foukouda/OPEN_PHASE/Schematic/OPEN_PHASE-schematic-10.pdf

1 | 2 | 3 | 4 | 5 | 6 | 7 | 8
1 | 2 | 3 | 4 | 5 | 6 | 7 | 8

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
F 10

Sheet: of 10
Size: A3
Revision: + (Unreleased) Date: Project Name: 2026-10-05 Reviewer: Designer: Revision History.kicad_sch | SIEBERT DIMITRY
Board Name: Company: | Variant: OPEN THRUST LAB PHASETRACKER | OPEN_PHASE
Sheet Title: | File Name:
/Revision History/ Sheet Path: Revision History Comments: | Git Hash: 04dd92c

___________________________________ Added

- 4x PBV 1 mOhm shunt + INA241A2 (20 V/V)
- 4x voltage divider 40.2k / 10k
- AD7606C-18 ADC, 8 inputs used
- +3.3V -> LT8362 6 V -> LT3045-1 +5VA / +2.5VA
- Self-contained libs and 3D models (lib/)
- LTspice simulations (Simulation/LTspice)
- Predicted measurement quality (sim 07, 08)
- openEMS shunt inductance model (Simulation/openEMS)
- Thermal / current density model (Simulation/Thermal)
- 3D animation (Images/OPEN_PHASE.mp4)
- J4 host header 2x8: AD7606C serial, software mode
- Test points TP1-TP16
- 4x rail indicator LED (D1, D3-D5), about 1 mA each
- Silkscreen: rail names at the LEDs, test point tags, OSHW logo
- 100 Ohm in series on the 11 J4 lines: RN1, RN2 (4x0603 array, as OPEN_WEIGHT), R39-R41, bottom side
- 100k pull-up on CS (R42), pull-downs on CONVST (R43) and RESET (R44) ___________________________________ Changed
- Renamed to OPEN_PHASE, KiCad 10
- Sheets named after their function
- IC3: LTC6655LN-2.5 -> LTC6655-2.5 (pin 6 = VOUT_S)
- R12: 49.9k -> 24.9k (+2.5VA = 2.500 V)
- L1: 744373965022 -> WE-MAPI 4030 74438357022 (4.1 x 4.1 mm)
- Solder mask white, silkscreen black
- Nets renamed SHUNT_*, INA_*, ADC_*
- IC1 AGND pin 26, REFGND pin 46 to GND
- IC8, IC9: thermal vias on exposed pad 13
- Licence: MIT -> CERN-OHL-P v2
- README / HTML logo: INGENIERIE FRANCE badge
- TP15 / TP16 on the AD7606C side of the series resistors ___________________________________ Fixed
- +5VA via of R36 sat on the ADC_CS track (short): bus rerouted around it

# [10] Revision History

Version Unreleased
