foukouda/OPEN_PHASE/Schematic/OPEN_PHASE-schematic-5.pdf

1 | 2 | 3 | 4 | 5 | 6 | 7 | 8

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
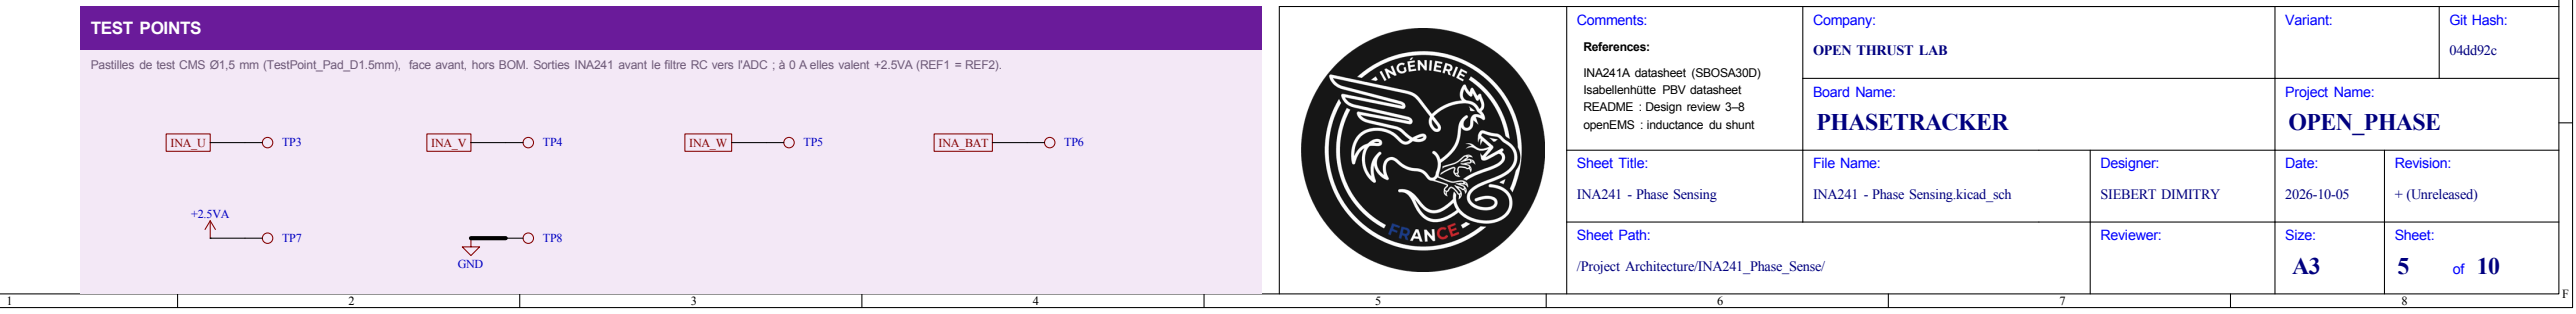
[picture p13: figure]
Sheet: of 10; Size: A3; Sheet Title:; File Name:; GND; INA_W; INA_BAT; INA_U; INA_V; TEST POINTS; openEMS : inductance du shunt; README : Design review 3–8; Isabellenhütte PBV datasheet

Revision: + (Unreleased) Date: Project Name: 2026-10-05 Reviewer: Designer: INA241 - Phase Sensing.kicad_sch | SIEBERT DIMITRY
Board Name: Company: | Variant: OPEN THRUST LAB PHASETRACKER | OPEN_PHASE
/Project Architecture/INA241_Phase_Sense/ Sheet Path: INA241 - Phase Sensing Comments: | Git Hash: 04dd92c

R19
9.1kΩ

R27
40.2kΩ

R32

# 40.2kΩ Re3 1kΩ

+2.5VA

C18 1µF C31

180 pF C0G/NP0, 50 V, 0603

# C17 0.1µF C2 0.1µF R28 10kΩ C40

180 pF C0G/NP0, 50 V, 0603 C34

180 pF C0G/NP0, 50 V, 0603 C10 1µF +2.5VA

R29

# 9.1kΩ R22

40.2kΩ

IN- 1 | GND 2 | REF2 3 | NC 4 | OUT | 5 VS | 6 REF1 | 7
| | | | IN+ | | | 8

IC2
INA241A2IDGKR

1

1

2

2

3

3

4

4 R1 PBV-R001-F1-1.0 +2.5VA

+2.5VA | +5VA
C33 | 1nF C0G

R21
9.1kΩ Re2
1kΩ | C42 | 1nF C0G

+2.5VA

IN- 1 | GND 2 | REF2 3 | NC 4 | OUT | 5 VS | 6 REF1 | 7
| | | | IN+ | | | 8

IC4
INA241A2IDGKR
C16 | 1µFC3 0.1µF
IN- 1 | GND 2 | REF2 3 | NC 4 | OUT | 5 VS | 6 REF1 | 7
| | | | IN+ | | | 8

IC10
INA241A2IDGKR

+2.5VA

+2.5VA

IN- 1 | GND 2 | REF2 3 | NC 4 | OUT | 5 VS | 6 REF1 | 7
| | | | IN+ | | | 8

IC6
INA241A2IDGKR

R18 10kΩ

+5VA

R15
33Ω

+5VA

R16

# 9.1kΩ R20

33Ω C29 | 1nF C0G
C25 | 1nF C0G
C1 0.1µF | R26

# 9.1kΩ R30

33Ω R25
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
4 R7 PBV-R001-F1-1.0 R31

9.1kΩ

1

1

2

2

3

3

4

4 R4 PBV-R001-F1-1.0

1

1

2

2

3

3

4

# 4 R9 PBV-R001-F1-1.0 TP3

C5 | 1µF R23 10kΩ | C32

180 pF C0G/NP0, 50 V, 0603

R17
40.2kΩ

R24
9.1kΩ

+2.5VA

Re4

# 1kΩ R34

9.1kΩ R33 10kΩ

+5VA

Re1
1kΩ

INA_V

SHUNT_U+

# SHUNT_V+ OUT-B

SHUNT_BAT- OUT-W
OUT-W

SHUNT_W-

SHUNT_W+

ADC_U_V+
ADC_U_V-

SHUNT_BAT-

IN-B

IN-W

# SHUNT_W- OUT-B

SHUNT_BAT+

SHUNT_U-

ADC_V_V-

ADC_V_V+

INA_BAT

IN-V

SHUNT_BAT+

ADC_W_V+

SHUNT_V- OUT-U
SHUNT_U+

ADC_W_V-

INA_BAT

OUT-U

ADC_BAT_V+
ADC_BAT_V-

INA_W

SHUNT_W+

OUT-V

ADC_BAT_I+

ADC_W_I+

SHUNT_V-

ADC_W_I-

ADC_V_I-

INA_W

OUT-V
SHUNT_V+
INA_V | ADC_V_I+

ADC_U_I+

ADC_BAT_I-

INA_U

IN-U

INA_U

SHUNT_U-ADC_U_I-

## FILTRES · VOIES COURANT

## DESIGN NOTE · GAIN ET SHUNT

Voie courant (×4) V = 2.5 V − G × Rs × I = 2.5 V − 20 V/V × 1 mΩ × I = 2.5 V − 20 mV/A × I 35 A → ±0.7 V ; saturation vers ±115 A

fc = 1 / (2π × R16 × C25) = 1 / (2π × 9.1 kΩ × 1 nF) = 17.5 kHz Offset : I(V−) = (0 − 2 V) / 1.2 MΩ = −1.7 µA → V− = 1.7 µA × 9.1 kΩ = 15 mV ≈ 0.75 A

Shunt : P = I² × Rs = 35² × 1 mΩ = 1.23 W → +18 K (Rth < 15 K/W)
Inductance : R = 2π f L → f = 1 mΩ / (2π × 2.4 nH) ≈ 66 kHz Voie tension (×4) k = R18 / (R17 + R18) = 10 / 50.2 = 0.1992 → 25 V = 4.98 V

Source : R17 // R18 + Re1 = 8.01 kΩ + 1 kΩ = 9.01 kΩ ≈ R19 = 9.1 kΩ fc = 1 / (2π × (9.01 + 9.1) kΩ × 180 pF) ≈ 48.8 kHz (sim 05 : 48.5 kHz) Gain réel : 0.1992 × 1.2 MΩ / (1.2 MΩ + 9.01 kΩ) = 0.1977 (−0.75 %)

Budget 4 × INA241A2 × 2.5 mA = 10 mA sur +5VA

Pertes : 1.23 W par shunt à 35 A

## DESCRIPTION

## CALCULS & BUDGET

- IN+ / IN− pris sur les broches de mesure 2 et 3 du shunt (Kelvin), pas sur le cuivre de puissance ; paire serrée jusqu'à l'INA241. • Boucle de mesure la plus petite possible : 1 nH vaut R = 1 mΩ à 160 kHz. • C17/C18 au plus près de VS / GND. Filtres près des entrées de l'AD7606C. • Shunt : 1.2 W à 35 A, refroidi par le cuivre des phases. • Exemple TI ci-contre (INA240-Q1, même brochage) : ici REF1/REF2 vont au +2.5VA, pas à la masse.

Mesure du courant des trois phases (U, V, W) et de la batterie (B), et de la tension des mêmes lignes. Le courant traverse un shunt 4 fils de 1 mΩ (R1 / R4 / R7 / R9, Isabellenhütte PBV). L'INA241A2 lit la tension entre les deux broches de mesure du shunt (Kelvin) et l'amplifie 20 fois autour du +2.5VA : V = 2.5 V − 20 mV/A × I(J1→J2), J3→J5 pour la

batterie. Pourquoi l'INA241 : la tension de mode commun d'une phase saute de 0 à VBAT à chaque front du PWM de l'ESC. L'INA241

accepte −5 V à 110 V de mode commun, a un rejet PWM renforcé (CMRR 166 dB DC, 104 dB à 100 kHz), ±10 µV d'offset et ±0.01 % d'erreur de gain (version A). Un pont 40.2 kΩ / 10 kΩ par ligne ramène la tension (côté J2 / J5) dans la plage de l'AD7606C. Noms des signaux, x = U, V, W ou BAT : SHUNT_x± prises Kelvin du shunt vers IN± de l'INA241 → INA_x sortie de l'INA241

(TP3 à TP6) → filtre RC → ADC_x_I± (courant). Pont → ADC_x_V± (tension). Vers l'AD7606C page 4.

INA241A1 : 10 V/V
INA241A2 : 20 V/V (monté)
INA241A3 : 50 V/V
INA241A4 : 100 V/V
INA241A5 : 200 V/V
- Avec 1 mΩ et 20 V/V : 20 mV/A, saturation vers ±115 A. 35 A n'utilise que ±0.7 V des ±2.5 V : un A3 (50 V/V, ±46 A) donnerait 2.5 × plus de résolution (Design review 4). • REF1 = REF2 = +2.5VA : zéro au milieu, mesure dans les deux sens (freinage, récupération). • Shunt PBV-R001 : 1 mΩ 4 fils, < 75 ppm/K, Rth < 15 K/W, inductance < 10 nH (openEMS : 2.3 à 2.7 nH sur ce routage). • NC (broche 4) laissée ouverte : la datasheet demande GND (Design review 3).

## LAYOUT NOTE

## DESIGN NOTE · VOIES VERS L'AD7606C

- Courant : R15 33 Ω isole la sortie de l'INA241 de la capacité. Filtre différentiel : C25 1 nF C0G entre V+ et V−, V− à la masse par R16 9.1 kΩ → 17.5 kHz. • R16 et le courant d'entrée de l'ADC donnent 15 mV d'offset (≈ 0.75 A) : calibration du zéro ; ne pas réduire R16 sans

recalculer le filtre (Design review 5). • Tension : R17 40.2 kΩ / R18 10 kΩ → 0.1992 (25 V → 4.98 V). Re1 1 kΩ + R19 9.1 kΩ + C31 180 pF C0G : 48.5 kHz. V+ et V− voient ~9 kΩ : les courants d'entrée de l'ADC s'annulent. • Gain réel 0.1977 (−0.75 %, entrée 1.2 MΩ de l'ADC) : à calibrer (Design review 6). • C0G : capacité stable en tension et en température, le filtre ne bouge pas. • Courant à 17.5 kHz, tension à 48.5 kHz : retard entre les deux voies à mesurer sur la 1re carte (Design review 8). • VS : C17 0.1 µF + C18 1 µF par INA241. Pastilles de test CMS Ø1,5 mm (TestPoint_Pad_D1.5mm), face avant, hors BOM. Sorties INA241 avant le filtre RC vers l'ADC ; à 0 A elles valent +2.5VA (REF1 = REF2).

# [5] INA241 - Phase Sensing

## INA241A2 + SHUNT 1 mΩ · 4 VOIES : U, V, W, BATTERIE

References: ADC V4 courant · V3 tension PHASE

W

# Voie 3 · shunt R7 · IC6 ADC V2 courant · V1 tension

INA241A datasheet (SBOSA30D) (https://www.ti.com/product/INA241A) Voie 4 · shunt R9 · IC10 BATTERIE

ADC V8 courant · V7 tension PHASE

V

# Voie 2 · shunt R4 · IC4 ADC V6 courant · V5 tension PHASE

U

Voie 1 · shunt R1 · IC2

R33 10kΩ R34

# 9.1kΩ Re4

1kΩ C40

180 pF C0G/NP0, 50 V, 0603 R32
40.2kΩ

IC2
INA241A2IDGKR
IN- 1 | GND 2 | REF2 3 | NC 4 | OUT | 5 VS | 6 REF1 | 7
IN+ | 8 +2.5VA
+2.5VA | +5VA

Re2
1kΩ R22
40.2kΩ

+2.5VA

IC4
INA241A2IDGKR
IN- 1 | GND 2 | REF2 3 | NC 4 | OUT | 5 VS | 6 REF1 | 7
IN+ | 8 | C16 | 1µFC3 0.1µF

IC10
INA241A2IDGKR
IN- 1 | GND 2 | REF2 3 | NC 4 | OUT | 5 VS | 6 REF1 | 7
IN+ | 8 +2.5VA

+2.5VA

IC6
INA241A2IDGKR
IN- 1 | GND 2 | REF2 3 | NC 4 | OUT | 5 VS | 6 REF1 | 7
IN+ | 8 R27
40.2kΩ | Re3
| 1kΩ

+2.5VA

C18 1µF C31

180 pF C0G/NP0, 50 V, 0603 R19
9.1kΩ | C2 0.1µF R28 10kΩ | C34
180 pF C0G/NP0, 50 V, 0603 C10 | 1µF +2.5VA

R29

# 9.1kΩ C32

180 pF C0G/NP0, 50 V, 0603 C1 0.1µF R23 10kΩ | C5 | 1µF R24

9.1kΩ

+2.5VA | +5VA

Re1
1kΩ R17
40.2kΩ R18 10kΩ

+5VA

+5VA

R30

33Ω R25

# 33Ω C42 1nF C0G

R31

# 9.1kΩ R26

9.1kΩ

C25 | 1nF C0G
C29 | 1nF C0G

R20

33ΩR16

# 9.1kΩ R15

33ΩR21

# 9.1kΩC33 1nF C0G
