foukouda/OPEN_PHASE/Schematic/OPEN_PHASE-schematic-8.pdf

1 | 2 | 3 | 4 | 5 | 6 | 7 | 8

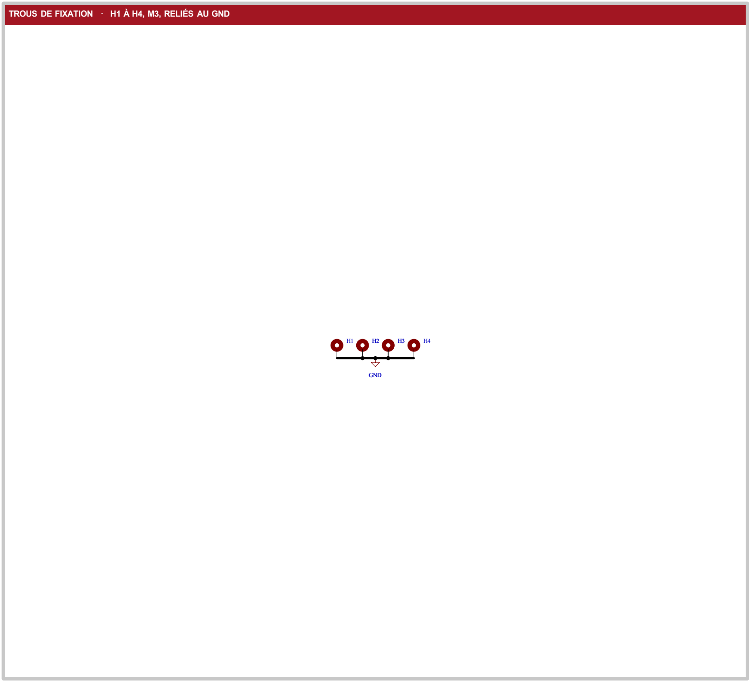
[picture p15: figure]
GND; H3 GND

1 | 2 | 3 | 4 | 5 | 6 | 7 | 8

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
### Sheet: of 10 Size: A3

Revision: + (Unreleased) Date: Project Name: 2026-10-05 Reviewer: Designer: Holes - Fiducials.kicad_sch | SIEBERT DIMITRY
Board Name: Company: | Variant: OPEN THRUST LAB PHASETRACKER | OPEN_PHASE
Sheet Title: | File Name:
/Project Architecture/Holes, Fiducials/ Sheet Path: Holes - Fiducials Comments: | Git Hash: 04dd92c
H1 | H2 | H3 | H4 TROUS DE FIXATION · H1 À H4, M3, RELIÉS AU GND
- Empreinte MountingHole_3.2mm_M3_Pad_Via : perçage 3.2 mm, pastille Ø6.4 mm, 8 vias Ø0.5 mm autour pour relier toutes les couches. • Reliés au GND : la vis met la masse de la carte au potentiel du support. Pour garder une masse flottante, utiliser des entretoises isolantes. • Fiducials : aucun pour l'instant ; à ajouter (3 en coin, 1 mm de cuivre, 2 mm d'ouverture de vernis) si l'assembleur les demande. CALCULS & BUDGET

Quatre trous de fixation M3 (H1 à H4), métallisés et reliés au GND. Ils tiennent la carte et peuvent ramener sa masse au support quand celui-ci est conducteur. Pas de fiducial sur cette révision. DESCRIPTION

## LAYOUT NOTE

## DESIGN NOTE · FIXATION

Vis M3 Tête bombée ISO 7380 : Ø5.7 mm ; tête cylindrique ISO 4762 : Ø5.5 mm

Rondelle M3 (ISO 7089) : Ø7 mm → anneau libre de Ø7 mm autour de chaque trou Pastille Ø6.4 mm : la rondelle appuie sur le cuivre GND

- Garder libre l'appui de la tête de vis et de la rondelle autour de chaque trou. • Pas de composant sensible aux contraintes mécaniques près des trous (LTC6655, page 6).

# [8] Holes - Fiducials

## TEST POINTS

Zone réservée aux test points. Les pastilles GND des trous peuvent servir de point de masse pour la sonde. | README : Physical specifications (https://github.com/foukouda/OPEN_PHASE#physical-specifications) References:
