foukouda/OPEN_PHASE/Schematic/OPEN_PHASE-schematic-9.pdf

1 | 2 | 3 | 4 | 5 | 6 | 7 | 8

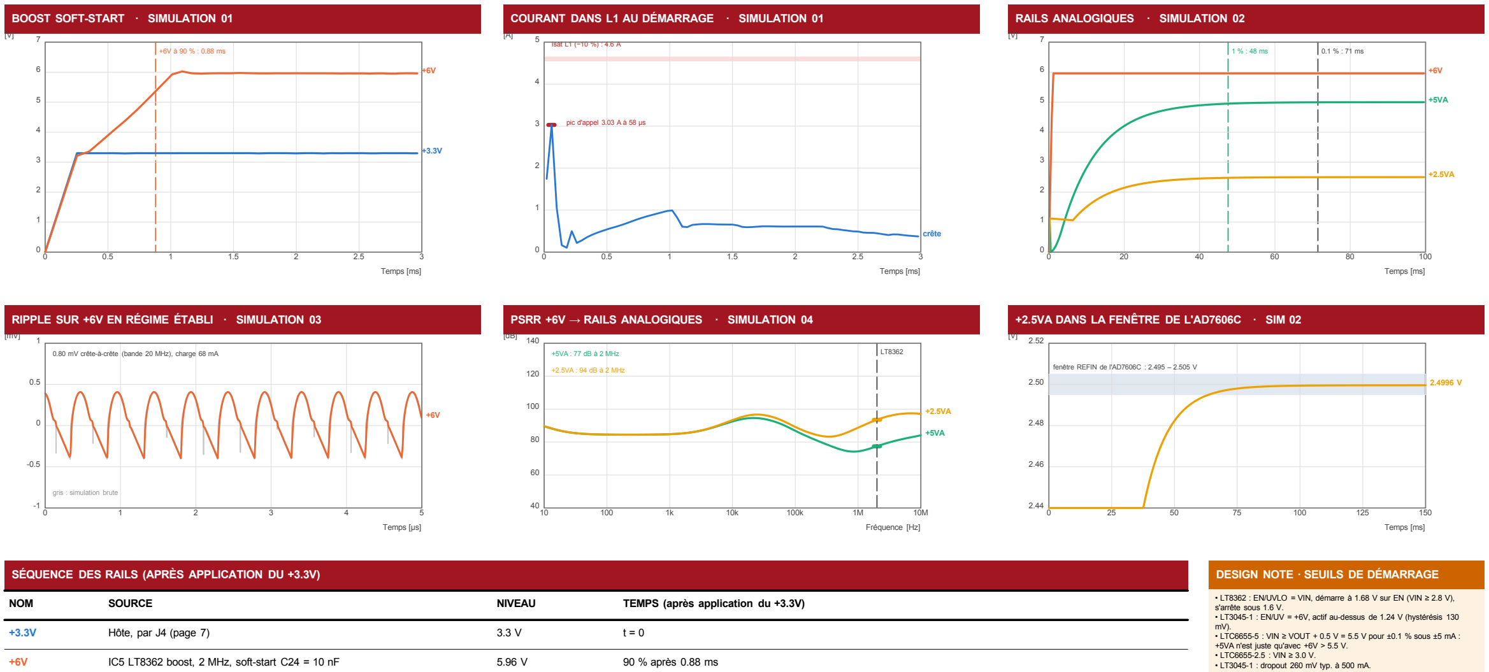
[picture p16: figure]
RAILS ANALOGIQUES · SIMULATION 02; BOOST SOFT-START · SIMULATION 01; NIVEAU; Hôte, par J4 (page 7); 100+2.5VA NOM; SOURCE; Temps [µs] 0; Temps [ms] gris : simulation brute; 0.80 mV crête-à-crête; (bande 20 MHz), charge; Temps [ms] 10; Fréquence [Hz]; +5VA : 77 dB à 2 MHz 80; Isat L1 (−10 %) : 4.6 A; pic d'appel 3.03 A à 58 µs 4; Temps [ms] 1.5; crête; Temps [ms] 2.5; +2.5VA : 94 dB à 2 MHz
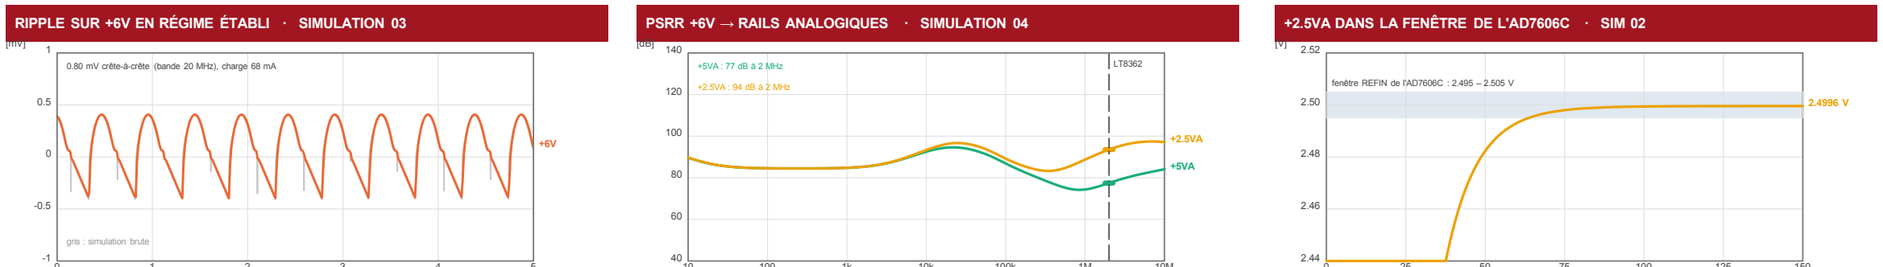
[picture p17: figure]

1 | 2 | 3 | 4 | 5 | 6 | 7 | 8

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
### Sheet: of 10 Size: A3

Revision: + (Unreleased) Date: Project Name: 2026-10-06 Reviewer: Designer: Power - Sequencing.kicad_sch | SIEBERT DIMITRY
Board Name: Company: | Variant: OPEN THRUST LAB PHASETRACKER | OPEN_PHASE
Sheet Title: | File Name:
/Power - Sequencing/ Sheet Path: Power - Sequencing Comments: | Git Hash: 04dd92c DESIGN NOTE · +2.5VA ET R12

## +2.5VA DANS LA FENÊTRE DE L'AD7606C · SIM 02

Ordre et temps d'établissement des rails après l'arrivée du +3.3V (simulations LTspice 01 à 04). Le boost monte en premier : +6V à 90 % en 0.88 ms. Les références et les LDO suivent avec la

constante de temps du filtre SET (9.8 ms) : +5VA et +2.5VA arrivent ensemble, à 0.1 % après 71 ms. Aucun signal Power-Good : c'est l'hôte qui doit attendre. | [9] Power - Sequencing

## COURANT DANS L1 AU DÉMARRAGE · SIMULATION 01

## SÉQUENCE DES RAILS (APRÈS APPLICATION DU +3.3V)

## PSRR +6V → RAILS ANALOGIQUES · SIMULATION 04

1. Appliquer le +3.3V : le boost démarre seul (EN/UVLO = VIN). 2. Attendre ≥ 100 ms : rails à 0.1 %, pas de Power-Good. 3. Reset complet de l'AD7606C : RESET haut ≥ 3.2 µs. Première

conversion 2 s au plus tôt après la mise sous tension (datasheet, Table 3). 4. Mode logiciel (câblé) : CONFIG 0x02 = 0x10 (4 lignes DOUT), plages ±5 V différentielles (0x03–0x06 = 0x88), suréchantillonnage. 5. Mesurer le zéro des 4 courants à courant nul (offset 15 mV, Design

review 5), puis lancer CONVST. CHRONOLOGIE DU DÉMARRAGE (ÉCHELLE LOG) | SÉQUENCE CÔTÉ HÔTE (RECOMMANDÉE)

## DESCRIPTION

R12 = 24.9 kΩ : 100 µA × 24.9 kΩ = 2.49 V, +2.5VA = 2.4996 V, dans la fenêtre 2.495–2.505 V de l'AD7606C. L'ancienne valeur 49.9 kΩ donnait 2.549 V (corrigé, README Design review).

## DESIGN NOTE · DÉMARRAGE

Pas de signal Power-Good (PGFB relié à IN) : attendre au moins 100 ms après la mise sous

tension avant le reset de l'AD7606C, puis jusqu'à 2 s pour la première conversion (datasheet, Table 3). Le fast start-up des LT3045-1 est désactivé par le même branchement. | DESIGN NOTE · SEUILS DE DÉMARRAGE

Boost : soft-start C24 = 10 nF chargé à 2 µA, +6V à 90 % en 0.88 ms Rails : τ = (R8 // R14) × C13 = 980 Ω × 10 µF = 9.8 ms 1 % : ln(100) × τ = 45 ms (sim : 48 ms) ; 0.1 % : ln(1000) × τ = 68 ms (sim : 71 ms)

Appel : 3.03 A crête dans L1 / D2 (front du +3.3V en 100 µs) < Isat 4.6 A

- LT8362 : EN/UVLO = VIN, démarre à 1.68 V sur EN (VIN ≥ 2.8 V), s'arrête sous 1.6 V. • LT3045-1 : EN/UV = +6V, actif au-dessus de 1.24 V (hystérésis 130 mV). • LTC6655-5 : VIN ≥ VOUT + 0.5 V = 5.5 V pour ±0.1 % sous ±5 mA : +5VA n'est juste qu'avec +6V > 5.5 V. • LTC6655-2.5 : VIN ≥ 3.0 V. • LT3045-1 : dropout 260 mV typ. à 500 mA. CALCULS & BUDGET

## RIPPLE SUR +6V EN RÉGIME ÉTABLI · SIMULATION 03

## IC5 LT8362 boost, 2 MHz, soft-start C24 = 10 nF

## IC7 LTC6655-5 -> R8 -> SET of IC8 LT3045-1

5.000 V

10 µs | 0.1 msmême constante de temps 1 % : 48 ms, 0.1 % : 71 ms +2.5VA

# +6V Hôte +5VA

90 % à 0.88 ms

RESET (1re conversion à 2 s) +5VA

+2.5VA | IC3 LTC6655-2.5 -> R11 -> SET of IC9 LT3045-1 | 2.500 V

1 ms

10 ms | 100 ms

1 s

attente ≥ 100 ms

fenêtre REFIN de l'AD7606C : 2.495 – 2.505 V

## 1k 1 % après 48 ms, 0.1 % après 71 ms (τ = 9.8 ms)

90 % après 0.88 ms TEMPS (après application du +3.3V) ¹⁰k même constante de temps que +5VA
