foukouda/OPEN_PHASE/HTML/images/cat_pdf_drill_map_OPEN_PHASE-NPTH_drill_map.png

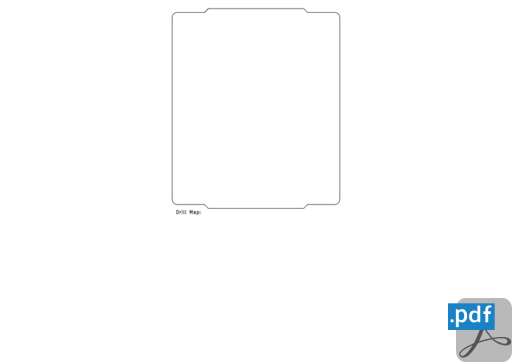
HTML/images/cat_pdf_drill_map_OPEN_PHASE-NPTH_drill_map.png
