foukouda/OPEN_PHASE/HTML/images/cat_pdf_drill_map_OPEN_PHASE-PTH_drill_map.png

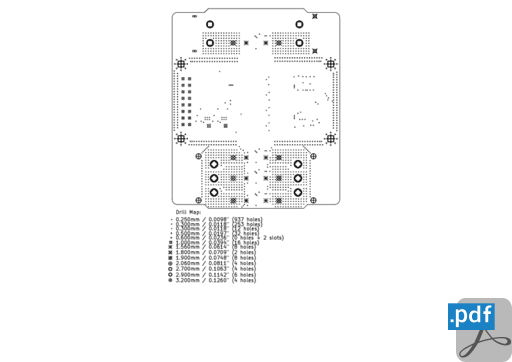
HTML/images/cat_pdf_drill_map_OPEN_PHASE-PTH_drill_map.png
