foukouda/OPEN_PHASE/HTML/images/cat_pdf_schematic_OPEN_PHASE-schematic.png

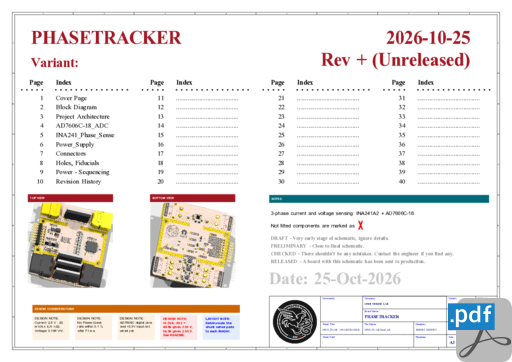
HTML/images/cat_pdf_schematic_OPEN_PHASE-schematic.png
