foukouda/OPEN_PHASE/HTML/images/cat_png_3d_viewer_bottom_OPEN_PHASE-bottom.png

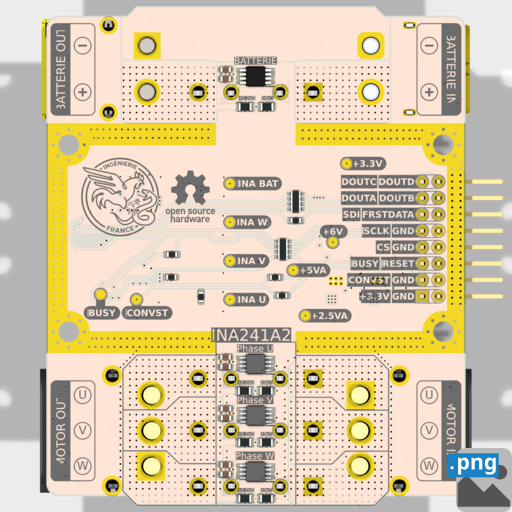
HTML/images/cat_png_3d_viewer_bottom_OPEN_PHASE-bottom.png
