foukouda/OPEN_PHASE/HTML/images/cat_png_3d_viewer_top_OPEN_PHASE-top.png

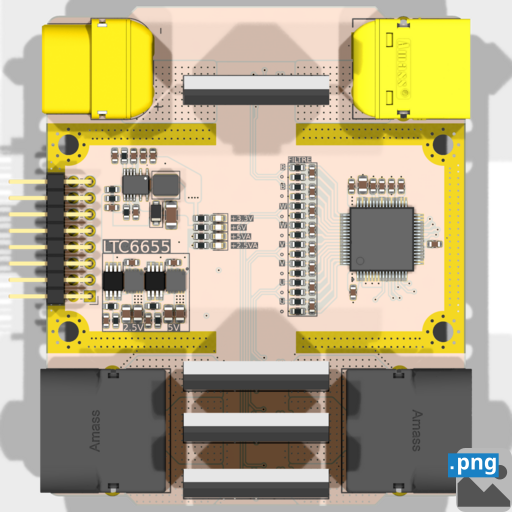
HTML/images/cat_png_3d_viewer_top_OPEN_PHASE-top.png
