foukouda/OPEN_PHASE/Images/Simulation/openems_shunt_field.png

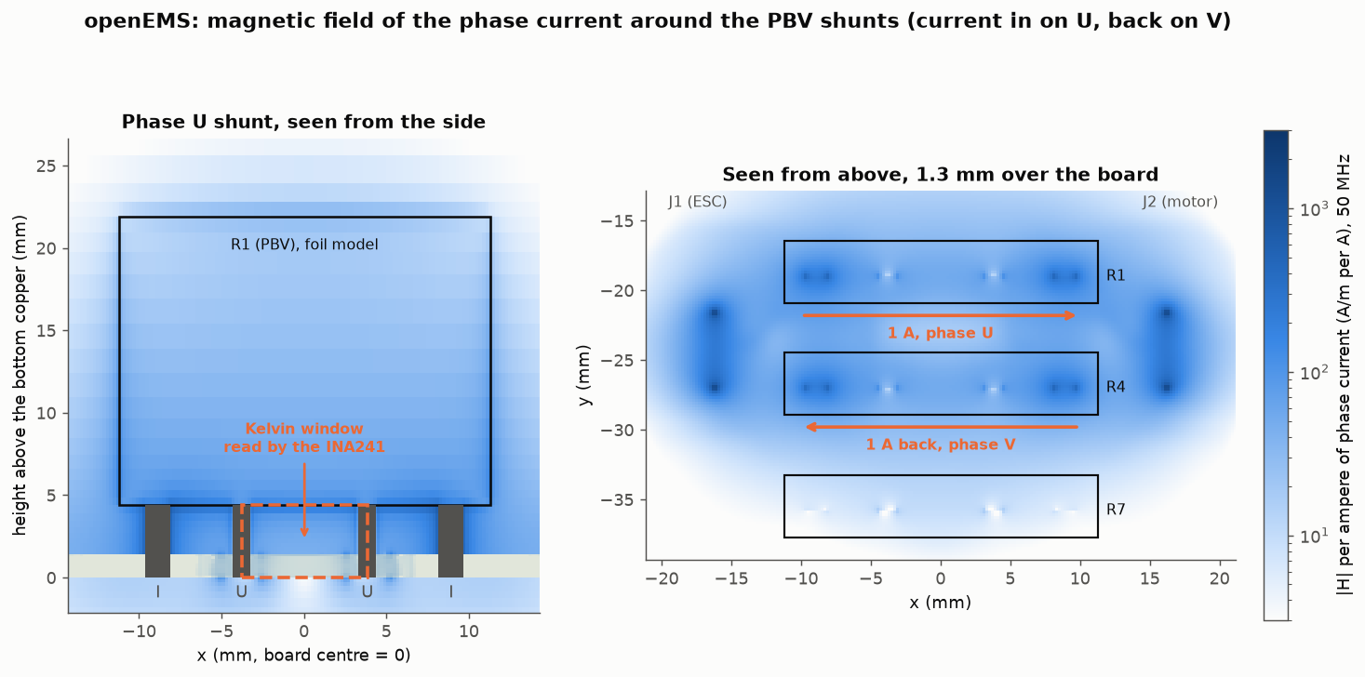
Images/Simulation/openems_shunt_field.png
