foukouda/OPEN_PHASE/Images/Simulation/openems_shunt_inductance.png

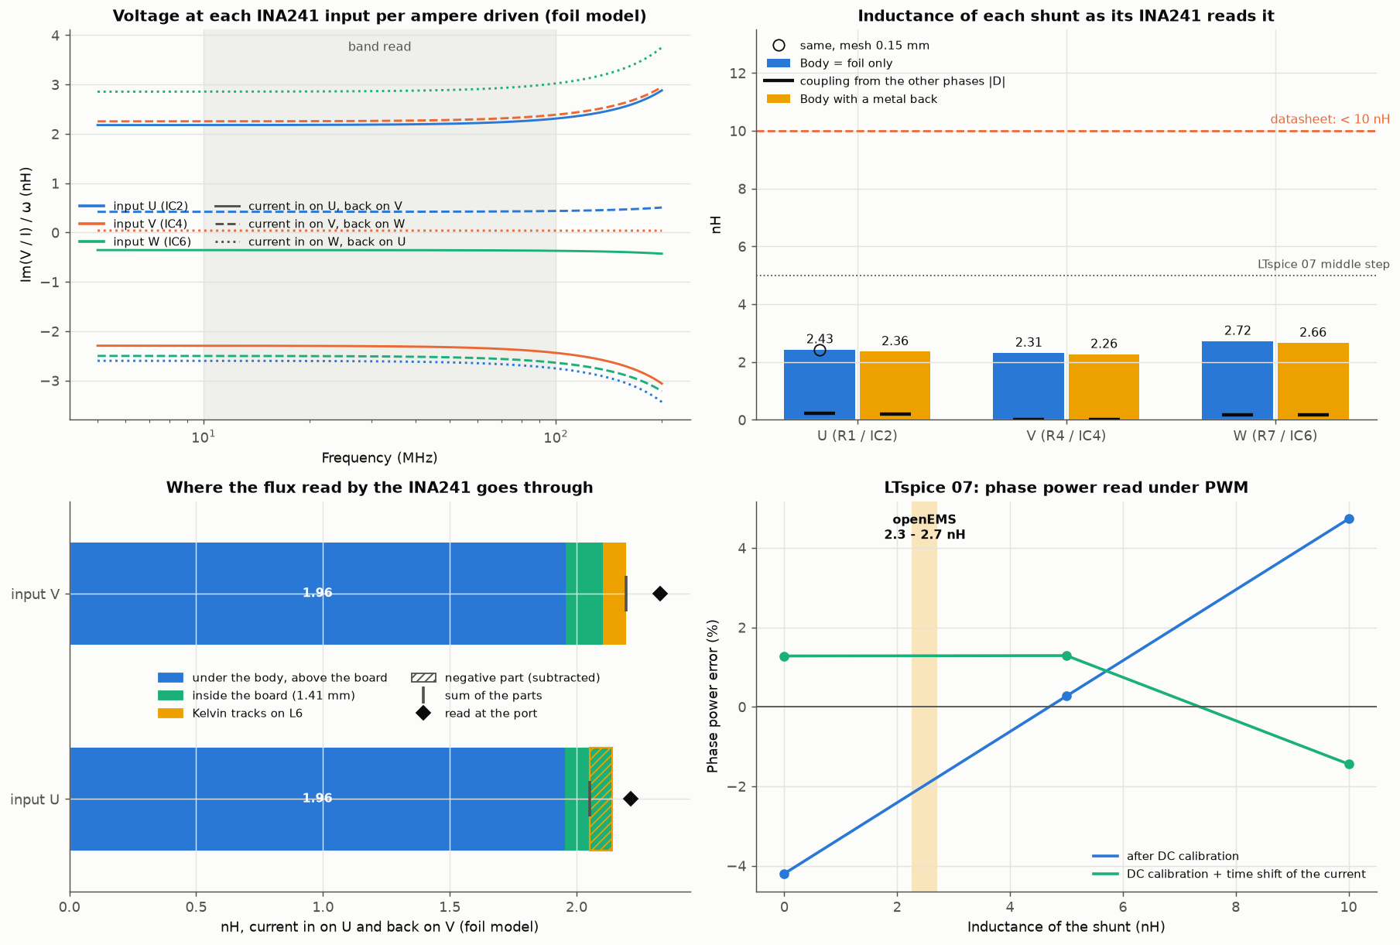
Images/Simulation/openems_shunt_inductance.png
