foukouda/OPEN_PHASE/Images/Simulation/sim07_dc_bus.png

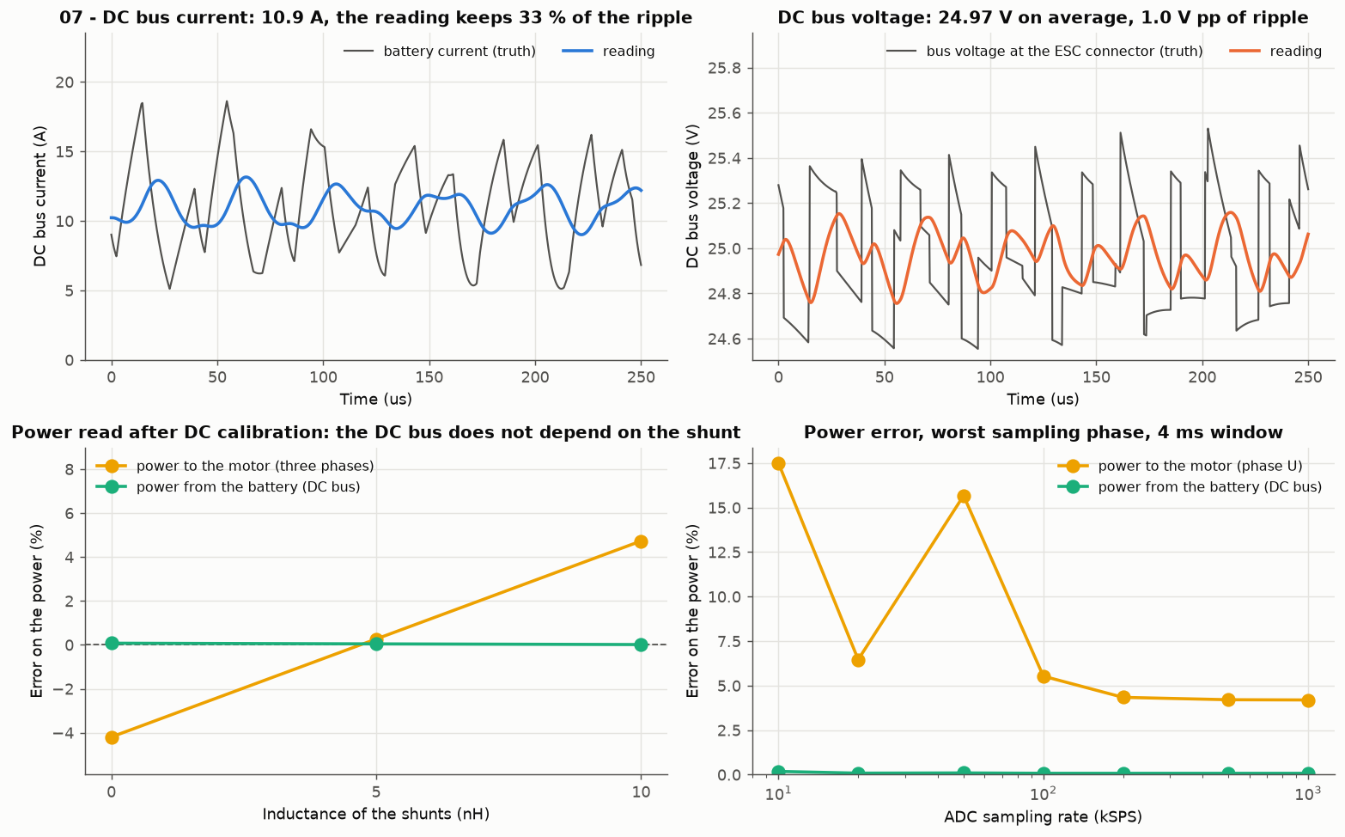
Images/Simulation/sim07_dc_bus.png
