foukouda/OPEN_PHASE/Images/Simulation/thermal_current_density.png

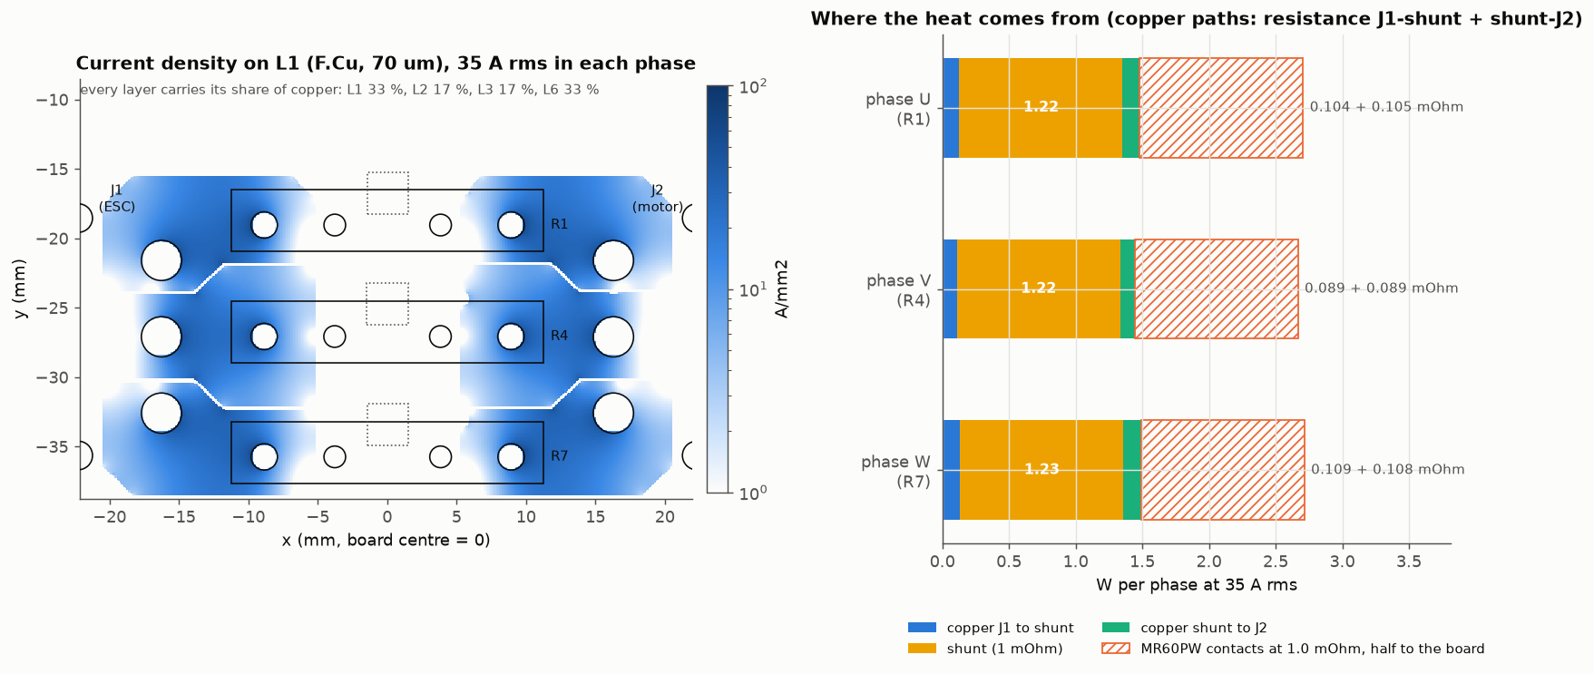
Images/Simulation/thermal_current_density.png
