foukouda/OPEN_PHASE/Images/Simulation/thermal_temperature.png

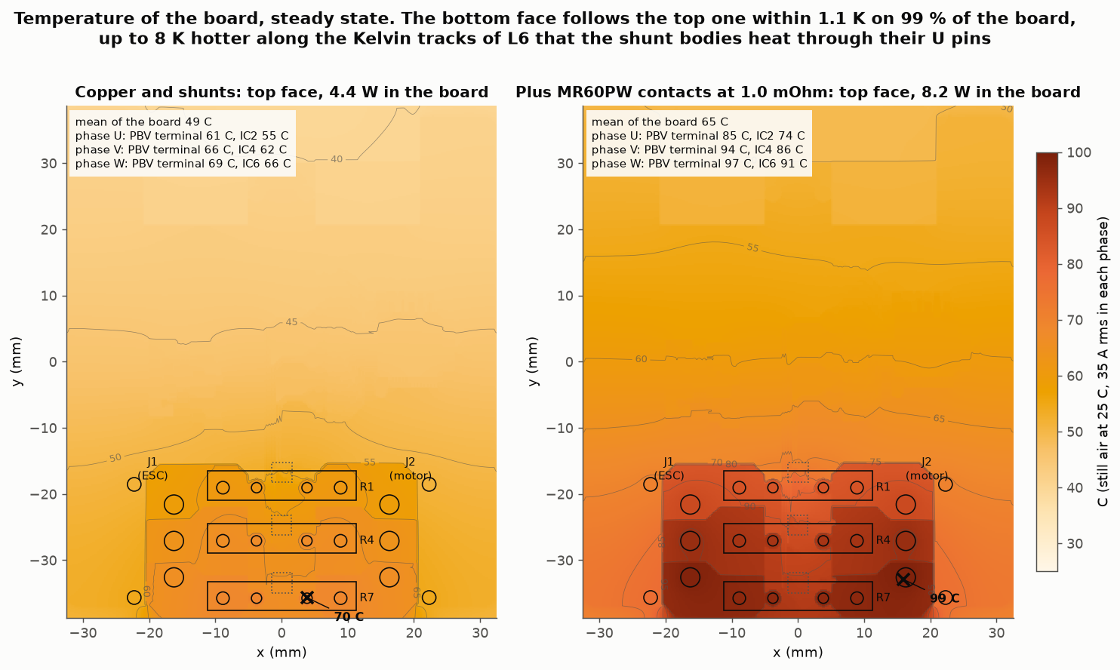
Images/Simulation/thermal_temperature.png
