foukouda/OPEN_PHASE/Images/Simulation/thermal_vs_current.png

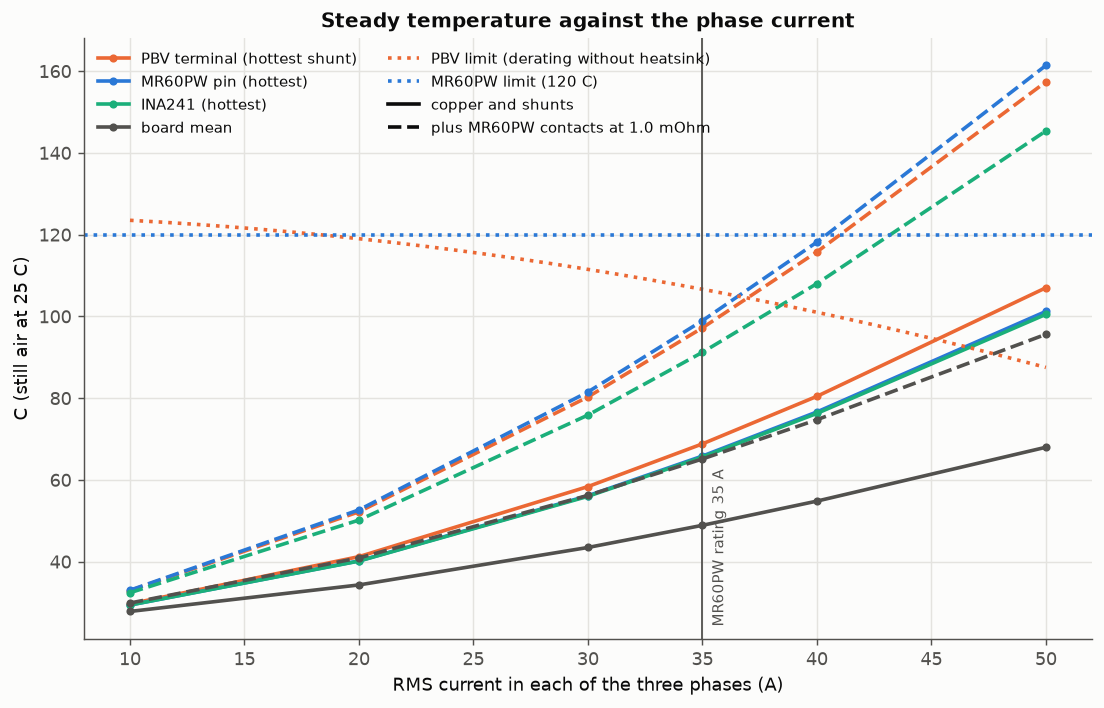
Images/Simulation/thermal_vs_current.png
