foukouda/OPEN_PHASE/Manufacturing/Assembly/OPEN_PHASE-bom.html

 | Bill of Materials
 | Schematic: OPEN_PHASE Variant: PRELIMINARY Revision: + (Unreleased) Date: 2026-10-06 KiCad Version: 10.0.5-unknown-202607221313~667fa36054~ubuntu25.10.1 | Component Groups: 40 Component Count: 108 (per PCB) Fitted Components: 108 (per PCB) Number of PCBs: 1 Total Components: 108 (for 1 PCBs)
Row | Quantity Per PCB | References | Value | Datasheet | Footprint | Description | Manufacturer | Manufacturer Part Number | Supplier Part Number
1 | 1 | C28 | 4,7 pF C0G 0603 |  | C_0603_1608Metric | Unpolarized capacitor
2 | 4 | C31 C32 C34 C40 | 180 pF C0G/NP0, 50 V, 0603 |  | C_0603_1608Metric | Unpolarized capacitor
3 | 5 | C25 C26 C29 C33 C42 | 1nF C0G |  | C_0603_1608Metric | Unpolarized capacitor
4 | 1 | C24 | 10 nF X7R 0603 |  | C_0603_1608Metric | Unpolarized capacitor
5 | 10 | C1 C2 C3 C17 C20 C21 C23 C35 C38 C41 | 0.1µF |  | C_0603_1608Metric | Unpolarized capacitor
6 | 7 | C5 C10 C16 C18 C27 C36 C37 | 1µF |  | C_0603_1608Metric | Unpolarized capacitor
7 | 3 | C9 C11 C22 | 4.7µF |  | C_0603_1608Metric | Unpolarized capacitor
8 | 7 | C8 C12 C13 C14 C15 C19 C39 | 10µF |  | C_0603_1608Metric | Unpolarized capacitor
9 | 1 | C30 | 22 µF X7R 1206 |  | C_1206_3216Metric_Pad1.33x1.80mm_HandSolder | Unpolarized capacitor
10 | 4 | D1 D3 D4 D5 | LED |  | LED_0603_1608Metric | Light emitting diode
11 | 1 | D2 | PMEG2020EH | https://assets.nexperia.com/documents/data-sheet/PMEG2020EH_EJ.pdf | D_SOD-123F | 20V, 2A very low Vf MEGA Schottky barrier rectifier, SOD-123F
12 | 1 | IC1 | AD7606C-18BSTZ | https://www.analog.com/media/en/technical-documentation/data-sheets/ad7606c-18.pdf | QFP50P1200X1200X160-64N | Analog to Digital Converters - ADC 8-ch DAS w/18-bit, bipola
13 | 4 | IC2 IC4 IC6 IC10 | INA241A2IDGKR | https://www.ti.com/lit/ds/symlink/ina241a.pdf?ts=1698648582718 | SOP65P490X110-8N | Current Sense Amplifier 1 Circuit Single-Ended 8-VSSOP
14 | 2 | IC8 IC9 | LT3045EDD-1#TRPBF | http://www.linear.com/docs/57863 | SON45P300X300X80-13N-D | LDO Voltage Regulators 20V, 500mA, Ultralow N, Ultrahigh PSRR L
15 | 1 | IC5 | LT8362EMSE#PBF | https://www.analog.com/media/en/technical-documentation/data-sheets/lt8362.pdf | LT8362EMSEPBF | Switching Voltage Regulators L IQ Boost/SEPIC/Inv Conv w/ 2A, 60V Swi
16 | 1 | IC3 | LTC6655BHMS8-2.5#PBF | https://www.analog.com/media/en/technical-documentation/data-sheets/LTC6655-6655LN.pdf | SOP65P490X110-8N | 0.25PPM N, L DRIFT PREC REFS
17 | 1 | IC7 | LTC6655BHMS8-5#PBF | http://www.analog.com/media/en/technical-documentation/data-sheets/6655ff.pdf | SOP65P490X110-8N | Voltage References Ultra Low Noise, 5V Precision Voltage Reference
18 | 2 | J1 J2 | MR60PW | https://www.tme.eu/Document/fd4b3517709a946d7b01cf4810656931/MR60PW-M.pdf | MR60PW | Connector: DC supply; socket; MR60; male; PIN: 3; on PCBs; THT; black
19 | 1 | J4 | PinHeader_2x08 | ~ | PinHeader_2x08_P2.54mm_Horizontal | Pin header, 2x08, 2.54 mm, horizontal (right angle), for Dupont jumper wires (odd pins row 1, even pins row 2). Host interface of the AD7606C-18 and +3.3V input
20 | 1 | J3 | XT60PW-F | https://www.tme.eu/Document/1191bc2fa3aee3c446e5a895fd8f7983/XT60PW-F.pdf | AMASS_XT60PW-F_1x02_P7.20mm_Horizontal | Connector: DC supply; socket; XT60; female; PIN: 2; on PCBs; THT; 30A
21 | 1 | J5 | XT60PW-M | https://www.tme.eu/Document/b13629717d44ae038681dba08d18c0b6/XT60PW-M.pdf | XT60PWM | Connector: DC supply; socket; XT60; male; PIN: 2; on PCBs; THT; 30A
22 | 1 | L1 | 74438357022 | https://www.we-online.com/components/products/datasheet/74438357022.pdf | L_Wuerth_MAPI-4030 | WE-MAPI SMT Power Inductor Size 4030; L = 2,2 µH; IRP,40K = 7,1 A; Isat,10% = 4,6 A; Isat,30% = 9,2 A; RDC = 22 mΩ typ / 26 mΩ max
23 | 4 | R15 R20 R25 R30 | 33Ω |  | R_0603_1608Metric | Resistor
24 | 3 | R39 R40 R41 | 100Ω |  | R_0603_1608Metric | Resistor
25 | 1 | R35 | 750Ω |  | R_0603_1608Metric | Resistor
26 | 6 | R8 R11 Re1 Re2 Re3 Re4 | 1kΩ |  | R_0603_1608Metric | Resistor
27 | 1 | R37 | 1.5kΩ |  | R_0603_1608Metric | Resistor
28 | 1 | R36 | 3.3kΩ |  | R_0603_1608Metric | Resistor
29 | 1 | R38 | 4.3kΩ |  | R_0603_1608Metric | Resistor
30 | 8 | R16 R19 R21 R24 R26 R29 R31 R34 | 9.1kΩ |  | R_0603_1608Metric | Resistor
31 | 4 | R18 R23 R28 R33 | 10kΩ |  | R_0805_2012Metric | Resistor
32 | 1 | R2 | 20kΩ |  | R_0603_1608Metric | Resistor
33 | 1 | R12 | 24.9kΩ |  | R_0603_1608Metric | Resistor
34 | 4 | R17 R22 R27 R32 | 40.2kΩ |  | R_0805_2012Metric | Resistor
35 | 1 | R14 | 49.9kΩ |  | R_0603_1608Metric | Resistor
36 | 3 | R42 R43 R44 | 100kΩ |  | R_0603_1608Metric | Resistor
37 | 2 | R3 R6 | 36,5kΩ |  | R_0603_1608Metric | Resistor
38 | 1 | R5 | 1MΩ |  | R_0603_1608Metric | Resistor
39 | 4 | R1 R4 R7 R9 | PBV-R001-F1-1.0 | https://cms.nacsemi.com/content/AuthDatasheets/Isabellehuette/PBV.pdf | PBVR001F110 | ISA-PLAN // Precision resistors Metal Film Resistor, 1 m, 3 W, +/-1 %
40 | 2 | RN1 RN2 | RP_100Ω |  | R_Array_Concave_4x0603 | 4 resistor network, parallel topology
Color reference for columns:
KiCad Fields (default)
Generated Fields
User Fields
Empty Fields
