foukouda/OPEN_PHASE/Testing/Testpoints/OPEN_PHASE-testpoints-bottom.csv

Ref. | Net | X [mm] | Y [mm]
TP1 | +2.5VA | 20.80 | 39.07
TP2 | GND | 20.80 | 35.52
TP3 | INA_U | 20.80 | 48.17
TP4 | INA_V | 20.80 | 44.62
TP5 | INA_W | 17.25 | 48.17
TP6 | INA_BAT | 17.25 | 44.62
TP7 | +2.5VA | 13.70 | 48.17
TP8 | GND | 13.70 | 44.62
TP9 | +3.3V | 26.35 | 48.17
TP10 | +6V | 26.35 | 44.62
TP11 | +5VA | 26.35 | 41.07
TP12 | +2.5VA | 26.35 | 37.52
TP13 | GND | 26.35 | 33.98
TP14 | GND | 15.25 | 39.07
TP15 | ADC_CONVST | 7.55 | 45.77
TP16 | ADC_BUSY | 7.55 | 42.23
