foukouda/OPEN_PHASE/3D/OPEN_PHASE.step

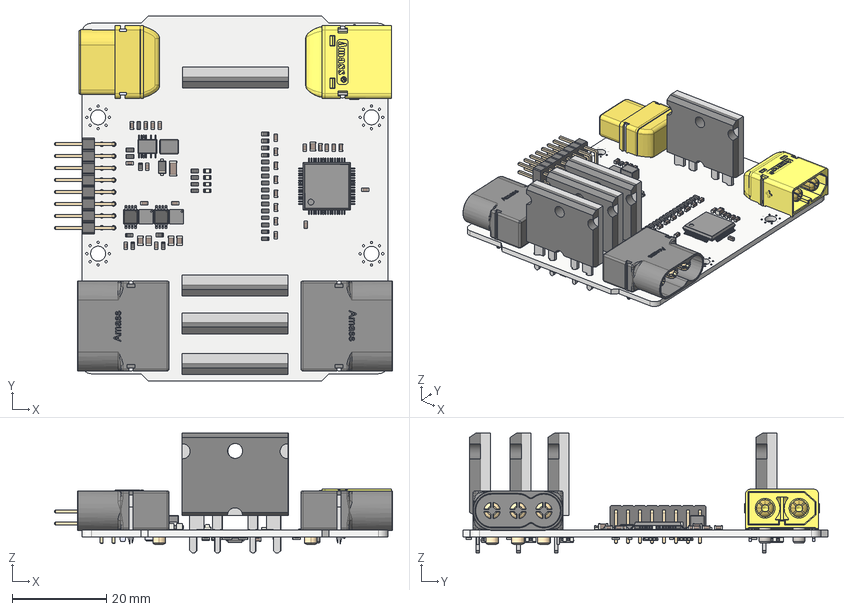
[picture p29: CAD file, 2026-10-25]
3D/OPEN_PHASE.step
71.8 x 77.5 x 25.5 mm
PBV-R100-F1-1.0 x 4
R_0603_1608Metric x 34
C_0603_1608Metric x 33
ThermalPin x 2
PinsArrayLR x 6
AD8421ARMZ x 3
PinsArrayTB
C_0805_2012Metric x 5
MR60PW-M x 2
PinHeader_2x08_P254mm_Horizontal
LED_0603_1608Metric x 4
XT60PW-M
XT60PW-F_XT60PW-F
D_SOD_123F
LT8362EMSE#PBF
C_1206_3216Metric
L_Wuerth_MAPI_4030
R_0805_2012Metric x 8
R_Array_Concave_4x0603 x 2
kibot_f_drkunk_PCB
