foukouda/OPEN_PHASE/Manufacturing/Fabrication/OPEN_PHASE-fabrication.pdf

# Top Fabrication (Scale 1:1)

# PHASETRACKER Fabrication Document

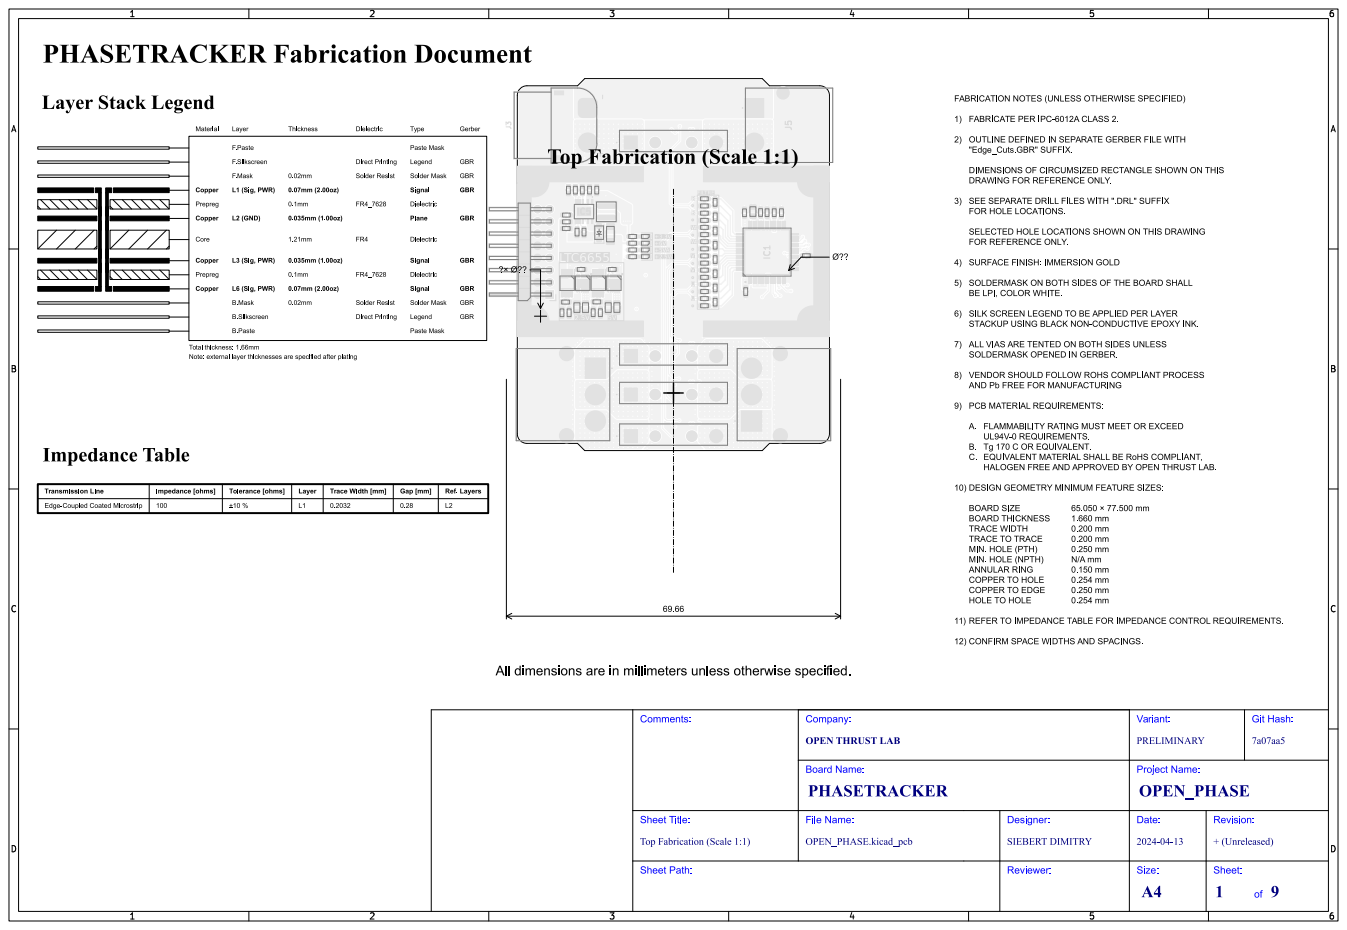
[picture p30: page 1]
Git Hash:; Comments:; Sheet Path:; Sheet Title:; File Name:; PHASETRACKER; OPEN_PHASE; Company:; PRELIMINARY; Variant:; Board Name:; OPEN_PHASE.kicad_pcb; SIEBERT DIMITRY; Designer:; Reviewer:; Project Name:; Date:; + (Unreleased); Revision:; Size:; Sheet:

OPEN THRUST LAB

Top Fabrication (Scale 1:1)

# Bottom Fabrication (Scale 1:1)

# PHASETRACKER Fabrication Document

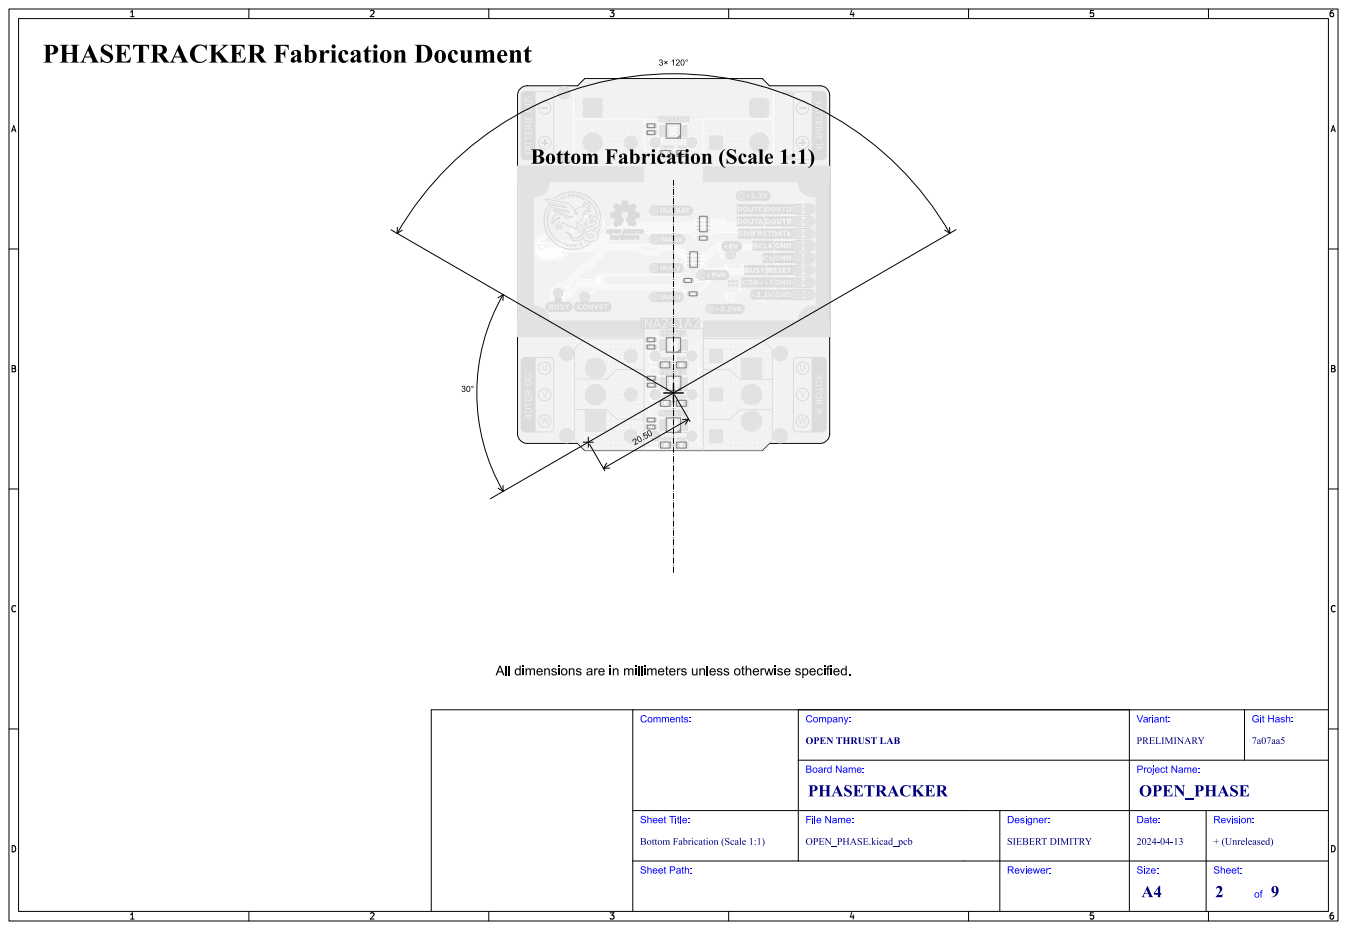
[picture p31: page 2]
Git; Hash:; Comments:; Sheet Path:; Sheet Title:; File Name:; PHASETRACKER; OPEN_PHASE; Company:; PRELIMINARY; Variant:; Board Name:; OPEN_PHASE.kicad_pcb; SIEBERT DIMITRY; Designer:; Reviewer:; Project Name:; Date:; + (Unreleased); Revision:; Size:; Sheet:

OPEN THRUST LAB

Bottom Fabrication (Scale 1:1)

# Drill Drawing L1 - L4 (Scale 1:1)

# PHASETRACKER Fabrication Document

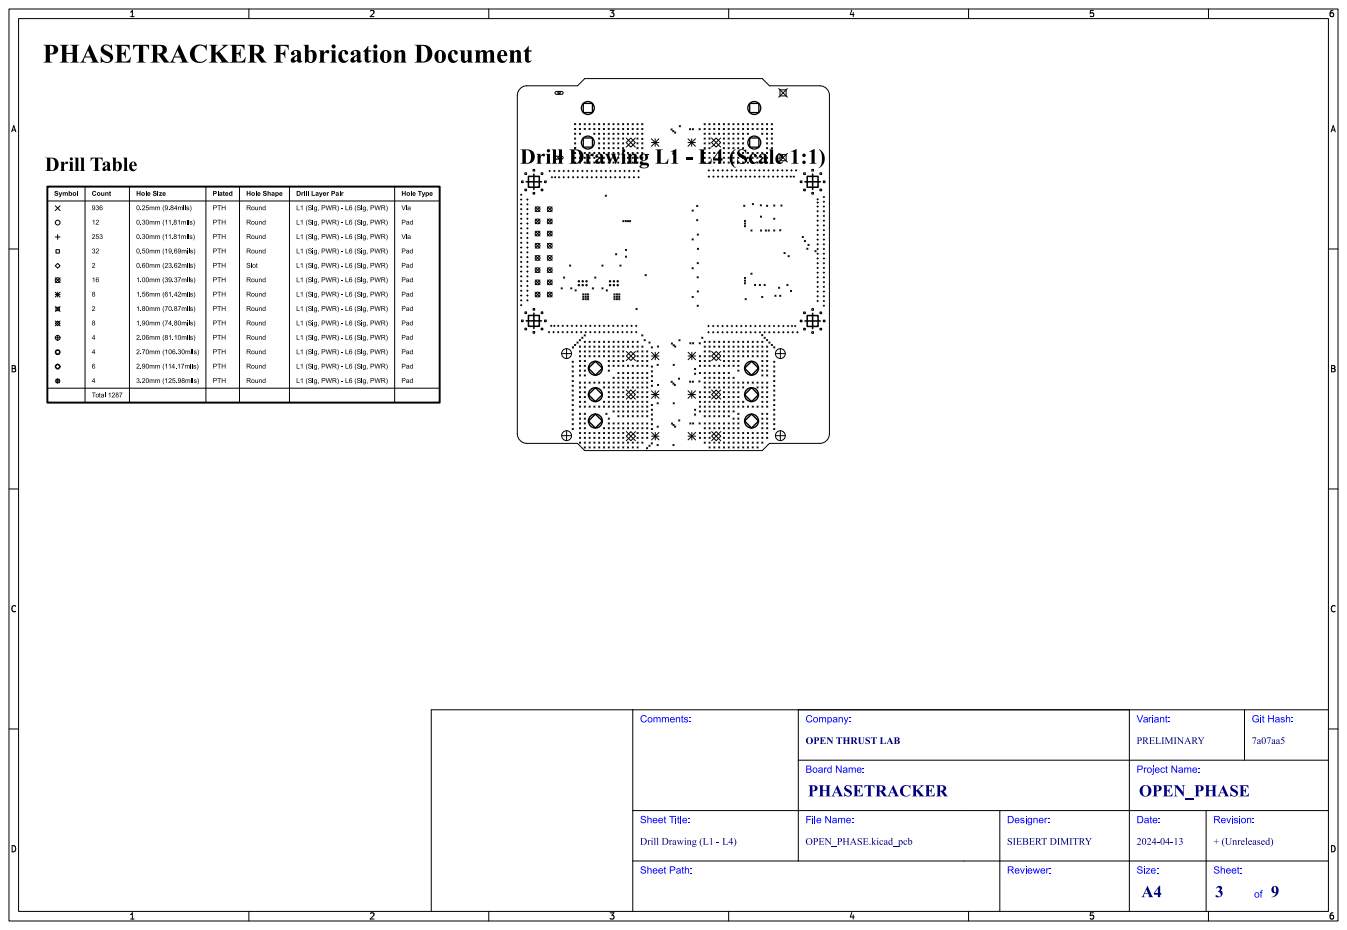
[picture p32: page 3]
Git; Hash:; Comments:; Drill Drawing (L1 - L4); Sheet Path:; Sheet Title:; File Name:; PHASETRACKER; OPEN_PHASE; Company:; PRELIMINARY; Variant:; Board Name:; OPEN_PHASE.kicad_pcb; SIEBERT DIMITRY; Designer:; Reviewer:; Project Name:; Date:; + (Unreleased); Revision:; Size:; Sheet:

OPEN THRUST LAB

# Top Test Points (Scale 1:1)

# PHASETRACKER Fabrication Document

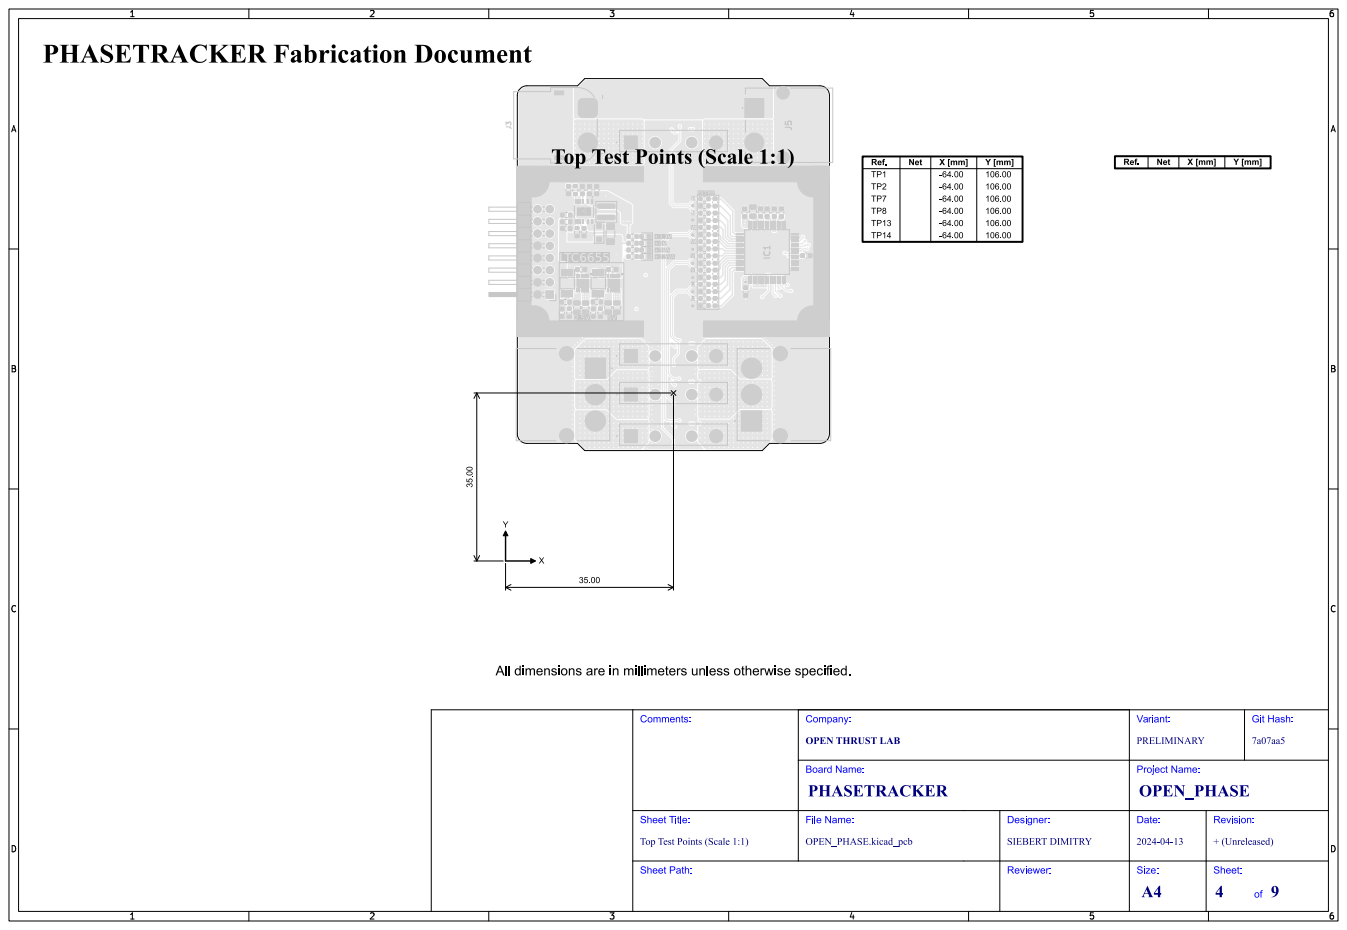
[picture p33: page 4]
Git; Hash:; Comments:; Sheet Path:; Sheet Title:; File Name:; PHASETRACKER; OPEN_PHASE; Company:; PRELIMINARY; Variant:; Board Name:; OPEN_PHASE.kicad_pcb; SIEBERT DIMITRY; Designer:; Reviewer:; Project Name:; Date:; + (Unreleased); Revision:; Size:; Sheet:

OPEN THRUST LAB

Top Test Points (Scale 1:1)

# Bottom Test Points (Scale 1:1)

# PHASETRACKER Fabrication Document

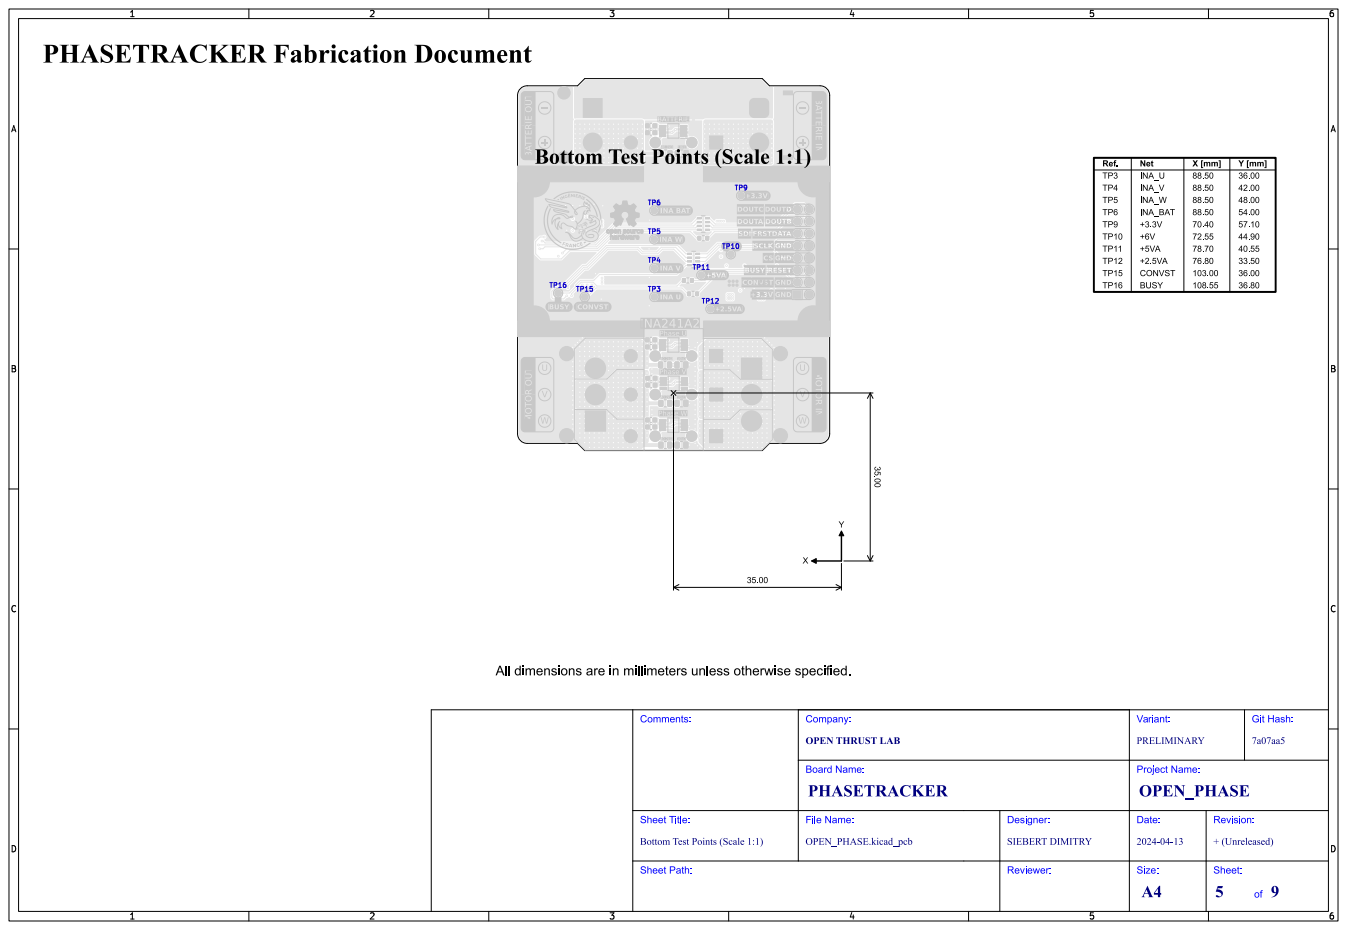
[picture p34: page 5]

Bottom Test Points (Scale 1:1)

# L1 (Sig, PWR) (Scale 1:1)

# PHASETRACKER Fabrication Document

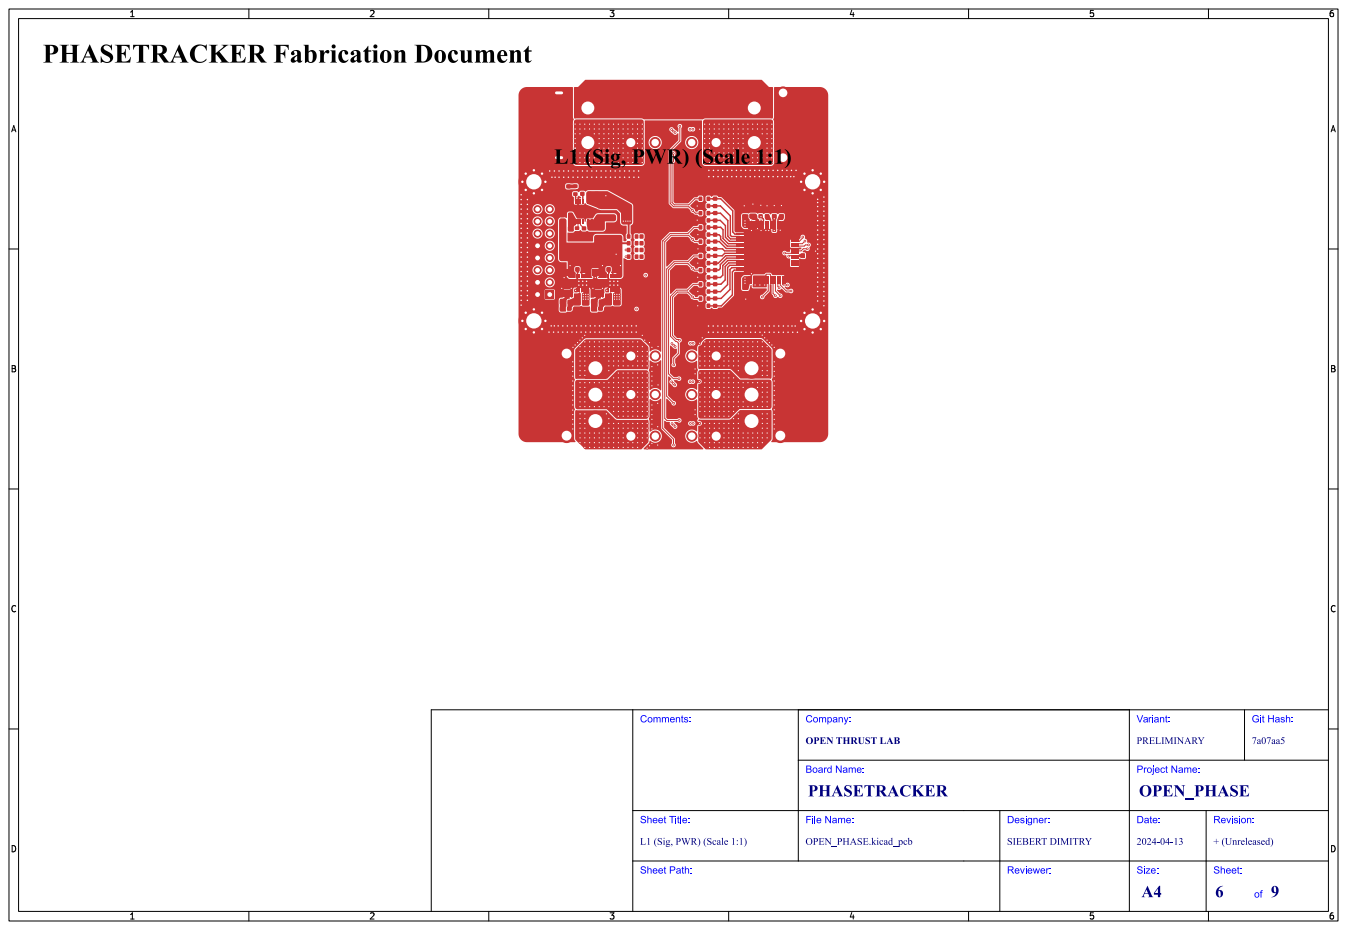
[picture p35: page 6]
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

OPEN THRUST LAB

L1 (Sig, PWR) (Scale 1:1)

# L2 (GND) (Scale 1:1)

# PHASETRACKER Fabrication Document

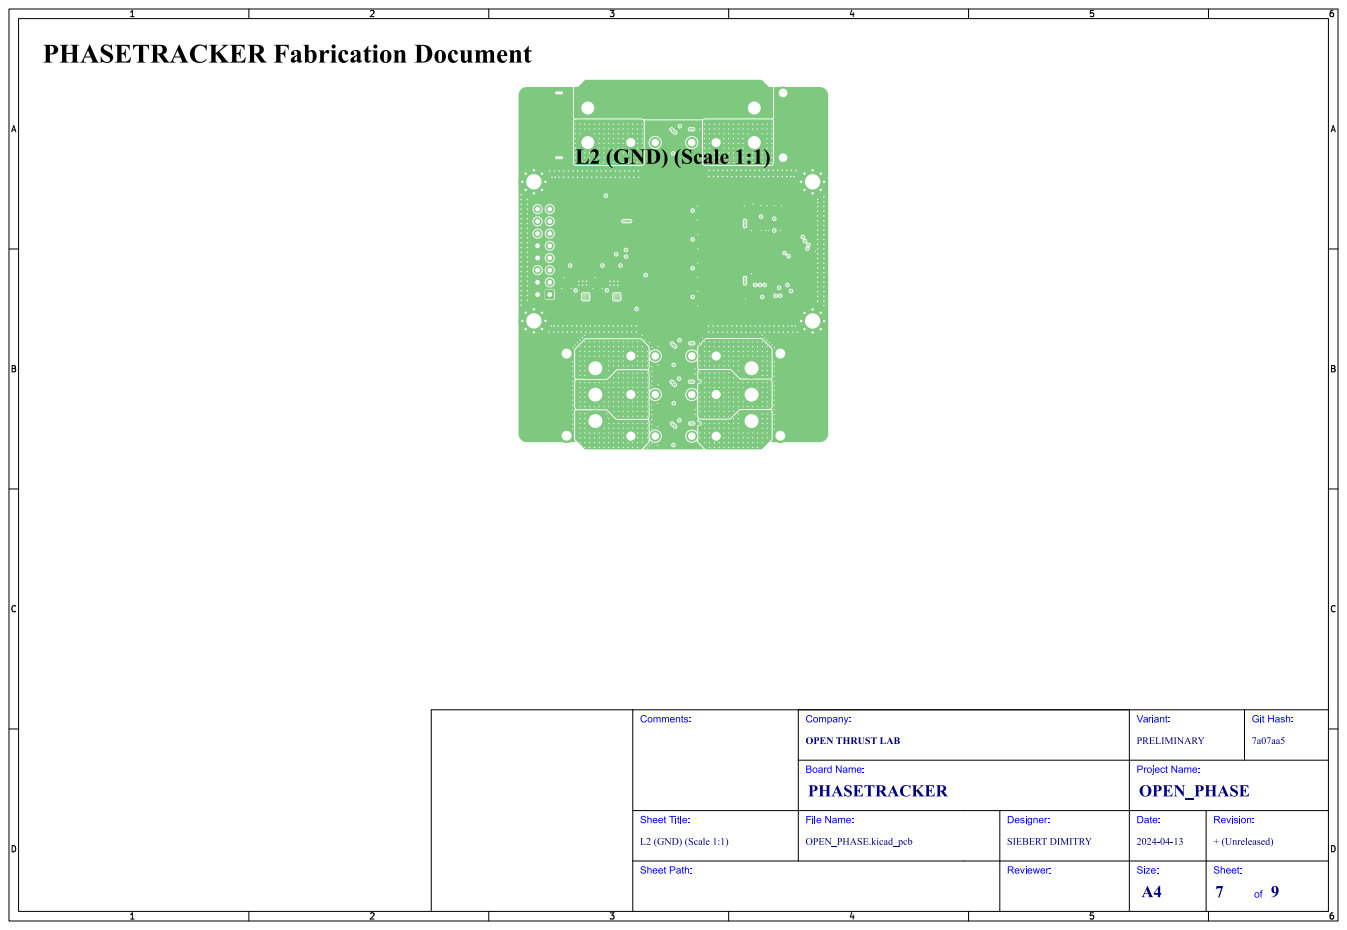
[picture p36: page 7]
Git; Hash:; Comments:; L2 (GND) (Scale 1:1); Sheet Path:; Sheet Title:; File Name:; PHASETRACKER; OPEN_PHASE; Company:; PRELIMINARY; Variant:; Board Name:; OPEN_PHASE.kicad_pcb; SIEBERT DIMITRY; Designer:; Reviewer:; Project Name:; Date:; + (Unreleased); Revision:; Size:; Sheet:

OPEN THRUST LAB

# L3 (Sig, PWR) (Scale 1:1)

# PHASETRACKER Fabrication Document

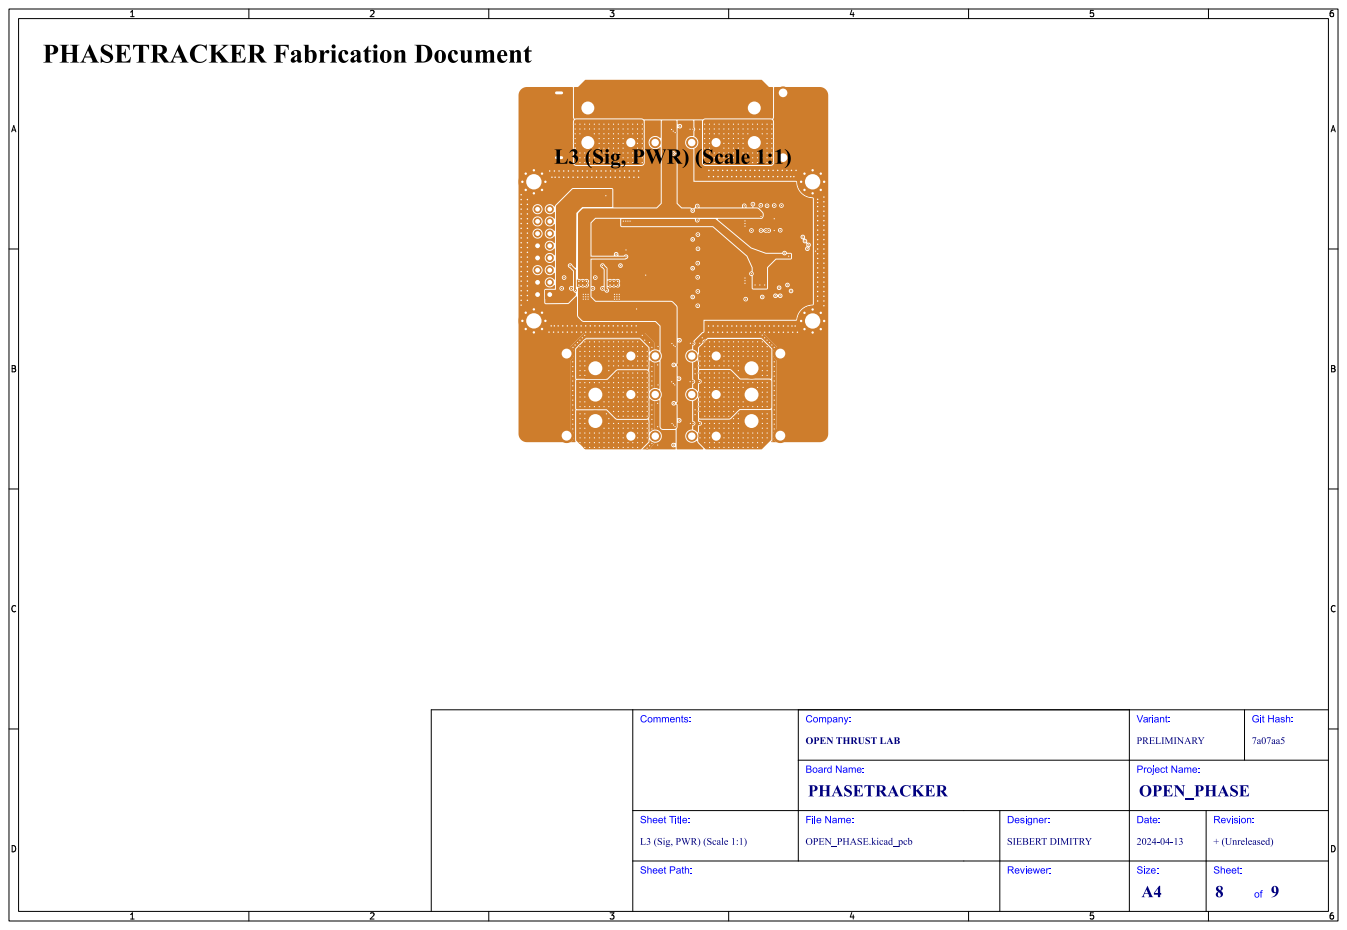
[picture p37: page 8]
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

OPEN THRUST LAB

L3 (Sig, PWR) (Scale 1:1)

# L6 (Sig, PWR) (Scale 1:1)

# PHASETRACKER Fabrication Document

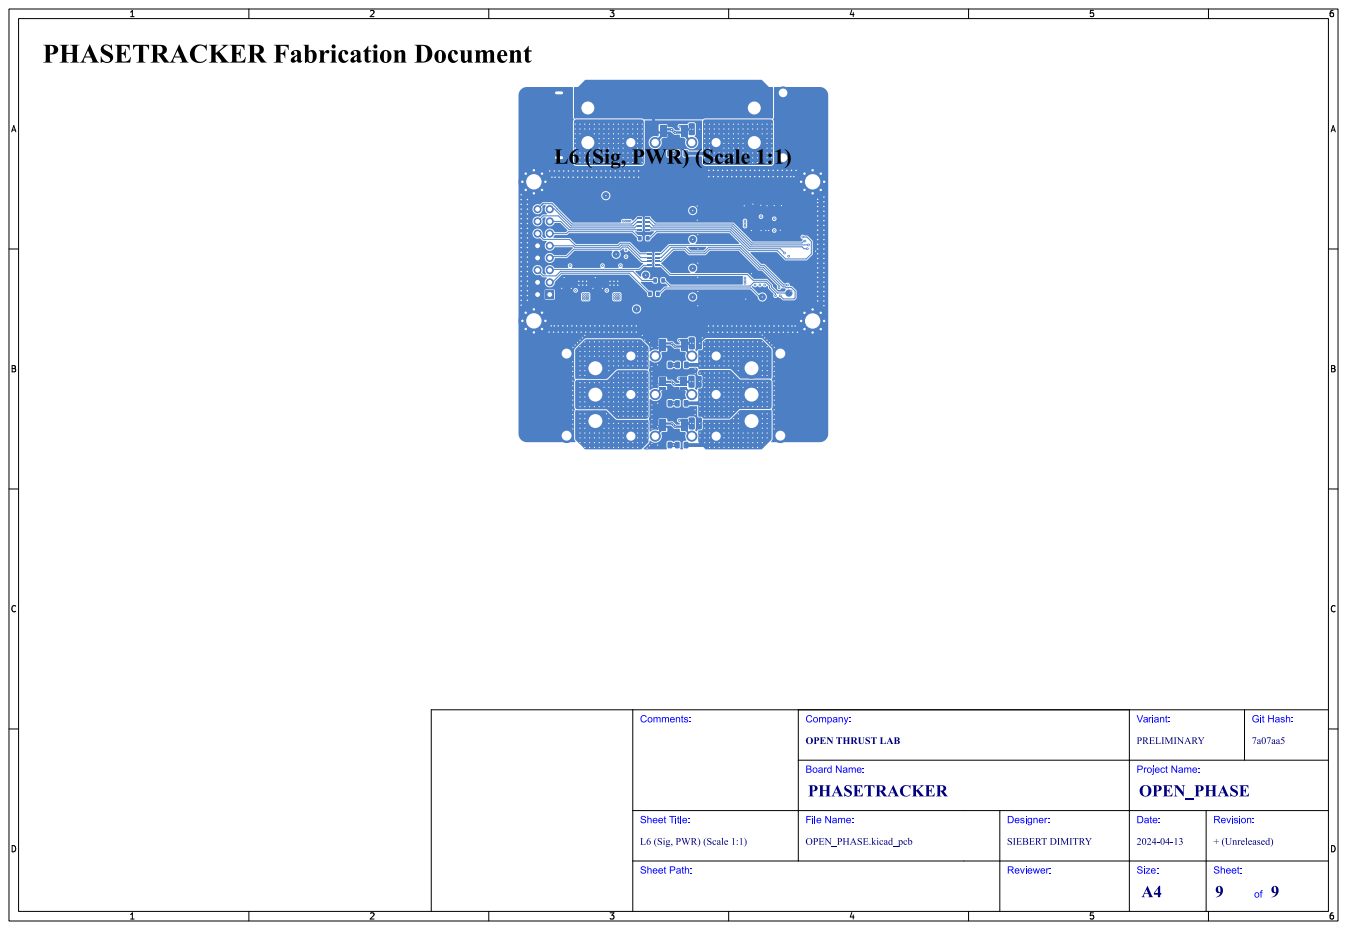
[picture p38: page 9]
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

OPEN THRUST LAB

L6 (Sig, PWR) (Scale 1:1)
