foukouda/OPEN_PHASE/HTML/images/cat_pdf_assembly_OPEN_PHASE-assembly.png

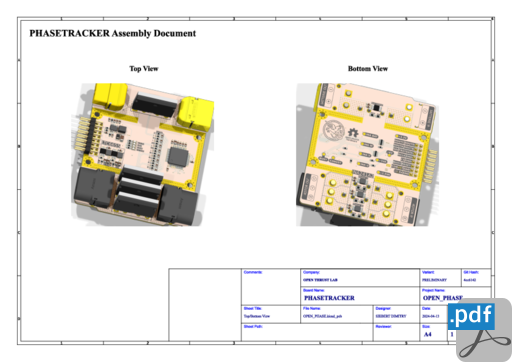
HTML/images/cat_pdf_assembly_OPEN_PHASE-assembly.png
