foukouda/OPEN_PHASE/HTML/images/cat_pdf_fabrication_OPEN_PHASE-fabrication.png

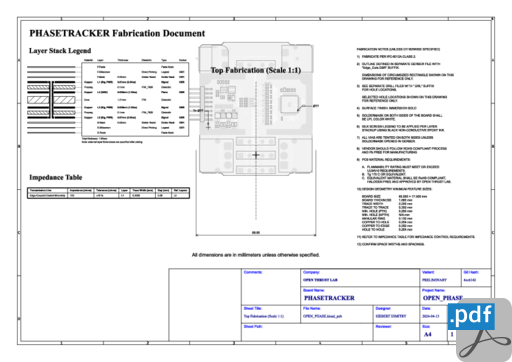
HTML/images/cat_pdf_fabrication_OPEN_PHASE-fabrication.png
