foukouda/OPEN_PHASE/Simulation/LTspice/measurement_quality.md

# Predicted measurement quality (generated by run_simulations.py)

Phase U and the DC bus (battery to ESC, channel B), from simulations 07 (ESC waveforms) and 08 (Monte Carlo on the tolerances),
completed with the datasheets for what is not simulated: the AD7606C-18 and the drift with temperature.

## How far a reading is from the truth

Error of one reading of a steady value, for three levels of calibration:

- **None**: the firmware uses the schematic values.
- **Zero**: the reading at 0 A is taken before the run and subtracted.
- **Zero and gain**: the gain has also been calibrated once against a known current and voltage. What is left is the drift 20 K away from that calibration, shunt self-heating included (datasheet maxima added together).

| True value | No calibration | Zero | Zero and gain |
| --- | --- | --- | --- |
| 5 A | reads 5.41 … 6.12 A | ±0.03 A (±0.5 %) | ±0.008 A (±0.16 %) |
| 10 A | reads 10.41 … 11.13 A | ±0.05 A (±0.5 %) | ±0.017 A (±0.17 %) |
| 20 A | reads 20.39 … 21.13 A | ±0.10 A (±0.5 %) | ±0.041 A (±0.21 %) |
| 35 A | reads 35.35 … 36.16 A | ±0.18 A (±0.5 %) | ±0.105 A (±0.30 %) |
| 12 V | reads 11.76 … 12.07 V | as without calibration | ±0.040 V (±0.33 %) |
| 25.2 V | reads 24.71 … 25.33 V | as without calibration | ±0.083 V (±0.33 %) |
| 50 V | reads 49.05 … 50.27 V | as without calibration | ±0.165 V (±0.33 %) |

The first two columns hold for 95 % of the boards. On top of these figures: 10 mA rms and 0.85 mV rms of noise on one sample (it averages out), and ±58 mA on the current if the zero is not taken again after a 20 K change.

## What the test shows

- **Calibrate the zero of the current.** With the schematic constants the reading at 0 A is +0.75 A. Multiplied by the mean phase voltage (12.6 V) it adds 9.5 W to a phase that carries 90 W.
- **The gain of the current is the shunt.** Its ±0.5 % tolerance is the whole spread before a gain calibration.
- **The power under PWM depends on the inductance of the shunt.** The datasheet only says "below 10 nH". After DC calibration the power reads -4.2 % without inductance and +4.7 % with 10 nH: the phase between the two channels has to be measured on a real board.
- **Sample fast.** Below 200 kSPS the PWM aliases into the power (up to 17 % at the worst sampling phase over 4 ms).
- **The DC bus is the accurate side.** After DC calibration the power from the battery reads within 0.18 %, whatever the inductance of the shunt and from 10 kSPS: both readings are almost steady, so the delay between the two channels does not matter.
- **The ESC efficiency is not readable yet.** For a true 98.9 %, the board reads 94.7 % to 103.6 % depending on the inductance of the phase shunts: the error on the phase power is larger than the losses of an ESC.

## Shunt R1 / R4 / R7 / R9: PBV-R001-F1-0.5 (datasheet)

| Datasheet figure | Value | Effect on the current reading |
| --- | --- | --- |
| Tolerance | ±0.5 % | ±0.5 % of gain, removed by a gain calibration |
| Temperature coefficient | < 75 ppm/K | ±0.15 % for 20 K |
| Thermal resistance to ambient | < 15 K/W | at 35 A: 1.23 W of the 3 W allowed, +18 K, up to 0.14 % |
| Inductance | < 10 nH | changes the PWM ripple and the delay of the reading, see below |
| Thermal EMF | < 2 µV/K | 2 mA of offset per kelvin of difference between the two sense terminals |
| Stability | < 0.5 % after 2000 h | slow drift of the gain at nominal load |

The other resistors have no part number in the schematic: 1 % and 100 ppm/K are assumed for them.

## Test waveform (simulation 07)

- Battery 25.2 V, PWM 24 kHz, electrical frequency 1 kHz.
- Motor phase: 30 µH, 50 mΩ, back-EMF 8 V peak.
- Phase current 19.9 A peak at 1 kHz, 14.22 A rms with the PWM ripple (1.85 A rms of ripple).
- True power in the phase: 89.87 W.

## Dynamic accuracy (simulation 07, shunt without inductance)

| Quantity | Truth | Reading, schematic constants | Reading, after DC calibration |
| --- | --- | --- | --- |
| Mean current | 0.000 A | 0.754 A | 0.000 A |
| RMS current | 14.220 A | 14.105 A (-0.81 %) | 14.085 A (-0.95 %) |
| Mean phase voltage | 12.600 V | 12.505 V (-0.75 %) | 12.600 V (-0.00 %) |
| RMS phase voltage | 17.798 V | 15.219 V (-14.49 %) | 15.333 V (-13.85 %) |

The RMS of the phase voltage is low because the filters round the PWM edges: use the mean or the fundamental, not the RMS.

| Phase power | Value | Error |
| --- | --- | --- |
| Truth | 89.87 W | |
| Reading, schematic constants | 94.88 W | +5.57 % |
| Reading, after DC calibration | 86.10 W | -4.20 % |
| Reading, DC calibration + time shift of the current | 91.02 W | +1.28 % |
| Reading, DC calibration + matched channel filters | 89.20 W | -0.75 % |

"Matched channel filters" means that the current reading is also filtered at the corner of the voltage channel and the
voltage reading at the corner of the current channel, in the firmware or with the same RC on both channels.

## Effect of the shunt inductance (simulation 07)

The inductance adds a voltage proportional to the slope of the current. It acts against the RC filter of the current channel.

| Shunt inductance | Delay of the current reading | Delay of the voltage reading | PWM ripple left | RMS current | Power after DC calibration | Power with a time shift of the current |
| --- | --- | --- | --- | --- | --- | --- |
| 0 nH | 15.5 µs | 9.6 µs | 41 % | -0.95 % | -4.20 % | +1.28 % |
| 5 nH | 10.6 µs | 9.6 µs | 51 % | -0.82 % | +0.27 % | +1.29 % |
| 10 nH | 5.6 µs | 9.6 µs | 75 % | -0.42 % | +4.73 % | -1.44 % |

Delays are measured at the electrical frequency and include the AD7606C input filter.

## Sampling rate (simulation 07)

Both channels sampled together, after DC calibration, over 4 electrical periods and for 300 phases of the
sampling clock against the PWM. Power error: median / worst phase.

| Sampling rate | As built, shunt without inductance | As built, shunt with 10 nH | Same filtering on both channels |
| --- | --- | --- | --- |
| 10 kSPS | 8.10 % / 17.50 % | 8.42 % / 21.83 % | 2.79 % / 4.84 % |
| 20 kSPS | 4.26 % / 6.46 % | 4.71 % / 7.58 % | 0.75 % / 1.15 % |
| 50 kSPS | 8.50 % / 15.67 % | 8.80 % / 20.86 % | 2.66 % / 4.53 % |
| 100 kSPS | 4.31 % / 5.53 % | 4.52 % / 6.96 % | 0.77 % / 0.98 % |
| 200 kSPS | 4.21 % / 4.34 % | 4.71 % / 4.96 % | 0.75 % / 0.76 % |
| 500 kSPS | 4.20 % / 4.21 % | 4.73 % / 4.74 % | 0.75 % / 0.75 % |
| 1000 kSPS | 4.19 % / 4.20 % | 4.73 % / 4.73 % | 0.75 % / 0.75 % |

## DC bus, battery to ESC (simulation 07)

The DC bus channel (shunt R9, IC10, divider R32 / R33) has the same parts and values as the phase channels. The static
accuracy, the noise and the drift given in this report apply to it, and it is read here with the same DC calibration.
It is read on the ADC inputs V2 (current) and V1 (voltage); phase U is on V8 (current) and V7 (voltage).

- Load: the three phases together, 270 W to the motor.
- Battery and leads: 20 mΩ, 300 nH. ESC input capacitor: 470 µF, 30 mΩ. These four values are assumed, no battery or ESC is specified in the project. They set the ripple, not the mean values.

| Quantity | Truth | Reading, schematic constants | Reading, after DC calibration |
| --- | --- | --- | --- |
| Mean battery current | 10.923 A | 11.676 A (+6.89 %) | 10.922 A (-0.00 %) |
| Current ripple | 13.5 A pp | 4.2 A pp | 4.2 A pp |
| Mean bus voltage | 24.971 V | 24.784 V (-0.75 %) | 24.971 V (-0.00 %) |
| Voltage ripple | 0.98 V pp | 0.40 V pp | 0.40 V pp |
| Power from the battery | 272.54 W | 289.37 W (+6.18 %) | 272.75 W (+0.08 %) |

The filters keep 33 % of the current ripple and 36 % of the voltage ripple: the ripple of the DC bus cannot be read, its mean values can.
Sampling rate: the power from the battery stays within 0.18 % from 10 kSPS to 1000 kSPS, at the worst sampling phase.

### ESC efficiency read by the board

Power to the motor (three phases, each read like phase U) divided by the power from the battery. The truth is what perfect
sensors would read at the same points: the phase voltage is taken on the motor side of the shunts, and in this model the ESC
only loses what its input capacitor dissipates.

| Shunt inductance | Truth | Schematic constants | After DC calibration | DC calibration + matched channel filters |
| --- | --- | --- | --- | --- |
| 0 nH | 98.92 % | 98.36 % | 94.70 % | 98.11 % |
| 5 nH | 98.93 % | 102.52 % | 99.15 % | 101.15 % |
| 10 nH | 98.92 % | 106.68 % | 103.59 % | 104.20 % |

The error on the efficiency is the error on the phase power: over the three runs the power from the battery reads +0.01 % to +0.08 %, the power to the motor -4.20 % to +4.73 %.

## Noise and resolution of one sample

Computed from the datasheets with the simulated gains and bandwidths (current channel 17.5 kHz, voltage channel 48.5 kHz, then 25 kHz in the ADC).

| Quantity | Current channel | Voltage channel |
| --- | --- | --- |
| 1 LSB (18 bits, ±10 V) | 3.8 mA | 0.39 mV |
| ADC noise (SNR 92.5 dB) | 8.4 mA rms | 0.85 mV rms |
| INA241A2 noise (49 nV/√Hz) | 6.2 mA rms | |
| Total | 10.4 mA rms | 0.85 mV rms |

## Static accuracy before calibration (simulation 08, 1000 boards)

Readings computed with the schematic constants. Each cell gives the mean and the interval that holds 95 % of the boards.

| Quantity | Analog chain (simulated) | With the ADC and its reference (datasheet) |
| --- | --- | --- |
| Current reading at 0 A | +0.79 A (+0.56 … +1.01) | +0.76 A (+0.39 … +1.12) |
| Current gain error | -0.01 % (-0.48 … +0.47) | +0.01 % (-0.50 … +0.53) |
| Voltage reading at 0 V | -0.7 mV (-20.4 … +19.6) | -0.4 mV (-38.2 … +36.7) |
| Voltage gain error | -0.73 % (-1.93 … +0.51) | -0.71 % (-1.91 … +0.55) |

+2.5VA over the 1000 boards: 2.4995 V on average, 2.4949 … 2.5046 V. The AD7606C accepts 2.495 … 2.505 V on REFIN: 0.1 % of the boards are outside.

## Drift after calibration (datasheet maxima, 20 K)

| Contribution | Current | Voltage |
| --- | --- | --- |
| Gain | ±0.16 % (shunt 75, INA241A2 1, ADC 3, reference 2 ppm/K) | ±0.33 % (divider with two 100 ppm/K resistors, assumed) |
| Zero | ±58 mA (mostly the ADC zero drift) | ±5 mV |
| Shunt self-heating | up to 0.14 % at 35 A | |

## Not covered by these simulations

- INA241A2 common-mode rejection and its 1 µs output hold at each PWM edge (behavioural model).
- Layout: Kelvin routing of the shunt, coupling of the PWM edges into the sense traces.
- The other two phases and the real motor: the waveform is a single-phase equivalent.
- The real battery and ESC: the DC bus values are assumed, the half-bridges have no loss and their PWM uses the nominal
  battery voltage, not the sagging bus voltage.
