foukouda/OPEN_PHASE/Simulation/LTspice/results.md

# LTspice .meas results (generated by run_simulations.py)

## 01_Power_Chain_Startup

| Measure | Result |
| --- | --- |
| `v6_at_12ms` | `AVG(V(+6V) )=5.96119125505 FROM 0.011 TO 0.012` |
| `v6_max` | `MAX(V(+6V))=6.03859186172 FROM 0 TO 0.012` |
| `t6_90` | `V(+6V)=5.37  AT 0.000881067941285` |
| `il_peak` | `MAX(I(L1))=3.02932238579 FROM 0 TO 0.012` |
| `i3v3_inrush` | `MIN(I(V1))=-3.20160198212 FROM 0 TO 0.012` |

## 02_Analog_Rails_Startup

| Measure | Result |
| --- | --- |
| `v5va` | `AVG(V(+5VA) )=4.99978402682 FROM 0.14 TO 0.15` |
| `v2v5a` | `AVG(V(+2.5VA) )=2.49956984324 FROM 0.14 TO 0.15` |
| `vref5` | `AVG(V(REF5) )=4.99998890639 FROM 0.14 TO 0.15` |
| `vref2v5` | `AVG(V(REF2V5) )=2.49995944731 FROM 0.14 TO 0.15` |
| `i_r8` | `AVG(I(R8) )=2.03758654534e-07 FROM 0.14 TO 0.15` |
| `i_r11` | `AVG(I(R11) )=3.89577983174e-07 FROM 0.14 TO 0.15` |
| `t5_99` | `V(+5VA)=4.95  AT 0.0475632153588` |
| `t5_999` | `V(+5VA)=4.995  AT 0.0714008941037` |
| `i_6v` | `AVG(I(V_6V) )=-0.0678833865613 FROM 0.14 TO 0.15` |

## 03_Boost_Ripple

| Measure | Result |
| --- | --- |
| `v6_avg` | `AVG(V(+6V) )=5.96122219117 FROM 0.005 TO 0.006` |
| `v6_pp` | `PP(V(+6V) )=0.000818252563477 FROM 0.005 TO 0.006` |
| `i3v3` | `AVG(I(V1) )=-0.133471265119 FROM 0.005 TO 0.006` |
| `il_pk` | `MAX(I(L1) )=0.299900591373 FROM 0.005 TO 0.006` |
| `v3v3_pp` | `PP(V(+3.3V) )=0.00306463241577 FROM 0.005 TO 0.006` |

## 04_Analog_Rails_PSRR

| Measure | Result |
| --- | --- |
| `psrr5_1k` | `mag(V(+5VA)) =(-84.7815220235dB,0°) at 1000` |
| `psrr5_100k` | `mag(V(+5VA)) =(-86.8584645353dB,0°) at 100000` |
| `psrr5_2m` | `mag(V(+5VA)) =(-77.4564523271dB,0°) at 2000000` |
| `psrr2v5_1k` | `mag(V(+2.5VA)) =(-84.7891877295dB,0°) at 1000` |
| `psrr2v5_100k` | `mag(V(+2.5VA)) =(-89.1733840782dB,0°) at 100000` |
| `psrr2v5_2m` | `mag(V(+2.5VA)) =(-93.550534226dB,0°) at 2000000` |

## 05_Measurement_Channels_AC

| Measure | Step 1 | Step 2 |
| --- | --- | --- |
| `g_i` | `(-127.979420118dB,0°)` | `(-33.9796454177dB,0°)` |
| `f3db_i` | `17943.6190952` | `17466.3747043` |
| `g_i_24k` | `(-132.393807082dB,0°)` | `(-38.5862674326dB,0°)` |
| `g_i_2m` | `(-173.169239659dB,0°)` | `(-80.2819544812dB,0°)` |
| `g_v` | `(-14.0790330426dB,0°)` | `(-74.0790330426dB,0°)` |
| `f3db_v` | `48523.5590652` | `48523.5590652` |
| `g_v_24k` | `(-15.0294623412dB,0°)` | `(-75.0294623412dB,0°)` |
| `g_v_2m` | `(-46.3720706972dB,0°)` | `(-106.372070697dB,0°)` |

## 06_Measurement_Channels_Step

| Measure | Result |
| --- | --- |
| `vi_zero` | `AVG(V(V8+,V8-) )=2.48493246082 FROM 5e-05 TO 9e-05` |
| `vi_35a` | `AVG(V(V8+,V8-) )=1.78494206909 FROM 0.00055 TO 0.0006` |
| `v8n_bias` | `AVG(V(V8-) )=0.0150525188074 FROM 0.00055 TO 0.0006` |
| `t_i_1pct` | `V(V8+,V8-)=VI_zero+0.99*(VI_35A-VI_zero)  AT 0.000342103919134` |
| `vv_zero` | `AVG(V(V7+,V7-) )=-0.000151105225086 FROM 5e-05 TO 9e-05` |
| `vv_25v` | `AVG(V(V7+,V7-) )=4.98236731533 FROM 0.00025 TO 0.00029` |
| `voutu` | `AVG(V(OUT-U) )=25.1999988556 FROM 0.00025 TO 0.00029` |
| `t_v_1pct` | `V(V7+,V7-)=VV_zero+0.99*(VV_25V-VV_zero)  AT 0.00011515464009` |
