foukouda/OPEN_PHASE/CHANGELOG.md

# Changelog

All notable changes to this board are documented here.
Format: [Keep a Changelog](https://keepachangelog.com/en/1.1.0/), versions follow [Semantic Versioning](https://semver.org/) (tag `X.Y.Z`, no `v` prefix).
Keep entries short: the `[Unreleased]` section is printed on the schematic Revision History page.

## [Unreleased]

### Added

-   4x PBV 1 mOhm shunt + INA241A2 (20 V/V)
-   4x voltage divider 40.2k / 10k
-   AD7606C-18 ADC, 8 inputs used
-   +3.3V -> LT8362 6 V -> LT3045-1 +5VA / +2.5VA
-   Self-contained libs and 3D models (lib/)
-   LTspice simulations (Simulation/LTspice)
-   Predicted measurement quality (sim 07, 08)
-   openEMS shunt inductance model (Simulation/openEMS)
-   Thermal / current density model (Simulation/Thermal)
-   3D animation (Images/OPEN_PHASE.mp4)
-   J4 host header 2x8: AD7606C serial, software mode
-   Test points TP1-TP16
-   4x rail indicator LED (D1, D3-D5), about 1 mA each
-   Silkscreen: rail names at the LEDs, test point tags, OSHW logo
-   100 Ohm in series on the 11 J4 lines: RN1, RN2 (4x0603 array, as OPEN_WEIGHT), R39-R41, bottom side
-   100k pull-up on CS (R42), pull-downs on CONVST (R43) and RESET (R44)

### Changed

-   Renamed to OPEN_PHASE, KiCad 10
-   Sheets named after their function
-   IC3: LTC6655LN-2.5 -> LTC6655-2.5 (pin 6 = VOUT_S)
-   R12: 49.9k -> 24.9k (+2.5VA = 2.500 V)
-   L1: 744373965022 -> WE-MAPI 4030 74438357022 (4.1 x 4.1 mm)
-   Solder mask white, silkscreen black
-   Nets renamed SHUNT_*, INA_*, ADC_*
-   IC1 AGND pin 26, REFGND pin 46 to GND
-   IC8, IC9: thermal vias on exposed pad 13
-   Licence: MIT -> CERN-OHL-P v2
-   README / HTML logo: INGENIERIE FRANCE badge
-   TP15 / TP16 on the AD7606C side of the series resistors

### Fixed

-   +5VA via of R36 sat on the ADC_~{CS} track (short): bus rerouted around it
