foukouda/OPEN_PHASE/Schematic/OPEN_PHASE-schematic-1.pdf

# PHASETRACKER

# Variant:

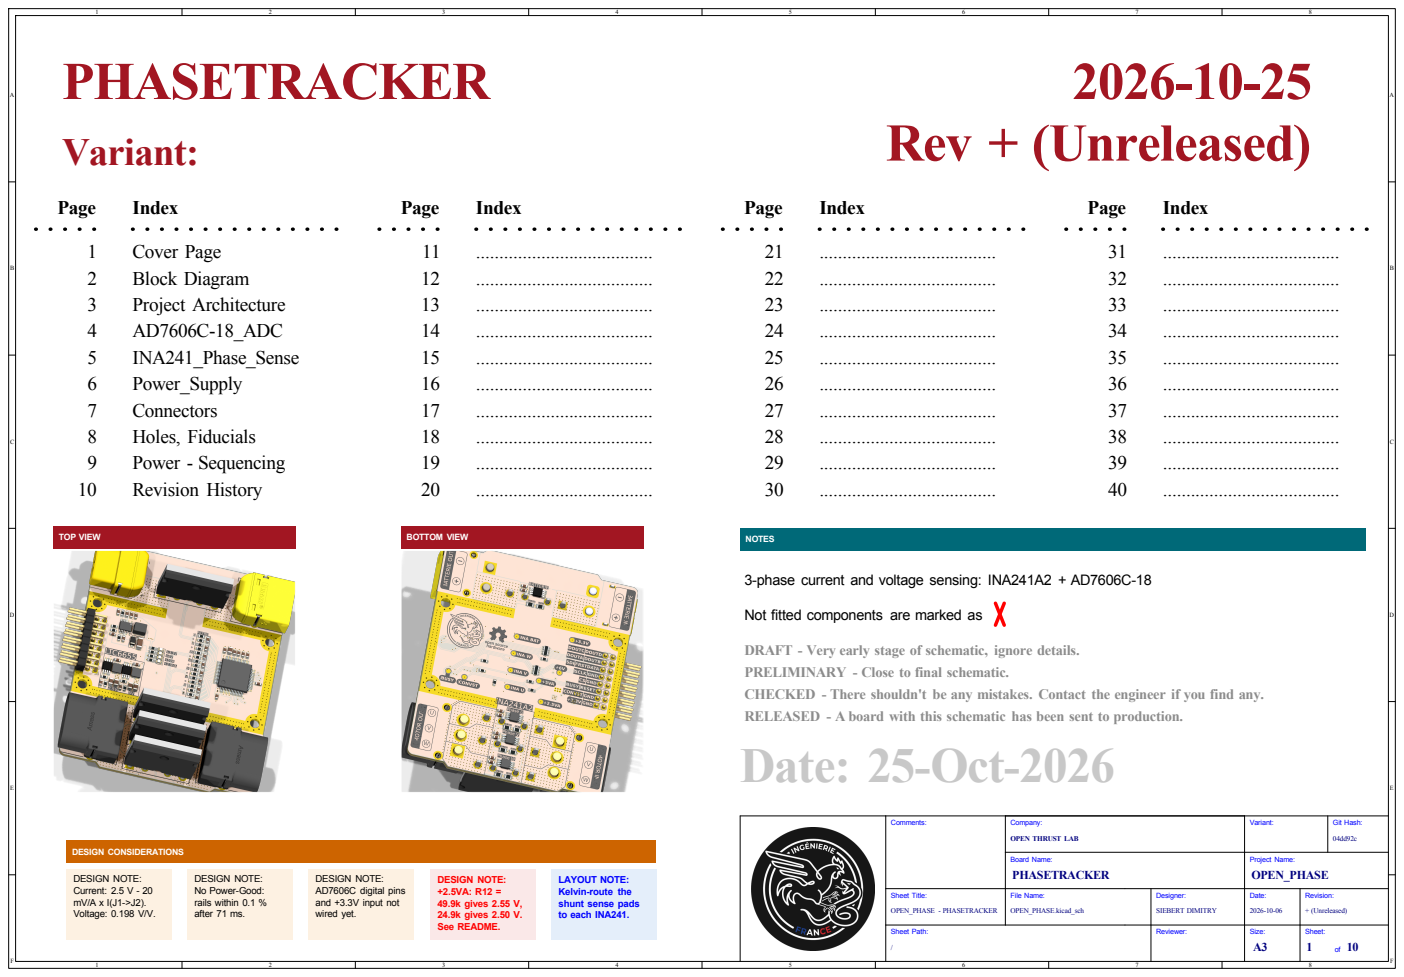
[picture p41: page 1]
Sheet: of 10; Size: A3; OPEN_PHASE.kicad_sch; SIEBERT DIMITRY; Board Name: Company:; Variant: OPEN THRUST LAB PHASETRACKER; OPEN_PHASE; Sheet Title:; File Name:; /Sheet Path: OPEN_PHASE - PHASETRACKER Comments:; Git Hash: 04dd92c Project Architecture; DESIGN NOTE: Current: 2.5 V - 20 mV/A x I(J1->J2). Voltage: 0.198 V/V.; TOP VIEW; NOTES; DESIGN CONSIDERATIONS; kibot_image_png_3d_viewer_angled_top; kibot_image_png_3d_viewer_angled_bottom; DESIGN NOTE: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

3-phase current and voltage sensing: INA241A2 + AD7606C-18

Not fitted components are marked as

PRELIMINARY - Close to final schematic.
CHECKED - There shouldn't be any mistakes. Contact the engineer if you find any.
RELEASED - A board with this schematic has been sent to production.

Revision: + (Unreleased) Date: Project Name: 2026-10-06 Reviewer: Designer:

DESIGN NOTE:
No Power-Good:
rails within 0.1 %
after 71 ms.

AD7606C digital pins
and +3.3V input not
wired yet.

LAYOUT NOTE:
Kelvin-route the
shunt sense pads
to each INA241.
