foukouda/OPEN_PHASE/Schematic/OPEN_PHASE-schematic-2.pdf

# [2] Block Diagram

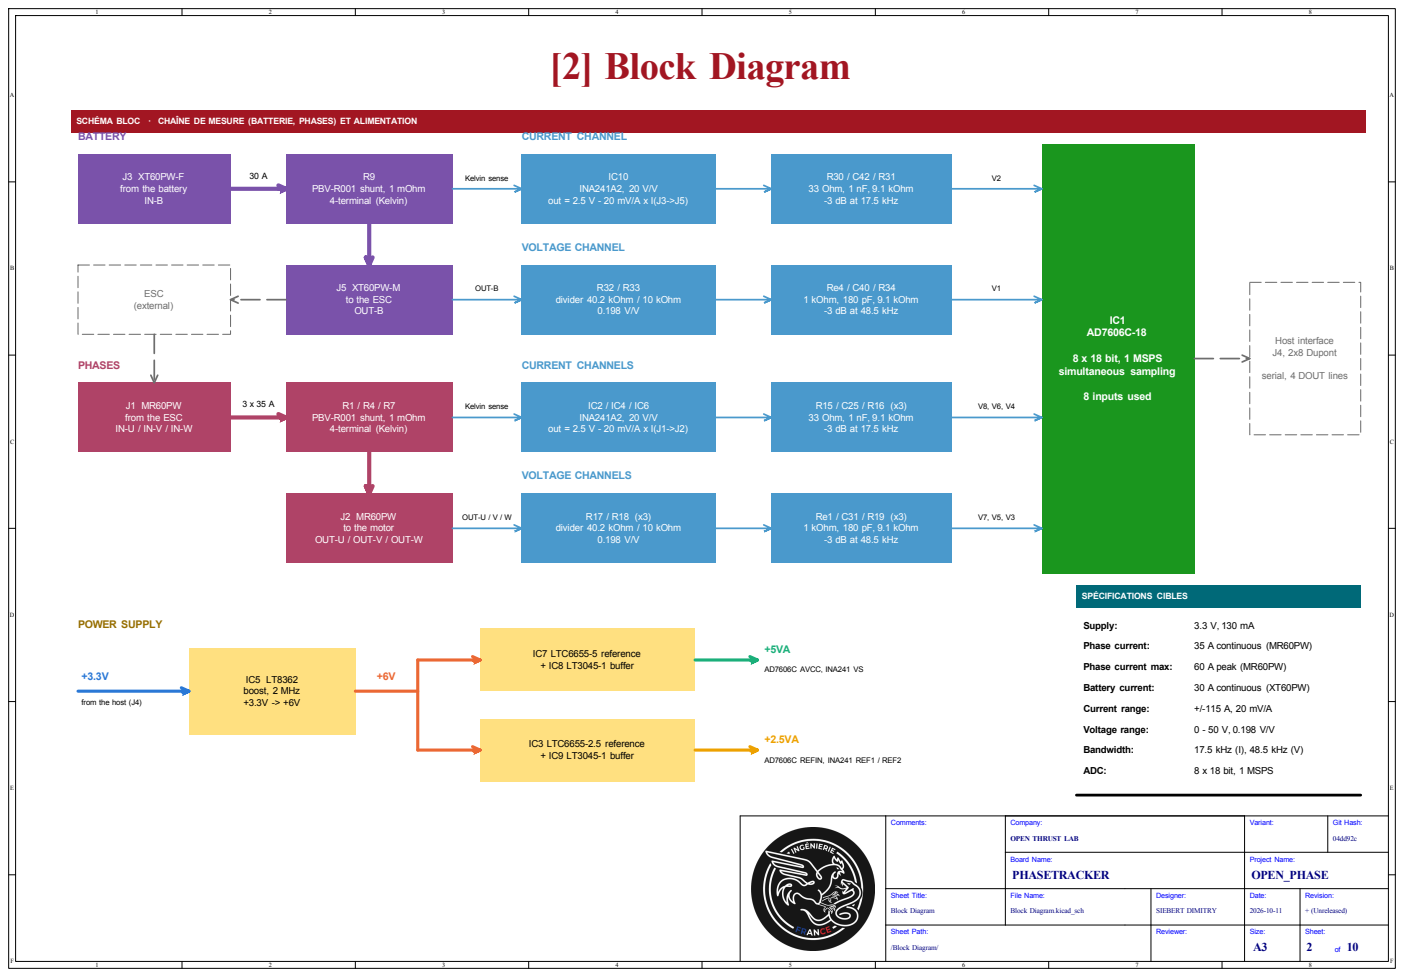
[picture p42: page 1]

SCHÉMA BLOC · CHAÎNE DE MESURE (BATTERIE, PHASES) ET ALIMENTATION
BATTERY

Supply:
Phase current:
Phase current max: Voltage range:
Battery current:
Current range:

/Block Diagram/ Sheet Path: Block Diagram
