foukouda/OPEN_PHASE/Schematic/OPEN_PHASE-schematic-3.pdf

# [3] Project Architecture

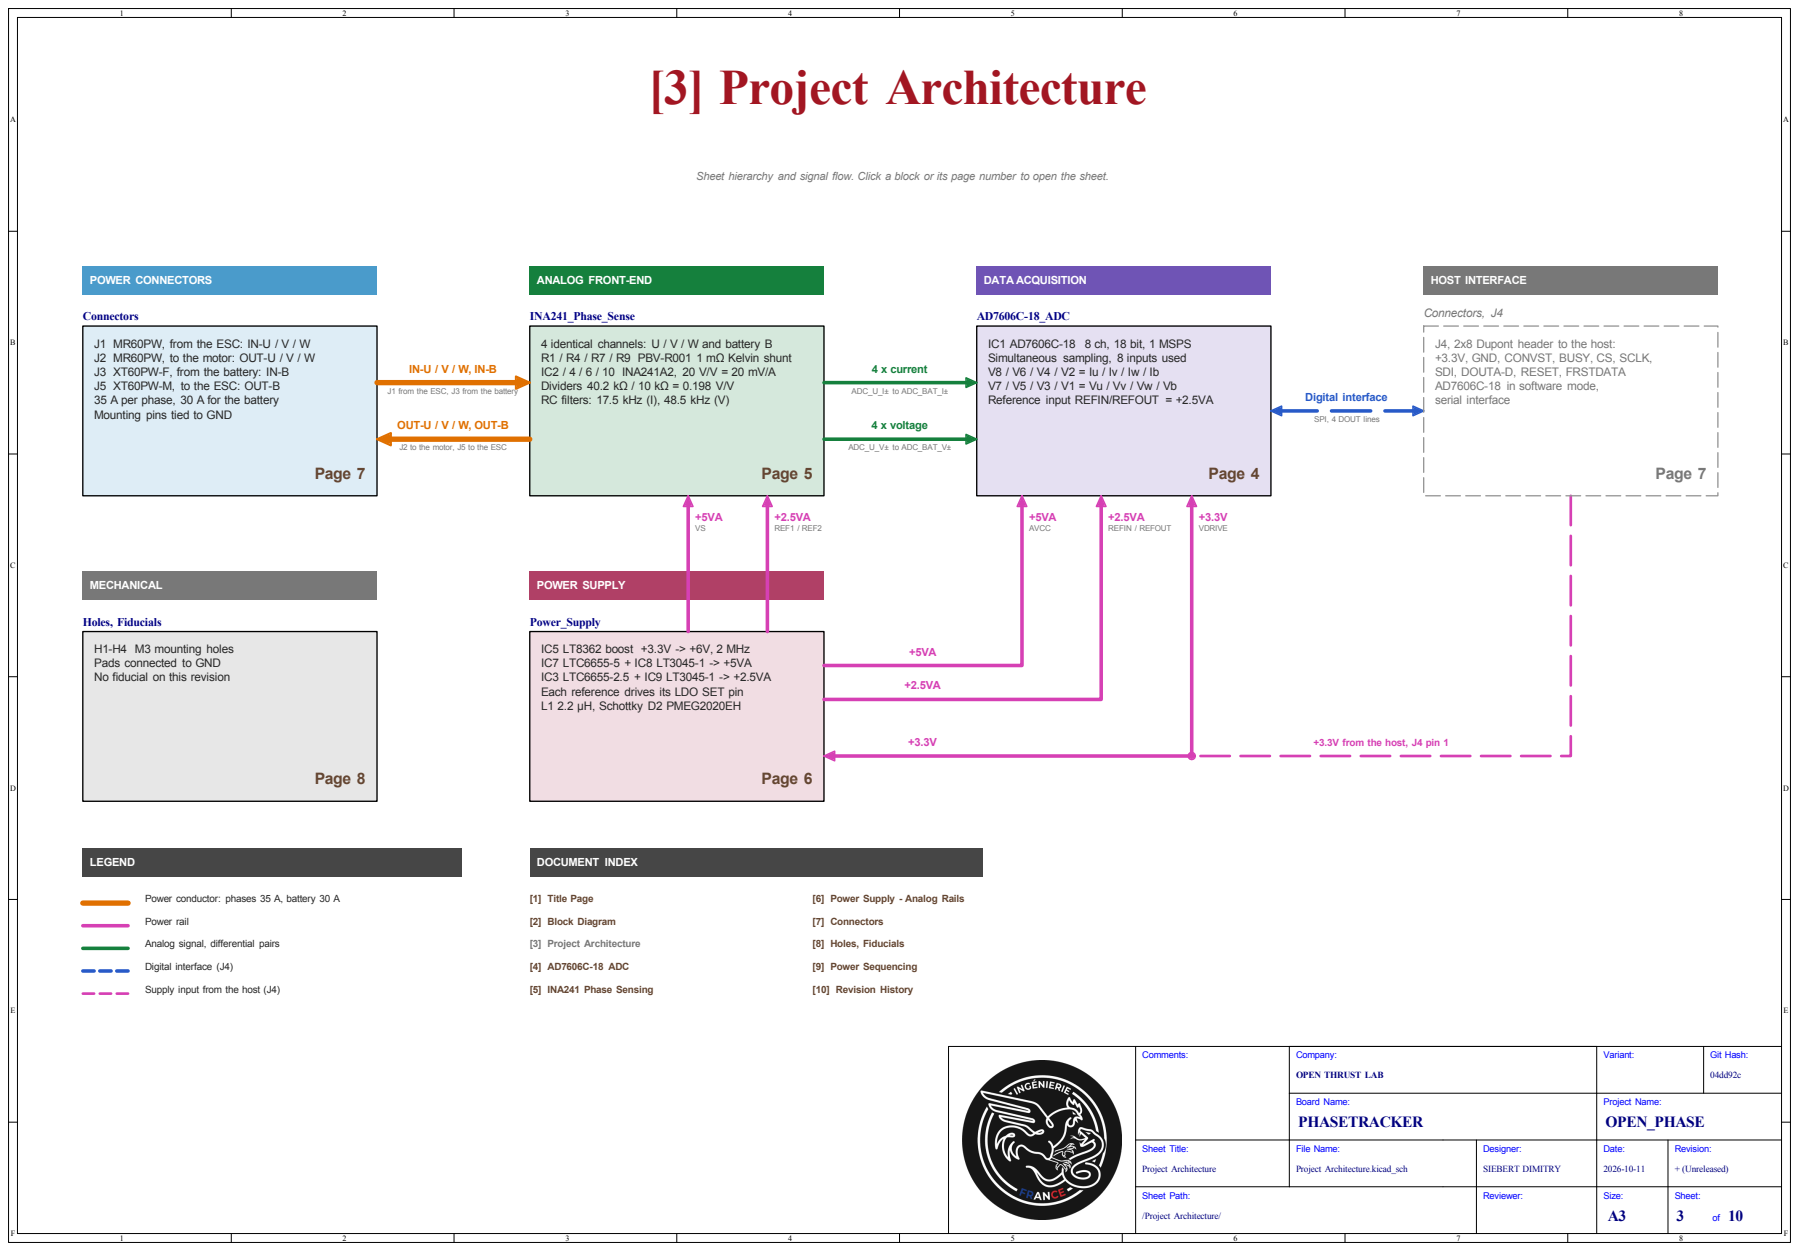
[picture p43: page 1]

Sheet hierarchy and signal flow. Click a block or its page number to open the sheet.

J1 MR60PW, from the ESC: IN-U / V / W
J2 MR60PW, to the motor: OUT-U / V / W
J3 XT60PW-F, from the battery: IN-B
J5 XT60PW-M, to the ESC: OUT-B
35 A per phase, 30 A for the battery
Mounting pins tied to GND

4 identical channels: U / V / W and battery B
R1 / R4 / R7 / R9 PBV-R001 1 mΩ Kelvin shunt
IC2 / 4 / 6 / 10 INA241A2, 20 V/V = 20 mV/A
Dividers 40.2 kΩ / 10 kΩ = 0.198 V/V
RC filters: 17.5 kHz (I), 48.5 kHz (V)

IC1 AD7606C-18 8 ch, 18 bit, 1 MSPS
Simultaneous sampling, 8 inputs used
Reference input REFIN/REFOUT = +2.5VA

J4, 2x8 Dupont header to the host:
+3.3V, GND, CONVST, BUSY, CS, SCLK,
SDI, DOUTA-D, RESET, FRSTDATA
AD7606C-18 in software mode,
serial interface

J1 from the ESC, J3 from the battery

J2 to the motor, J5 to the ESC Digital interface (J4)

REFIN / REFOUT Power conductor: phases 35 A, battery 30 A

H1-H4 M3 mounting holes
Pads connected to GND
No fiducial on this revision

IC5 LT8362 boost +3.3V -> +6V, 2 MHz
IC7 LTC6655-5 + IC8 LT3045-1 -> +5VA
IC3 LTC6655-2.5 + IC9 LT3045-1 -> +2.5VA
Each reference drives its LDO SET pin
L1 2.2 µH, Schottky D2 PMEG2020EH

+3.3V from the host, J4 pin 1

[6] Power Supply - Analog Rails

Analog signal, differential pairs

Supply input from the host (J4)

Revision: + (Unreleased) Date: Project Name: 2026-10-11 Reviewer: Designer:
