foukouda/OPEN_PHASE/Manufacturing/Assembly/OPEN_PHASE-assembly-1.pdf

# PHASETRACKER Assembly Document

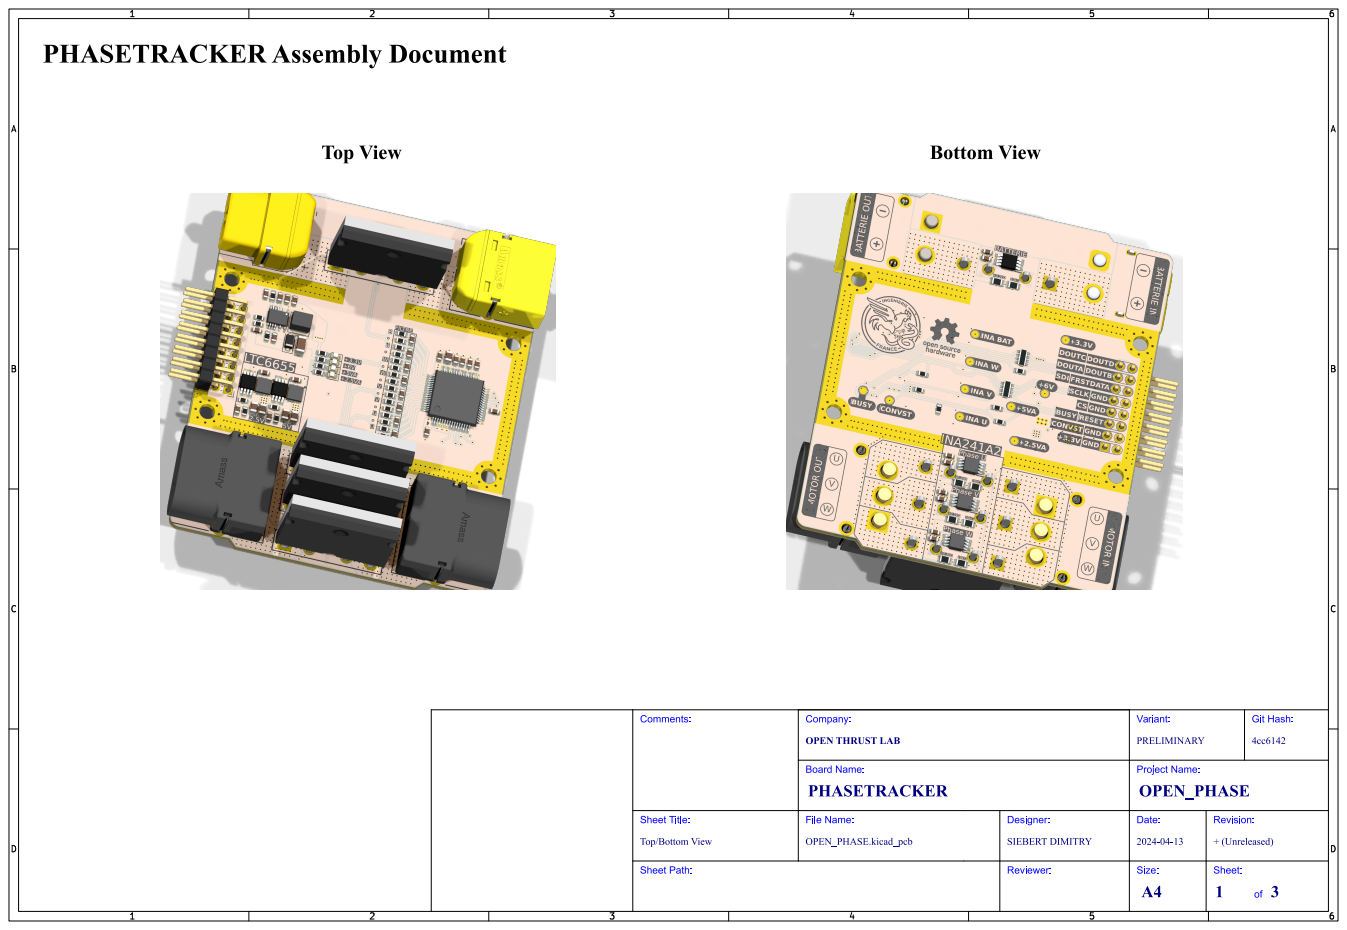
[picture p50: page 1]
Git; Hash:; Comments:; Sheet Path:; Sheet Title:; File Name:; PHASETRACKER; OPEN_PHASE; Company:; PRELIMINARY; Variant:; Board Name:; OPEN_PHASE.kicad_pcb; SIEBERT DIMITRY; Designer:; Reviewer:; Project Name:; Date:; + (Unreleased); Revision:; Size:; Sheet: 1

OPEN THRUST LAB

Top/Bottom View
