foukouda/OPEN_PHASE/Manufacturing/Assembly/OPEN_PHASE-assembly-2.pdf

# Top Assembly (Scale 1:1)

# PHASETRACKER Assembly Document

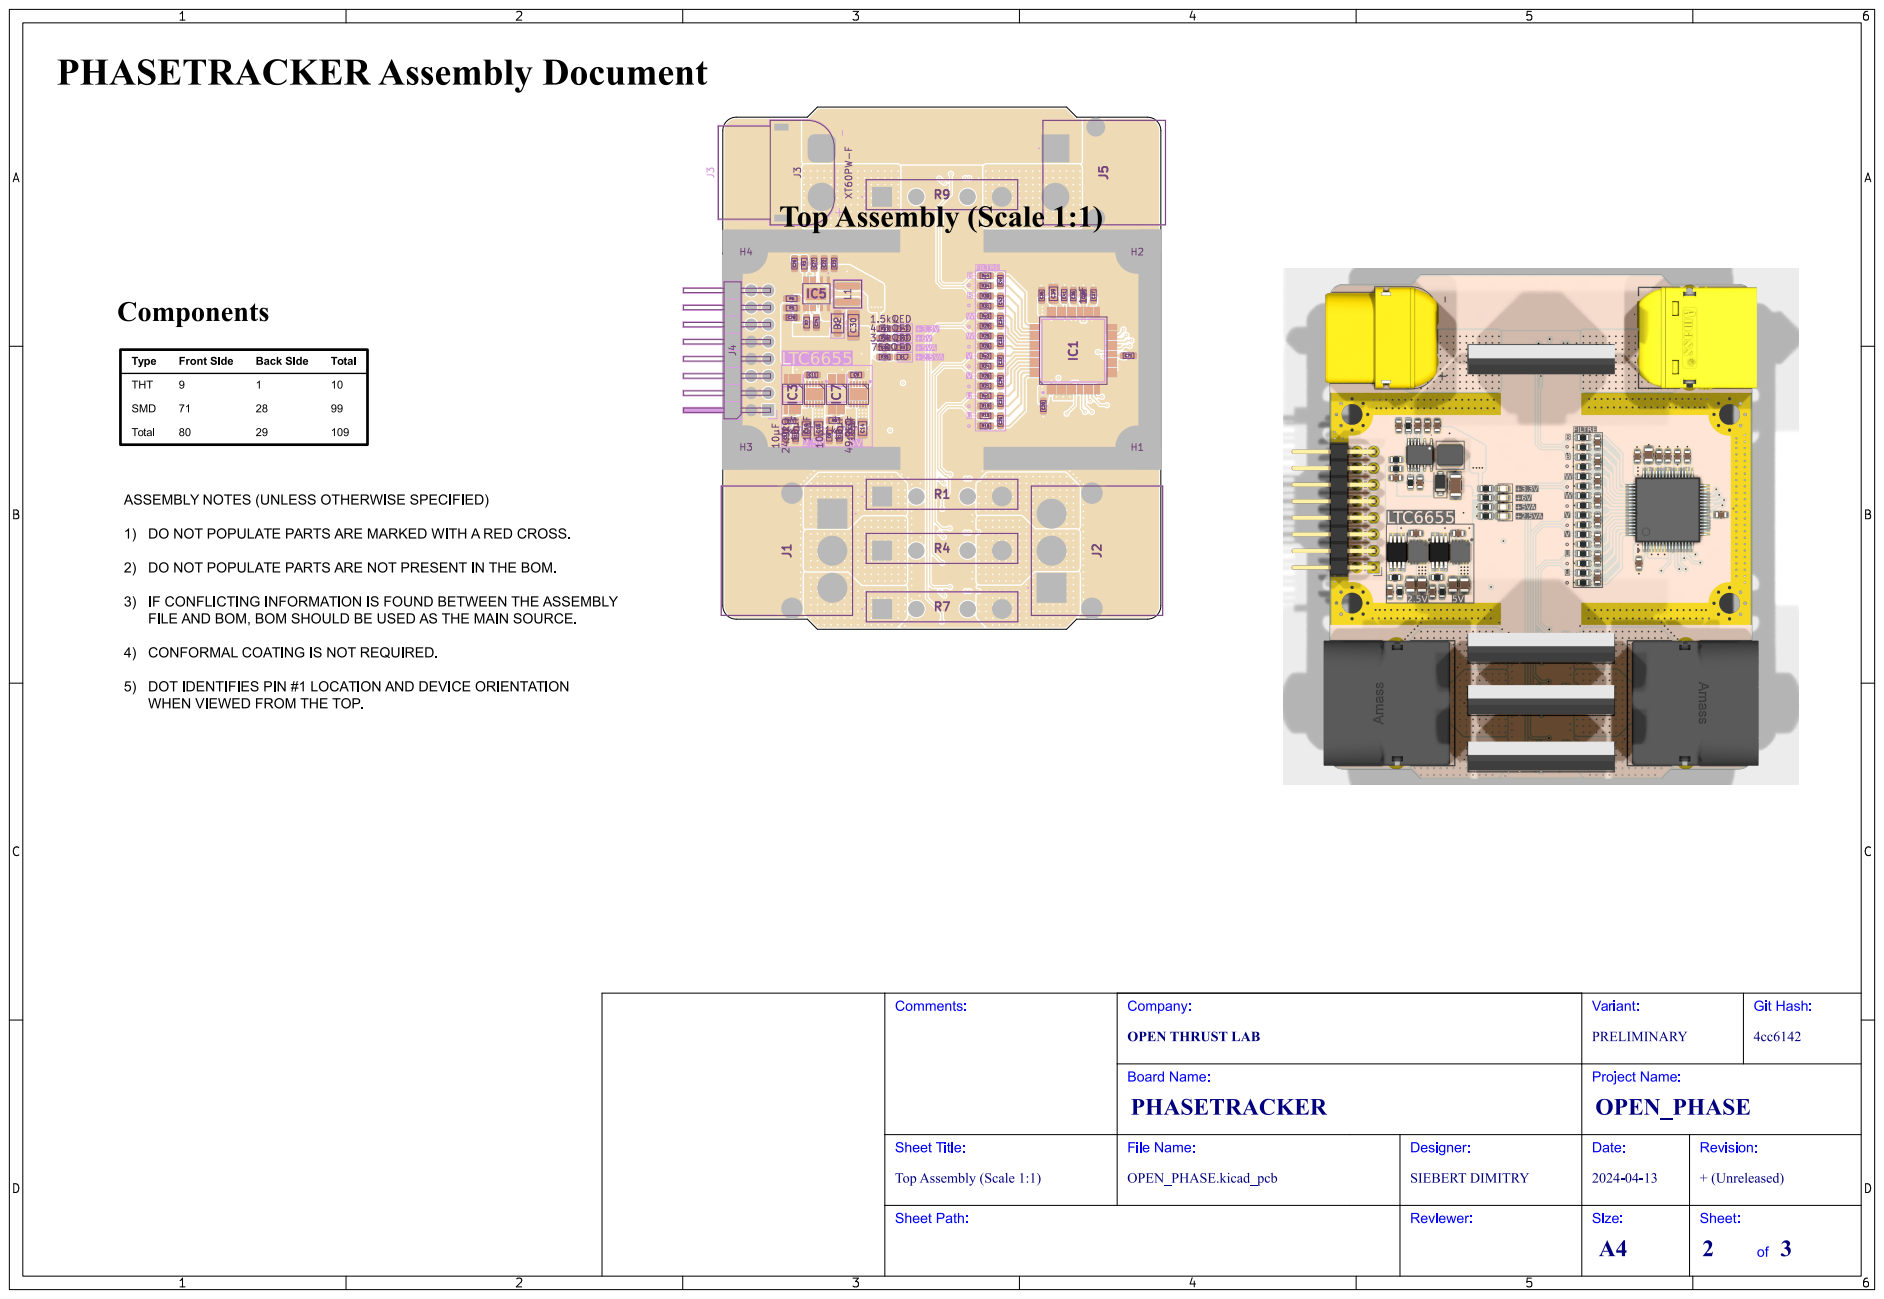
[picture p51: page 1]
