foukouda/OPEN_PHASE/Manufacturing/Assembly/OPEN_PHASE-assembly-3.pdf

# Bottom Assembly (Scale 1:1)

# PHASETRACKER Assembly Document

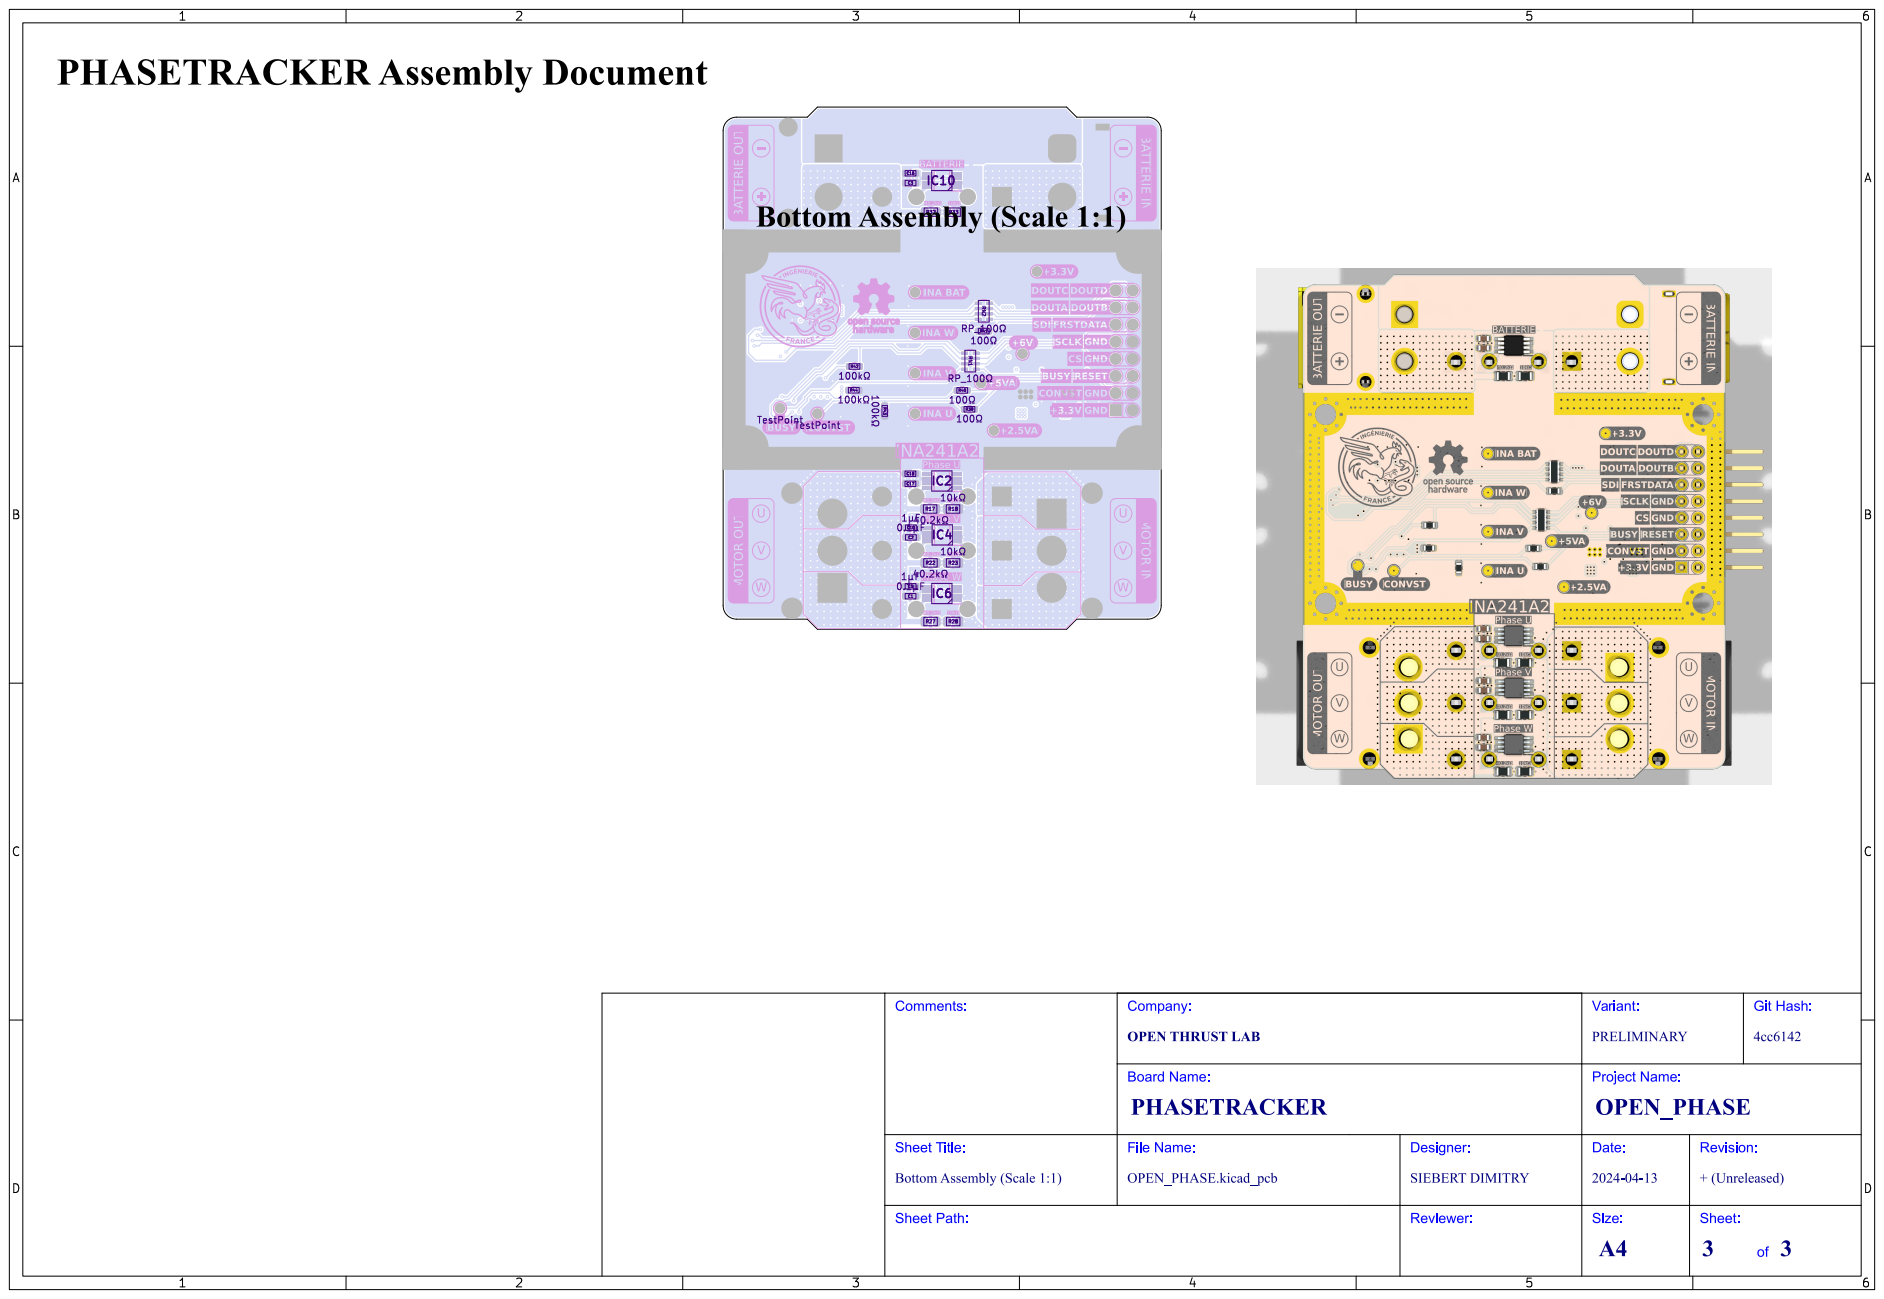
[picture p52: page 1]
