foukouda/OPEN_PHASE/Manufacturing/Assembly/OPEN_PHASE-assembly.pdf

# PHASETRACKER Assembly Document

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

OPEN THRUST LAB

Top/Bottom View

# Top Assembly (Scale 1:1)

# PHASETRACKER Assembly Document


# Bottom Assembly (Scale 1:1)

# PHASETRACKER Assembly Document
