foukouda/OPEN_PHASE/Manufacturing/Fabrication/OPEN_PHASE-fabrication-2.pdf

# Bottom Fabrication (Scale 1:1)

# PHASETRACKER Fabrication Document

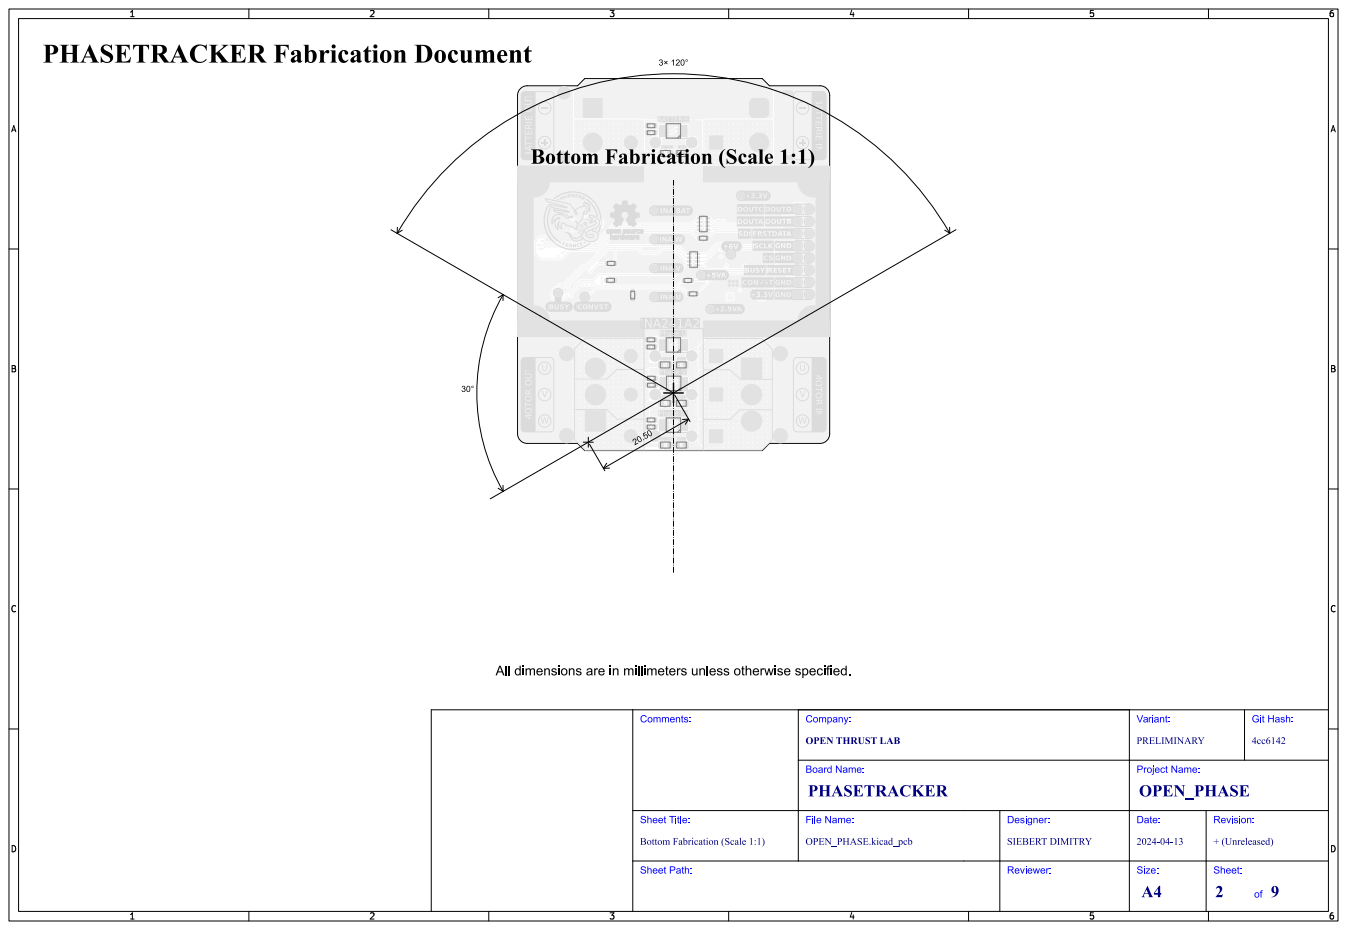
[picture p53: page 1]
Git; Hash:; Comments:; Sheet Path:; Sheet Title:; File Name:; PHASETRACKER; OPEN_PHASE; Company:; PRELIMINARY; Variant:; Board Name:; OPEN_PHASE.kicad_pcb; SIEBERT DIMITRY; Designer:; Reviewer:; Project Name:; Date:; + (Unreleased); Revision:; Size:; Sheet: 2

OPEN THRUST LAB

Bottom Fabrication (Scale 1:1)
