foukouda/OPEN_PHASE/Manufacturing/Fabrication/OPEN_PHASE-fabrication-9.pdf

# L6 (Sig, PWR) (Scale 1:1)

# PHASETRACKER Fabrication Document

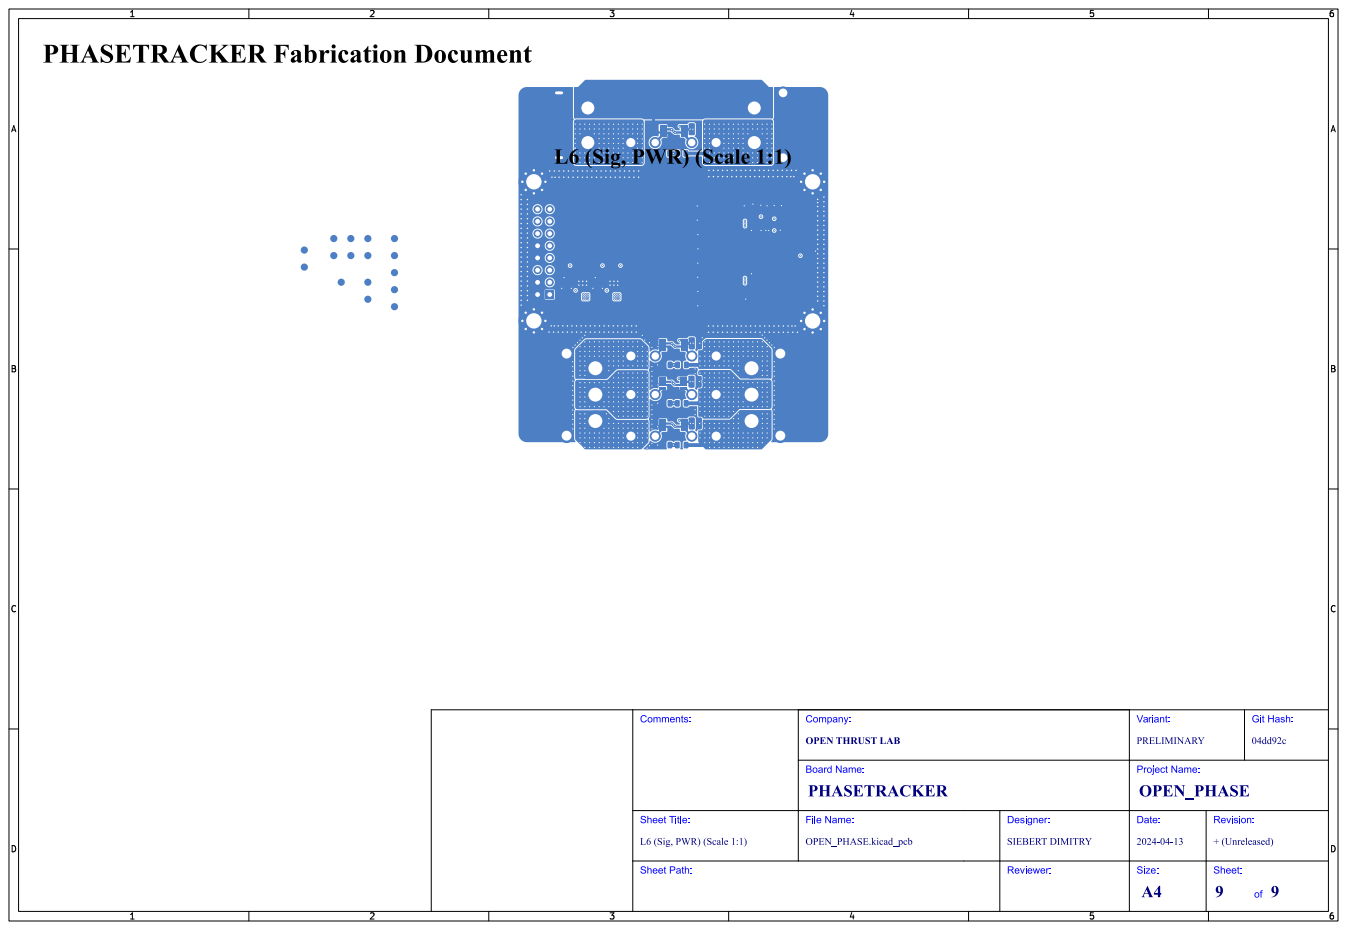
[picture p57: page 1]
Git; Hash:; Comments:; Sheet Path:; Sheet Title:; File Name:; PHASETRACKER; OPEN_PHASE; Company:; PRELIMINARY; Variant:; Board Name:; OPEN_PHASE.kicad_pcb; SIEBERT DIMITRY; Designer:; Reviewer:; Project Name:; Date:; + (Unreleased); Revision:; Size:; Sheet: 9

OPEN THRUST LAB

L6 (Sig, PWR) (Scale 1:1)
