foukouda/OPEN_PHASE/Manufacturing/Fabrication/OPEN_PHASE-fabrication-5.pdf

# Bottom Test Points (Scale 1:1)

# PHASETRACKER Fabrication Document

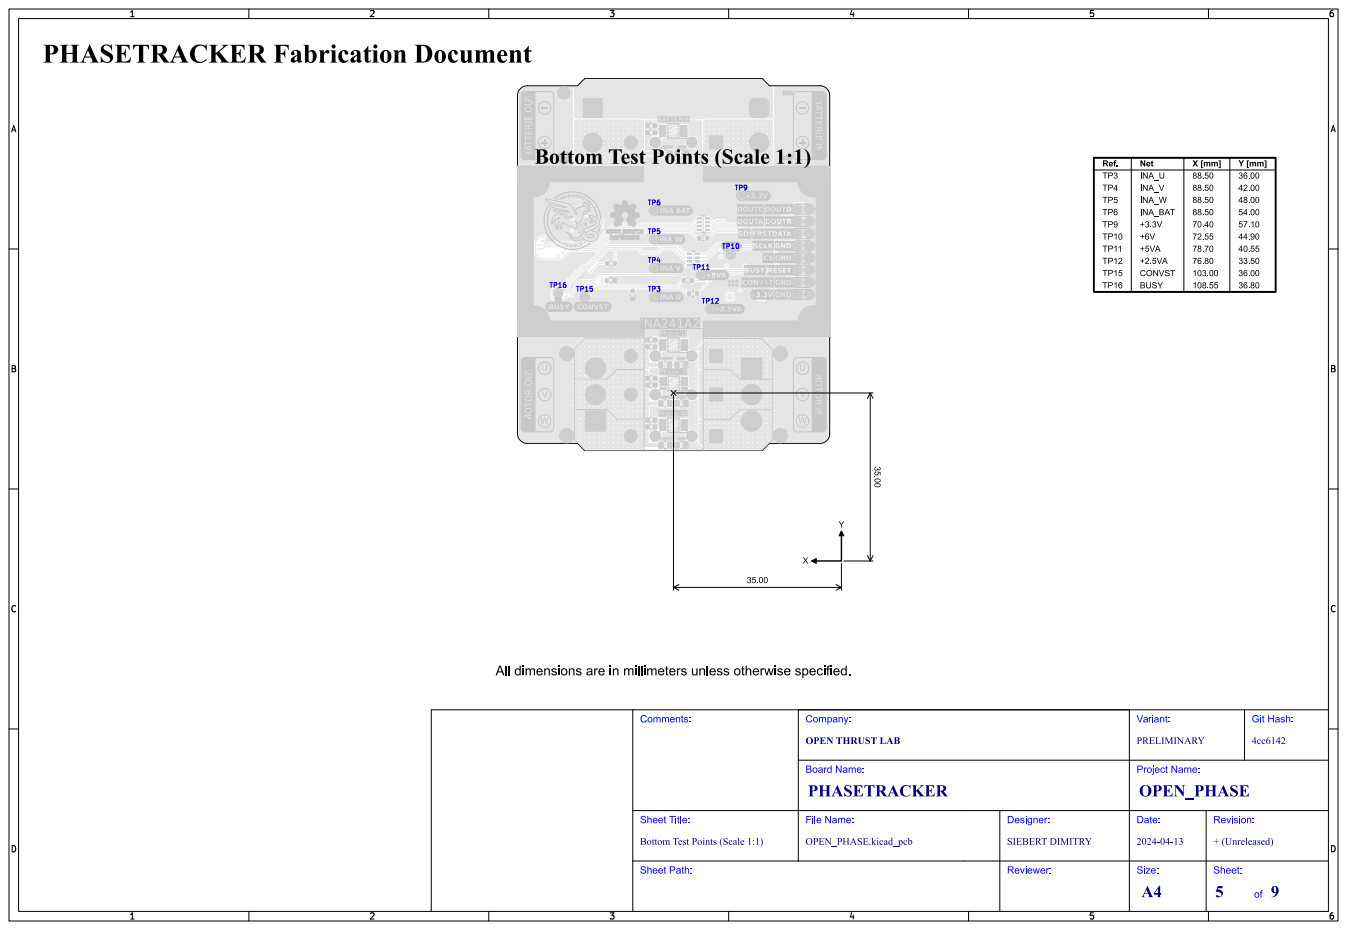
[picture p58: page 1]

Bottom Test Points (Scale 1:1)
