foukouda/OPEN_PHASE/Manufacturing/Fabrication/Gerbers/OPEN_PHASE-NPTH_drill_map.pdf

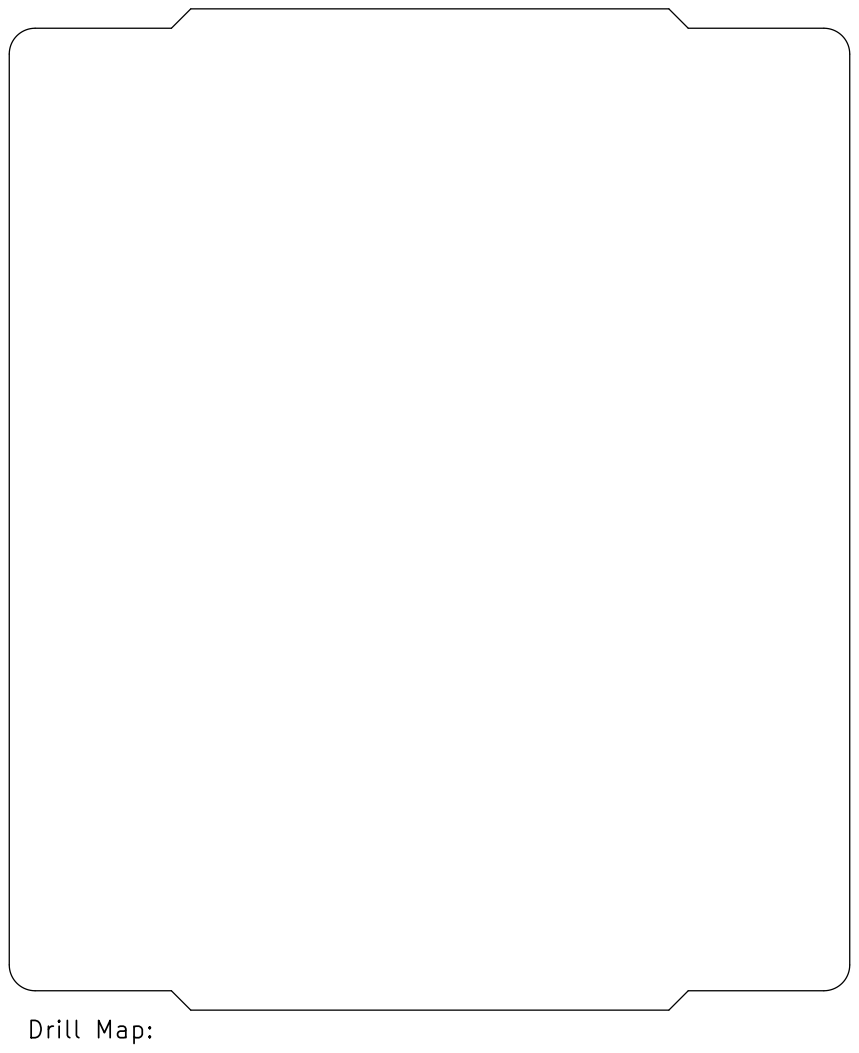
[picture p59: page 1]
