foukouda/OPEN_PHASE/Manufacturing/Fabrication/Gerbers/OPEN_PHASE-PTH_drill_map.pdf

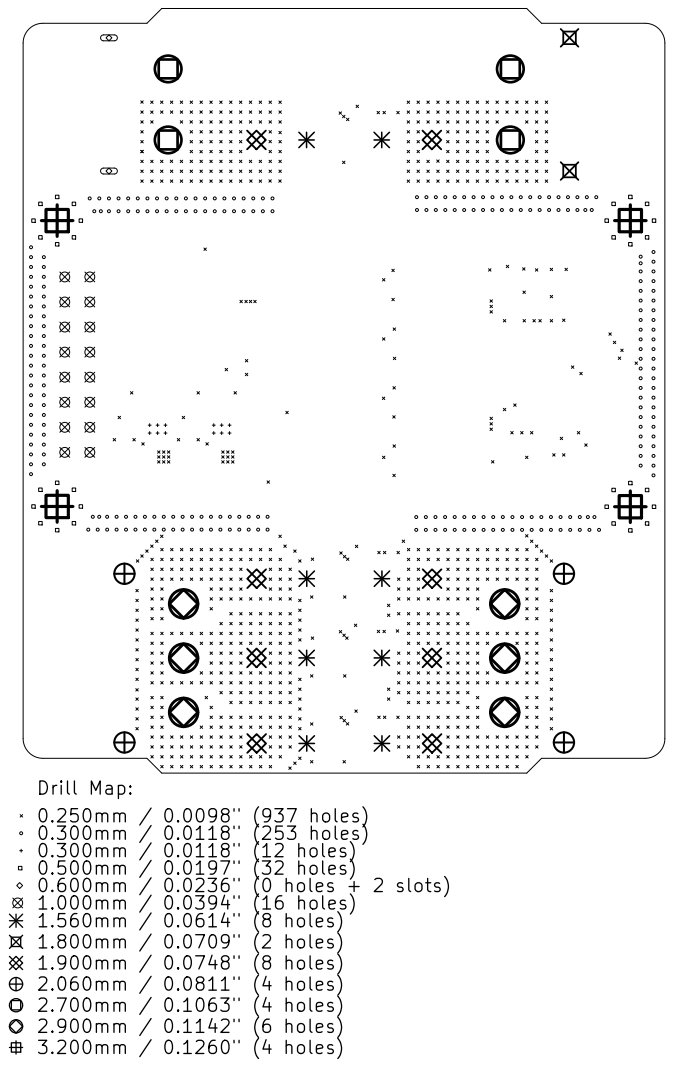
[picture p60: page 1]
