foukouda/OPEN_PHASE/Simulation/LTspice/05_Measurement_Channels_AC.asc

C25: cap; 1n
C31: cap; 180p
CIN_IN: cap; 5p
CIN_IP: cap; 5p
CIN_VN: cap; 5p
CIN_VP: cap; 5p
I_M: current; 0; AC {k}
IC2: INA241A2_behav
R1: res; 1m
R15: res; 33
R16: res; 9.1k
R17: res; 40.2k
R18: res; 10k
R19: res; 9.1k
Re1: res; 1k
RIN_IN: res; 1.2Meg
RIN_IP: res; 1.2Meg
RIN_VN: res; 1.2Meg
RIN_VP: res; 1.2Meg
V_2V5A: voltage; 2.5
V_5VA: voltage; 5
V_PH: voltage; 12; AC {1-k}
VB_I: voltage; 2
VB_V: voltage; 2
Named nets: 0, IN-U, OUT-U, +5VA, +2.5VA, SNG-A1N, V8+, V8-, V7+, V7-
OPEN_PHASE - 05 - Measurement channels : frequency response (shunt / divider -> AD7606C pins)
k = 1 : AC on the phase current (current channel, V/A).  k = 0 : AC on the phase voltage (voltage channel, V/V).
ESC phase U
(J1 pin 1)
I_M = motor phase current (J2 pin 3)
PBV-R001 shunt
AD7606C-18 V8+ / V8- input pins
(RIN 1.2 Meg to an internal 2 V node, CIN 5 pF)
CURRENT CHANNEL  (phase U : R1, IC2, R15, C25, R16 -> AD7606C V8)
AD7606C-18 V7+ / V7- input pins
(RIN 1.2 Meg to an internal 2 V node, CIN 5 pF)
VOLTAGE CHANNEL  (phase U : R17, R18, Re1, C31, R19 -> AD7606C V7)
Ideal analog rails
(see 02 for the real ones)
.ac dec 100 10 10Meg
.step param k list 0 1
.meas ac G_I FIND mag(V(V8+,V8-)) AT 10
.meas ac F3dB_I WHEN mag(V(V8+,V8-))=G_I/sqrt(2)
.meas ac G_I_24k FIND mag(V(V8+,V8-)) AT 24k
.meas ac G_I_2M FIND mag(V(V8+,V8-)) AT 2Meg
.meas ac G_V FIND mag(V(V7+,V7-)) AT 10
.meas ac F3dB_V WHEN mag(V(V7+,V7-))=G_V/sqrt(2)
.meas ac G_V_24k FIND mag(V(V7+,V7-)) AT 24k
.meas ac G_V_2M FIND mag(V(V7+,V7-)) AT 2Meg
