foukouda/OPEN_PHASE/Simulation/LTspice/06_Measurement_Channels_Step.asc

C25: cap; 1n
C31: cap; 180p
CIN_IN: cap; 5p
CIN_IP: cap; 5p
CIN_VN: cap; 5p
CIN_VP: cap; 5p
I_M: current; PWL(0 0 300u 0 300.1u 35)
IC2: INA241A2_behav
R1: res; 1m
R15: res; 33
R16: res; 9.1k
R17: res; 40.2k
R18: res; 10k
R19: res; 9.1k
Re1: res; 1k
RIN_IN: res; 1.2Meg
RIN_IP: res; 1.2Meg
RIN_VN: res; 1.2Meg
RIN_VP: res; 1.2Meg
V_2V5A: voltage; 2.5
V_5VA: voltage; 5
V_PH: voltage; PWL(0 0 100u 0 100.1u 25.2)
VB_I: voltage; 2
VB_V: voltage; 2
Named nets: 0, IN-U, OUT-U, +5VA, +2.5VA, SNG-A1N, V8+, V8-, V7+, V7-
OPEN_PHASE - 06 - Measurement channels : DC transfer and step response
Phase voltage steps 0 -> 25.2 V (6S battery) at 100 us, phase current steps 0 -> 35 A (MR60 rating, J1 -> J2) at 300 us.
ESC phase U
(J1 pin 1)
I_M = motor phase current (J2 pin 3)
PBV-R001 shunt
AD7606C-18 V8+ / V8- input pins
(RIN 1.2 Meg to an internal 2 V node, CIN 5 pF)
CURRENT CHANNEL  (phase U : R1, IC2, R15, C25, R16 -> AD7606C V8)
AD7606C-18 V7+ / V7- input pins
(RIN 1.2 Meg to an internal 2 V node, CIN 5 pF)
VOLTAGE CHANNEL  (phase U : R17, R18, Re1, C31, R19 -> AD7606C V7)
Ideal analog rails
(see 02 for the real ones)
.tran 0 600u 0 20n
.meas tran VI_zero AVG V(V8+,V8-) FROM 50u TO 90u
.meas tran VI_35A AVG V(V8+,V8-) FROM 550u TO 600u
.meas tran V8N_bias AVG V(V8-) FROM 550u TO 600u
.meas tran T_I_1pct WHEN V(V8+,V8-)=VI_zero+0.99*(VI_35A-VI_zero) FALL=1
.meas tran VV_zero AVG V(V7+,V7-) FROM 50u TO 90u
.meas tran VV_25V AVG V(V7+,V7-) FROM 250u TO 290u
.meas tran VOUTU AVG V(OUT-U) FROM 250u TO 290u
.meas tran T_V_1pct WHEN V(V7+,V7-)=VV_zero+0.99*(VV_25V-VV_zero) RISE=1
