foukouda/OPEN_PHASE/Simulation/LTspice/07_Measurement_Quality_Waveforms.asc

B_ESC: bi; I=(V(IN-U)*I(L_M)+V(IN-V)*I(L_MV)+V(IN-W)*I(L_MW))/max(V(OUT-B),1)
B_PH: bv; V={Vbat}*limit(0,1,0.5+{kedge}*(V(MOD)-V(CAR)))
B_PHV: bv; V={Vbat}*limit(0,1,0.5+{kedge}*(V(MODV)-V(CAR)))
B_PHW: bv; V={Vbat}*limit(0,1,0.5+{kedge}*(V(MODW)-V(CAR)))
C25: cap; 1n
C31: cap; 180p
C40: cap; 180p
C42: cap; 1n
C_DC: cap; {Cdc}; Rser={Resr} IC={Vbat}
CIN_IBN: cap; 5p
CIN_IBP: cap; 5p
CIN_IN: cap; 5p
CIN_IP: cap; 5p
CIN_VBN: cap; 5p
CIN_VBP: cap; 5p
CIN_VN: cap; 5p
CIN_VP: cap; 5p
IC2: INA241A2_behav
IC10: INA241A2_behav
L_BAT: ind; {Lb}; Rser=0
L_M: ind; {Lm}; Rser=0
L_MV: ind; {Lm+Lsh}; Rser=0
L_MW: ind; {Lm+Lsh}; Rser=0
L_SH: ind; {Lsh}; Rser=0
L_SHB: ind; {Lsh}; Rser=0
R1: res; 1m
R9: res; 1m
R15: res; 33
R16: res; 9.1k
R17: res; 40.2k
R18: res; 10k
R19: res; 9.1k
R30: res; 33
R31: res; 9.1k
R32: res; 40.2k
R33: res; 10k
R34: res; 9.1k
R_BAT: res; {Rb}
R_M: res; {Rm}
R_MV: res; {Rm+1m}
R_MW: res; {Rm+1m}
Re1: res; 1k
Re4: res; 1k
RIN_IBN: res; 1.2Meg
RIN_IBP: res; 1.2Meg
RIN_IN: res; 1.2Meg
RIN_IP: res; 1.2Meg
RIN_VBN: res; 1.2Meg
RIN_VBP: res; 1.2Meg
RIN_VN: res; 1.2Meg
RIN_VP: res; 1.2Meg
V_2V5A: voltage; 2.5
V_5VA: voltage; 5
V_BAT: voltage; {Vbat}
V_BEMF: voltage; SINE({Vbat/2} {Eb} {fe})
V_BEMFV: voltage; SINE({Vbat/2} {Eb} {fe} 0 0 -120)
V_BEMFW: voltage; SINE({Vbat/2} {Eb} {fe} 0 0 -240)
V_CAR: voltage; PULSE(0 1 0 {0.5/fpwm} {0.5/fpwm} 0 {1/fpwm})
V_MOD: voltage; SINE(0.5 {m/2} {fe} 0 0 {phi})
V_MODV: voltage; SINE(0.5 {m/2} {fe} 0 0 {phi-120})
V_MODW: voltage; SINE(0.5 {m/2} {fe} 0 0 {phi-240})
VB_I: voltage; 2
VB_IB: voltage; 2
VB_V: voltage; 2
VB_VB: voltage; 2
Named nets: 0, IN-U, OUT-U, +5VA, +2.5VA, SNG-A1N, V8+, V8-, V7+, V7-, IN-B, OUT-B, SNG-A4N, V2+, V2-, V1+, V1-, IN-V, MODV, IN-W, MODW, MOD, CAR
OPEN_PHASE - 07 - Measurement quality : ESC waveforms through the phase U and battery channels
The phase voltage, the motor current, the DC bus voltage and the battery current are the reference. run_simulations.py compares them with what the AD7606C pins see.
ESC phase U
(J1 pin 1)
Motor phase U (J2 pin 3): inductance, resistance, back-EMF around Vbat / 2
PBV-R001 shunt, L_SH = its inductance (datasheet: < 10 nH)
AD7606C-18 V8+ / V8- input pins
(RIN 1.2 Meg to an internal 2 V node, CIN 5 pF)
CURRENT CHANNEL  (phase U : R1, IC2, R15, C25, R16 -> AD7606C V8)
AD7606C-18 V7+ / V7- input pins
(RIN 1.2 Meg to an internal 2 V node, CIN 5 pF)
VOLTAGE CHANNEL  (phase U : R17, R18, Re1, C31, R19 -> AD7606C V7)
Ideal analog rails
(see 02 for the real ones)
Battery and its leads
(resistance and inductance: assumed)
ESC: input capacitor (assumed) and DC side of the three half-bridges
PBV-R001 shunt, L_SHB = its inductance (datasheet: < 10 nH)
AD7606C-18 V2+ / V2- input pins
(RIN 1.2 Meg to an internal 2 V node, CIN 5 pF)
CURRENT CHANNEL  (battery B : R9, IC10, R30, C42, R31 -> AD7606C V2)
AD7606C-18 V1+ / V1- input pins
(RIN 1.2 Meg to an internal 2 V node, CIN 5 pF)
VOLTAGE CHANNEL  (battery B : R32, R33, Re4, C40, R34 -> AD7606C V1)
B_ESC: the DC bus supplies the power that the three half-bridges deliver to the phases
PHASES V AND W  (power path only, to load the DC bus)
Same PWM and same motor phase as U, 120 and 240 degrees later.
L_MV, L_MW and R_MV, R_MW include the shunts R4 and R7.
PWM modulator: sine reference (MOD) against a triangle carrier (CAR)
.tran 0 8m 0 50n uic
.options plotwinsize=0
.step param Lsh list 1p 5n 10n
.param Vbat=25.2 fpwm=24k fe=1k m=0.774 phi=22.7 kedge=200
.param Lm=30u Rm=50m Eb=8
.param Rb=20m Lb=300n Cdc=470u Resr=30m
6S battery, 24 kHz PWM, 1 kHz electrical frequency. Three runs: shunts without inductance, 5 nH, 10 nH.
20 A peak in phase with the back-EMF: 90 W in each phase, PWM ripple of about 8 A pp.
DC bus: battery and leads 20 mOhm / 300 nH, ESC input capacitor 470 uF / 30 mOhm.
These four values are assumed (no battery or ESC is specified in the project).
.save V(IN-U) V(OUT-U) I(L_M) V(V8+) V(V8-) V(V7+) V(V7-)
.save V(OUT-B) I(L_BAT) V(V2+) V(V2-) V(V1+) V(V1-)
