foukouda/OPEN_PHASE/Simulation/LTspice/08_Measurement_Quality_Tolerances.asc

C25: cap; 1n
C31: cap; 180p
CIN_IN: cap; 5p
CIN_IP: cap; 5p
CIN_VN: cap; 5p
CIN_VP: cap; 5p
I_M: current; 0
IC2: INA241A2_behav; G={mc(20,tolG)} Vos={flat(15u)}
R1: res; {R1v}
R15: res; {R15v}
R16: res; {R16v}
R17: res; {R17v}
R18: res; {R18v}
R19: res; {R19v}
Re1: res; {Re1v}
RIN_IN: res; {RiN}
RIN_IP: res; {RiP}
RIN_VN: res; {RvN}
RIN_VP: res; {RvP}
V_2V5A: voltage; {V25}
V_5VA: voltage; 5
V_PH: voltage; 0
VB_I: voltage; 2
VB_V: voltage; 2
Named nets: 0, IN-U, OUT-U, +5VA, +2.5VA, SNG-A1N, V8+, V8-, V7+, V7-
OPEN_PHASE - 08 - Measurement quality : Monte Carlo on the tolerances (phase U, DC readings)
Each run draws every tolerance again. The readings at 0 / 35 A and 0 / 25.2 V give the spread of offset and gain before calibration.
ESC phase U
(J1 pin 1)
I_M = motor phase current (J2 pin 3)
PBV-R001 shunt
AD7606C-18 V8+ / V8- input pins
(RIN 1.2 Meg to an internal 2 V node, CIN 5 pF)
CURRENT CHANNEL  (phase U : R1, IC2, R15, C25, R16 -> AD7606C V8)
AD7606C-18 V7+ / V7- input pins
(RIN 1.2 Meg to an internal 2 V node, CIN 5 pF)
VOLTAGE CHANNEL  (phase U : R17, R18, Re1, C31, R19 -> AD7606C V7)
Ideal analog rails
(see 02 for the real ones)
.dc I_M 0 35 35 V_PH 0 25.2 25.2
.step param run 1 1000 1
.param tolSh=0.005 tolR=0.01 tolG=100u tolRin=0.167
.param R1v={mc(1m,tolSh)} R15v={mc(33,tolR)} R16v={mc(9.1k,tolR)}
.param R17v={mc(40.2k,tolR)} R18v={mc(10k,tolR)} Re1v={mc(1k,tolR)} R19v={mc(9.1k,tolR)}
.param RiP={mc(1.2Meg,tolRin)} RiN={mc(1.2Meg,tolRin)} RvP={mc(1.2Meg,tolRin)} RvN={mc(1.2Meg,tolRin)}
.param R11v={mc(1k,tolR)} R12v={mc(24.9k,tolR)} Iset={mc(100u,0.02)}
.param V25={(2.5*(1+flat(250u))/R11v+Iset)/(1/R11v+1/R12v)+flat(2m)}
tolSh: PBV shunt 0.5 %.  tolR: resistors, 1 % assumed.  IC2: gain 20 V/V +/-0.01 %, offset +/-15 uV (INA241A2 datasheet maximum).
RiP, RiN, RvP, RvN: AD7606C input resistances, 1.0 ... 1.4 Meg.  V25: +2.5VA from the LTC6655B (0.025 %), the SET network
(ISET 100 uA +/-2 %, R11, R12) and the LT3045-1 offset (+/-2 mV).
.save V(IN-U) V(OUT-U) V(V8+) V(V8-) V(V7+) V(V7-) V(+2.5VA)
