foukouda/OPEN_PHASE/Simulation/LTspice/01_Power_Chain_Startup.asc

C1: cap; 0.1u; m=7 Rser=20m
C5: cap; 1u; m=4 Rser=10m
C8: cap; 10u; Rser=5m
C9: cap; 4.7u; Rser=5m
C11: cap; 4.7u; Rser=5m
C12: cap; 10u; Rser=5m
C13: cap; 10u; Rser=5m
C14: cap; 10u; Rser=5m
C15: cap; 10u; Rser=5m
C19: cap; 10u; Rser=5m
C21: cap; 0.1u; Rser=20m
C22: cap; 4.7u; Rser=5m
C23: cap; 0.1u; Rser=20m
C24: cap; 10n
C26: cap; 1n
C27: cap; 1u
C28: cap; 4.7p
C30: cap; 22u; Rser=3m
C41: cap; 0.1u; Rser=20m
D2: schottky; PMEG2020AEA
I_AVCC: current; {Iavcc}
I_INA: current; 10m
I_REF: current; 100u
I_VDRIVE: current; 1.8m
IC3: LTC6655-2.5
IC5: LT8362
IC7: LTC6655-5
IC8: LT3045-1
IC9: LT3045-1
L1: ind; 2.2u; Rser=22m
R2: res; 20k
R3: res; 36.5k
R5: res; 1Meg
R6: res; 365k
R8: res; 1k
R11: res; 1k
R12: res; 24.9k
R14: res; 49.9k
V1: voltage; PWL(0 0 100u 3.3); Rser=20m
Named nets: 0, +3.3V, SW, SS, INTVCC, VC, CC, FBX, REF5, SET5, +6V, +5VA, REF2V5, SET2V5, +2.5VA
OPEN_PHASE - 01 - Power chain start-up : +3.3V -> LT8362 -> +6V -> LT3045-1 -> +5VA / +2.5VA
Switching simulation (2 MHz) of the boost soft-start, as built. Full settling of the analog rails: see 02_Analog_Rails_Startup.asc
Host +3.3V
(no connector on the board yet)
C21 + I_VDRIVE =
AD7606C VDRIVE (1 MSPS)
WE-MAPI 4030 74438357022
PMEG2020EH
SYNC/MODE open
= pulse-skipping
LT8362 BOOST  +3.3V -> +6V, 2 MHz   (schematic sheet ALIMENTATION)
PGFB = IN : fast start-up and PG disabled
VIOC, PG open
C1 (x7) = C1 C2 C3 C17 C20 C35 C38
C5 (x4) = C5 C10 C16 C18
I_AVCC = AD7606C AVCC (1 MSPS)
I_INA = 4 x INA241 IQ
(3 phases + DC bus)
+5VA : LTC6655-5 (IC7) reference buffered by LT3045-1 (IC8)
PGFB = IN : fast start-up and PG disabled
VIOC, PG open
C41 = AD7606C REFIN/REFOUT
I_REF = INA241 REF pins + REFIN (estimate)
+2.5VA : LTC6655-2.5 (IC3) reference buffered by LT3045-1 (IC9)
.tran 0 12m 0 20n
.param Iavcc=45m
.save V(+3.3V) V(+6V) V(+5VA) V(+2.5VA) V(SS) V(VC) V(SET5) V(SET2V5) V(REF5) V(REF2V5) I(L1) I(V1)
.meas tran V6_at_12ms AVG V(+6V) FROM 11m TO 12m
.meas tran V6_max MAX V(+6V)
.meas tran T6_90 WHEN V(+6V)=5.37 RISE=1
.meas tran IL_peak MAX I(L1)
.meas tran I3V3_inrush MIN I(V1)
.model PMEG2020AEA D(Is=5.409u Rs=.05676 N=1.02 Cjo=.1908n M=.4863 Eg=.69 Xti=2 BV=22 IBV=50u Vj=.3408 Iave=2 Vpk=20 mfg=NXP type=Schottky)
