foukouda/OPEN_PHASE/Simulation/LTspice/03_Boost_Ripple.asc

C9: cap; 4.7u; Rser=5m
C11: cap; 4.7u; Rser=5m
C21: cap; 0.1u; Rser=20m
C22: cap; 4.7u; Rser=5m
C23: cap; 0.1u; Rser=20m
C24: cap; 10n
C26: cap; 1n
C27: cap; 1u
C28: cap; 4.7p
C30: cap; 22u; Rser=3m
D2: schottky; PMEG2020AEA
I_6V: current; PWL(0 0 2m 0 2.1m {I6})
I_VDRIVE: current; 1.8m
IC5: LT8362
L1: ind; 2.2u; Rser=22m
R2: res; 20k
R3: res; 36.5k
R5: res; 1Meg
R6: res; 365k
V1: voltage; PWL(0 0 100u 3.3); Rser=20m
Named nets: 0, +3.3V, SW, SS, INTVCC, VC, CC, FBX, +6V
OPEN_PHASE - 03 - Steady-state ripple of the LT8362 boost on +6V
Boost alone, loaded by the input current of both analog rails (AD7606C at 1 MSPS, see I_6V in 02). Measured over 5..6 ms.
Host +3.3V
(no connector on the board yet)
C21 + I_VDRIVE =
AD7606C VDRIVE (1 MSPS)
WE-MAPI 4030 74438357022
PMEG2020EH
SYNC/MODE open
= pulse-skipping
LT8362 BOOST  +3.3V -> +6V, 2 MHz   (schematic sheet ALIMENTATION)
I_6V = input current of both LT3045-1
and both LTC6655 (simulation 02)
.tran 0 6m 0 5n
.param I6=67.9m
.options plotwinsize=0
.save V(+3.3V) V(+6V) V(SW) I(L1) I(V1) V(VC)
.meas tran V6_avg AVG V(+6V) FROM 5m TO 6m
.meas tran V6_pp PP V(+6V) FROM 5m TO 6m
.meas tran I3V3 AVG I(V1) FROM 5m TO 6m
.meas tran IL_pk MAX I(L1) FROM 5m TO 6m
.meas tran V3V3_pp PP V(+3.3V) FROM 5m TO 6m
.model PMEG2020AEA D(Is=5.409u Rs=.05676 N=1.02 Cjo=.1908n M=.4863 Eg=.69 Xti=2 BV=22 IBV=50u Vj=.3408 Iave=2 Vpk=20 mfg=NXP type=Schottky)
