foukouda/OPEN_PHASE/Simulation/LTspice/02_Analog_Rails_Startup.asc

C1: cap; 0.1u; m=7 Rser=20m
C5: cap; 1u; m=4 Rser=10m
C8: cap; 10u; Rser=5m
C12: cap; 10u; Rser=5m
C13: cap; 10u; Rser=5m
C14: cap; 10u; Rser=5m
C15: cap; 10u; Rser=5m
C19: cap; 10u; Rser=5m
C41: cap; 0.1u; Rser=20m
I_AVCC: current; {Iavcc}
I_INA: current; 10m
I_REF: current; 100u
IC3: LTC6655-2.5
IC7: LTC6655-5
IC8: LT3045-1
IC9: LT3045-1
R8: res; 1k
R11: res; 1k
R12: res; 24.9k
R14: res; 49.9k
V_6V: voltage; PWL(0 0 1m 5.96); Rser=10m
Named nets: 0, REF5, SET5, +6V, +5VA, REF2V5, SET2V5, +2.5VA
OPEN_PHASE - 02 - Analog rails start-up and accuracy : +5VA and +2.5VA
The boost is replaced by its settled output (1 ms ramp, see 01), so the rails can be followed until they are settled.
+6V from the boost
(1 ms ramp)
PGFB = IN : fast start-up and PG disabled
VIOC, PG open
C1 (x7) = C1 C2 C3 C17 C20 C35 C38
C5 (x4) = C5 C10 C16 C18
I_AVCC = AD7606C AVCC (1 MSPS)
I_INA = 4 x INA241 IQ
(3 phases + DC bus)
+5VA : LTC6655-5 (IC7) reference buffered by LT3045-1 (IC8)
PGFB = IN : fast start-up and PG disabled
VIOC, PG open
C41 = AD7606C REFIN/REFOUT
I_REF = INA241 REF pins + REFIN (estimate)
+2.5VA : LTC6655-2.5 (IC3) reference buffered by LT3045-1 (IC9)
.tran 0 150m 0 20u
.param Iavcc=45m
.meas tran V5VA AVG V(+5VA) FROM 140m TO 150m
.meas tran V2V5A AVG V(+2.5VA) FROM 140m TO 150m
.meas tran VREF5 AVG V(REF5) FROM 140m TO 150m
.meas tran VREF2V5 AVG V(REF2V5) FROM 140m TO 150m
.meas tran I_R8 AVG I(R8) FROM 140m TO 150m
.meas tran I_R11 AVG I(R11) FROM 140m TO 150m
.meas tran T5_99 WHEN V(+5VA)=4.95 RISE=1
.meas tran T5_999 WHEN V(+5VA)=4.995 RISE=1
.meas tran I_6V AVG I(V_6V) FROM 140m TO 150m
