foukouda/OPEN_PHASE/Simulation/LTspice/04_Analog_Rails_PSRR.asc

C1: cap; 0.1u; m=7 Rser=20m
C5: cap; 1u; m=4 Rser=10m
C8: cap; 10u; Rser=5m
C12: cap; 10u; Rser=5m
C13: cap; 10u; Rser=5m
C14: cap; 10u; Rser=5m
C15: cap; 10u; Rser=5m
C19: cap; 10u; Rser=5m
C41: cap; 0.1u; Rser=20m
I_AVCC: current; {Iavcc}
I_INA: current; 10m
I_REF: current; 100u
IC3: LTC6655-2.5
IC7: LTC6655-5
IC8: LT3045-1
IC9: LT3045-1
R8: res; 1k
R11: res; 1k
R12: res; 24.9k
R14: res; 49.9k
V_6V: voltage; 5.96; AC 1; Rser=10m
Named nets: 0, REF5, SET5, +6V, +5VA, REF2V5, SET2V5, +2.5VA
OPEN_PHASE - 04 - PSRR of the analog rails : transfer from +6V ripple to +5VA and +2.5VA
PSRR(dB) = -20*log10|V(rail)/V(+6V)|. Includes the path through the LTC6655 references and the SET filters. 2 MHz = LT8362 switching frequency.
+6V with
1 V AC ripple
PGFB = IN : fast start-up and PG disabled
VIOC, PG open
C1 (x7) = C1 C2 C3 C17 C20 C35 C38
C5 (x4) = C5 C10 C16 C18
I_AVCC = AD7606C AVCC (1 MSPS)
I_INA = 4 x INA241 IQ
(3 phases + DC bus)
+5VA : LTC6655-5 (IC7) reference buffered by LT3045-1 (IC8)
PGFB = IN : fast start-up and PG disabled
VIOC, PG open
C41 = AD7606C REFIN/REFOUT
I_REF = INA241 REF pins + REFIN (estimate)
+2.5VA : LTC6655-2.5 (IC3) reference buffered by LT3045-1 (IC9)
.ac dec 50 10 10Meg
.param Iavcc=45m
.meas ac PSRR5_1k FIND mag(V(+5VA)) AT 1k
.meas ac PSRR5_100k FIND mag(V(+5VA)) AT 100k
.meas ac PSRR5_2M FIND mag(V(+5VA)) AT 2Meg
.meas ac PSRR2V5_1k FIND mag(V(+2.5VA)) AT 1k
.meas ac PSRR2V5_100k FIND mag(V(+2.5VA)) AT 100k
.meas ac PSRR2V5_2M FIND mag(V(+2.5VA)) AT 2Meg
