foukouda/OPEN_PHASE/OPEN_PHASE.kicad_pcb

## KiCad design OPEN_PHASE.kicad_pcb (2026-10-25)

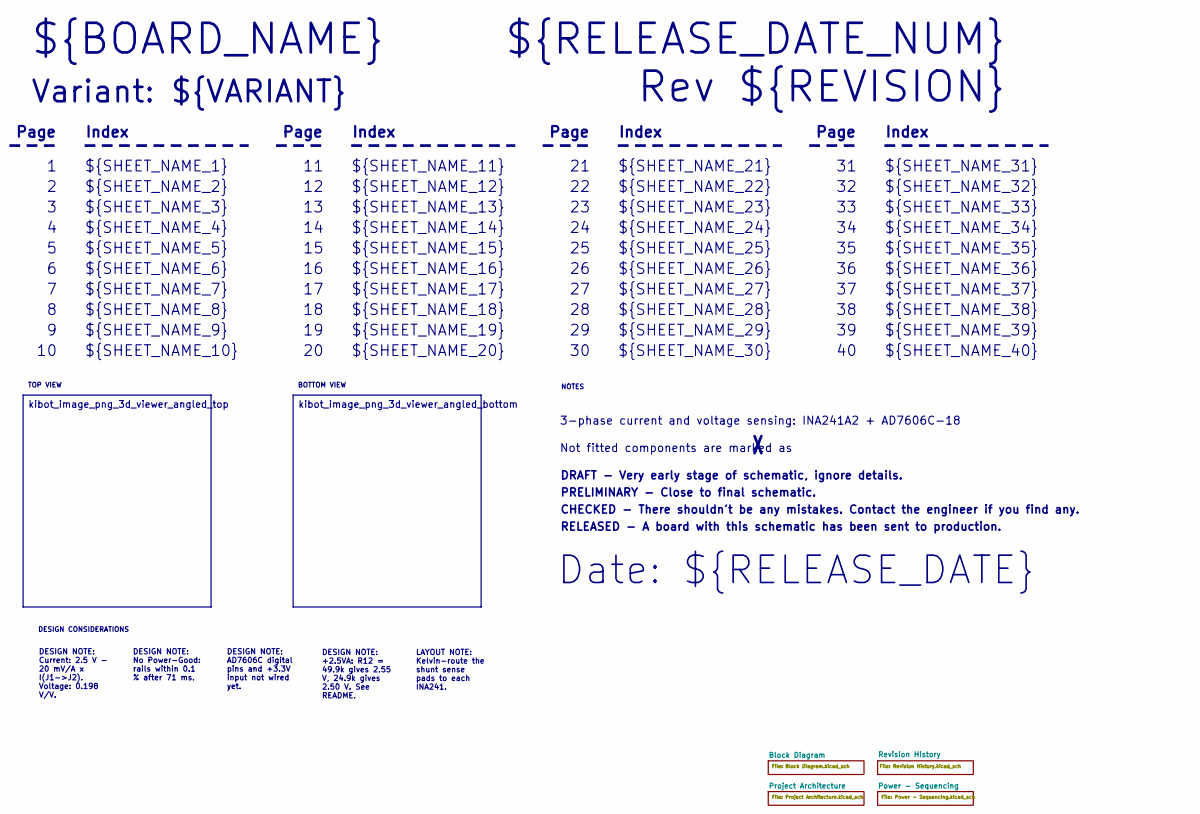
[picture p61: schematic OPEN_PHASE.kicad_sch, OPEN_PHASE - PHASETRACKER]

Notes on the sheet:
Variant: ${VARIANT}
RELEASED - A board with this schematic has been sent to production.
${SHEET_NAME_24}
Index
Page
PRELIMINARY - Close to final schematic.
${SHEET_NAME_22}
DRAFT - Very early stage of schematic, ignore details.
${SHEET_NAME_12}
${SHEET_NAME_8}
${SHEET_NAME_2}
${SHEET_NAME_5}
${SHEET_NAME_20}
${SHEET_NAME_23}
${RELEASE_DATE_NUM}
${SHEET_NAME_35}
Not fitted components are marked as
${SHEET_NAME_11}
${SHEET_NAME_6}
${SHEET_NAME_37}
${SHEET_NAME_26}
${SHEET_NAME_36}
Rev ${REVISION}
${SHEET_NAME_15}
CHECKED - There shouldn't be any mistakes. Contact the engineer if you find any.
${SHEET_NAME_14}
${SHEET_NAME_21}
${SHEET_NAME_17}
${SHEET_NAME_18}
Date: ${RELEASE_DATE}
${SHEET_NAME_7}
${SHEET_NAME_31}
${BOARD_NAME}
${SHEET_NAME_40}
${SHEET_NAME_39}
${SHEET_NAME_32}
${SHEET_NAME_1}
${SHEET_NAME_9}
${SHEET_NAME_38}
${SHEET_NAME_29}
${SHEET_NAME_34}
${SHEET_NAME_16}
${SHEET_NAME_3}
${SHEET_NAME_19}
3-phase current and voltage sensing: INA241A2 + AD7606C-18
${SHEET_NAME_10}
${SHEET_NAME_28}
${SHEET_NAME_13}
${SHEET_NAME_27}
${SHEET_NAME_4}
${SHEET_NAME_33}
${SHEET_NAME_30}
${SHEET_NAME_25}
TOP VIEW
BOTTOM VIEW
DESIGN NOTE: AD7606C digital pins and +3.3V input not wired yet.
DESIGN NOTE: No Power-Good: rails within 0.1 % after 71 ms.
DESIGN NOTE: +2.5VA: R12 = 49.9k gives 2.55 V, 24.9k gives 2.50 V. See README.
LAYOUT NOTE: Kelvin-route the shunt sense pads to each INA241.
kibot_image_png_3d_viewer_angled_bottom
NOTES
DESIGN NOTE: Current: 2.5 V - 20 mV/A x I(J1->J2). Voltage: 0.198 V/V.
kibot_image_png_3d_viewer_angled_top
DESIGN CONSIDERATIONS

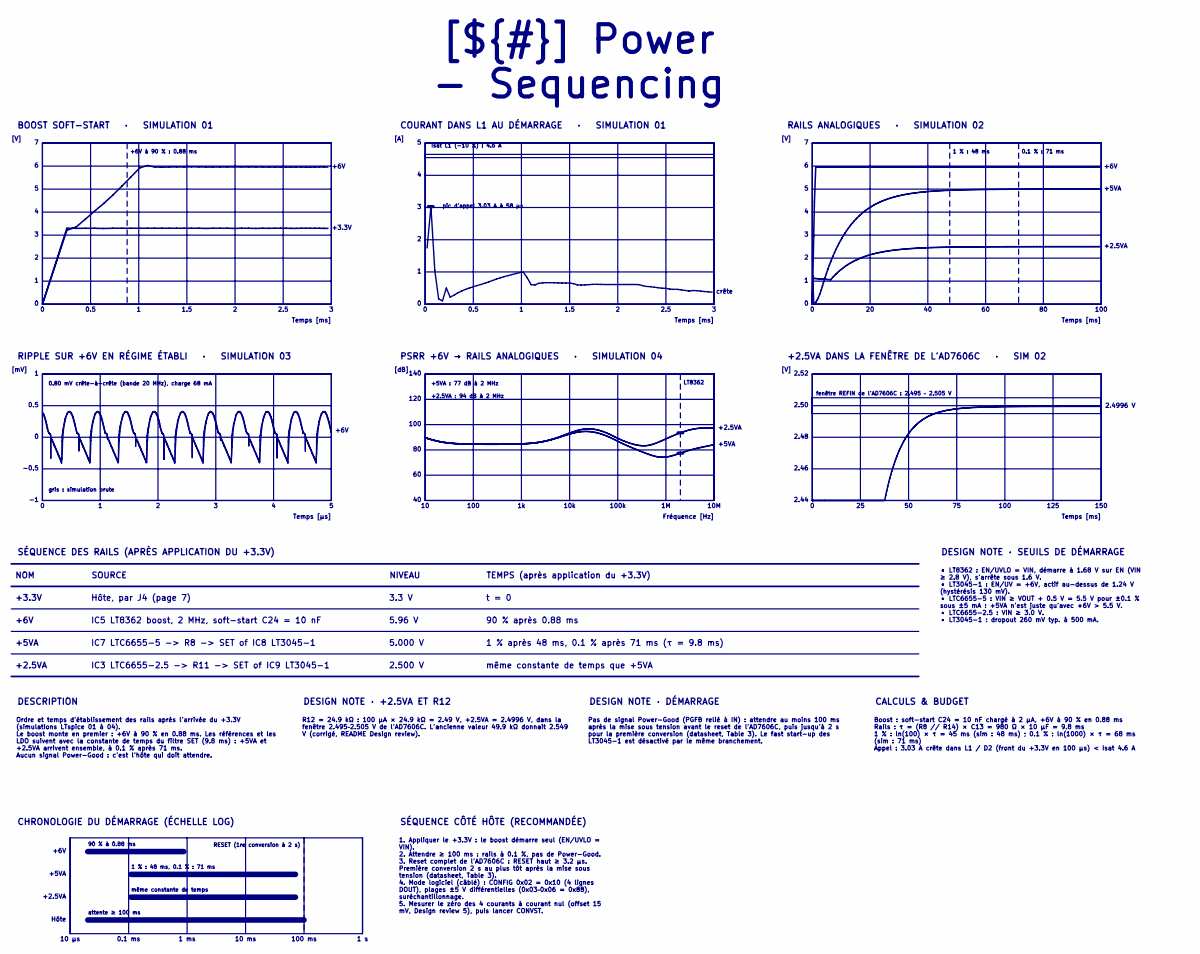
[picture p62: schematic Power - Sequencing.kicad_sch]

Notes on the sheet:
[A]
+6V
2.4996 V
gris : simulation brute
5.96 V
0.1 % : 71 ms
+2.5VA
attente ≥ 100 ms
même constante de temps
0.80 mV crête-à-crête (bande 20 MHz), charge 68 mA
0.5
150
100
2.5
2.46
t = 0
90 % à 0.88 ms
Isat L1 (−10 %) : 4.6 A
NIVEAU
+5VA
TEMPS (après application du +3.3V)
fenêtre REFIN de l'AD7606C : 2.495 – 2.505 V
10 µs
[V]
Temps [ms]
0.1 ms
100k
1 ms
Hôte
IC3 LTC6655-2.5 -> R11 -> SET of IC9 LT3045-1
1.5
125
crête
90 % après 0.88 ms
100 ms
+5VA : 77 dB à 2 MHz
SOURCE
3.3 V
2.44
2.500 V
-0.5
120
1 % après 48 ms, 0.1 % après 71 ms (τ = 9.8 ms)
+6V à 90 % : 0.88 ms
2.50
[dB]
Hôte, par J4 (page 7)
10k
IC7 LTC6655-5 -> R8 -> SET of IC8 LT3045-1
Fréquence [Hz]
+3.3V
pic d'appel 3.03 A à 58 µs
140
NOM
LT8362
10M
1 % : 48 ms, 0.1 % : 71 ms
[mV]
+2.5VA : 94 dB à 2 MHz
IC5 LT8362 boost, 2 MHz, soft-start C24 = 10 nF
1 s
RESET (1re conversion à 2 s)
5.000 V
même constante de temps que +5VA
Temps [µs]
1 % : 48 ms
10 ms
2.52
2.48
1. Appliquer le +3.3V : le boost démarre seul (EN/UVLO = VIN). 2. Attendre ≥ 100 ms : rails à 0.1 %, pas de Power-Good. 3. Reset complet de l'AD7606C : RESET haut ≥ 3.2 µs. Première conversion 2 s au plus tôt après la mise sous tension (datasheet, Table 3). 4. Mode logiciel (câblé) : CONFIG 0x02 = 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
CHRONOLOGIE DU DÉMARRAGE (ÉCHELLE LOG)
DESCRIPTION
R12 = 24.9 kΩ : 100 µA × 24.9 kΩ = 2.49 V, +2.5VA = 2.4996 V, dans la fenêtre 2.495–2.505 V de l'AD7606C. L'ancienne valeur 49.9 kΩ donnait 2.549 V (corrigé, README Design review).
RIPPLE SUR +6V EN RÉGIME ÉTABLI · SIMULATION 03
Pas de signal Power-Good (PGFB relié à IN) : attendre au moins 100 ms après la mise sous tension avant le reset de l'AD7606C, puis jusqu'à 2 s pour la première conversion (datasheet, Table 3). Le fast start-up des LT3045-1 est désactivé par le même branchement.
+2.5VA DANS LA FENÊTRE DE L'AD7606C · SIM 02
CALCULS & BUDGET
COURANT DANS L1 AU DÉMARRAGE · SIMULATION 01
DESIGN NOTE · DÉMARRAGE
[${#}] ${TITLE}
DESIGN NOTE · +2.5VA ET R12
BOOST SOFT-START · SIMULATION 01
Ordre et temps d'établissement des rails après l'arrivée du +3.3V (simulations LTspice 01 à 04). Le boost monte en premier : +6V à 90 % en 0.88 ms. Les références et les LDO suivent avec la constante de temps du filtre SET (9.8 ms) : +5VA et +2.5VA arrivent ensemble, à 0.1 % après 71 ms. Aucun sign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
RAILS ANALOGIQUES · SIMULATION 02
• LT8362 : EN/UVLO = VIN, démarre à 1.68 V sur EN (VIN ≥ 2.8 V), s'arrête sous 1.6 V. • LT3045-1 : EN/UV = +6V, actif au-dessus de 1.24 V (hystérésis 130 mV). • LTC6655-5 : VIN ≥ VOUT + 0.5 V = 5.5 V pour ±0.1 % sous ±5 mA : +5VA n'est juste qu'avec +6V > 5.5 V. • LTC6655-2.5 : VIN ≥ 3.0 V. • LT304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
SÉQUENCE DES RAILS (APRÈS APPLICATION DU +3.3V)
PSRR +6V → RAILS ANALOGIQUES · SIMULATION 04
SÉQUENCE CÔTÉ HÔTE (RECOMMANDÉE)
Boost : soft-start C24 = 10 nF chargé à 2 µA, +6V à 90 % en 0.88 ms Rails : τ = (R8 // R14) × C13 = 980 Ω × 10 µF = 9.8 ms 1 % : ln(100) × τ = 45 ms (sim : 48 ms) ; 0.1 % : ln(1000) × τ = 68 ms (sim : 71 ms) Appel : 3.03 A crête dans L1 / D2 (front du +3.3V en 100 µs) < Isat 4.6 A
DESIGN NOTE · SEUILS DE DÉMARRAGE

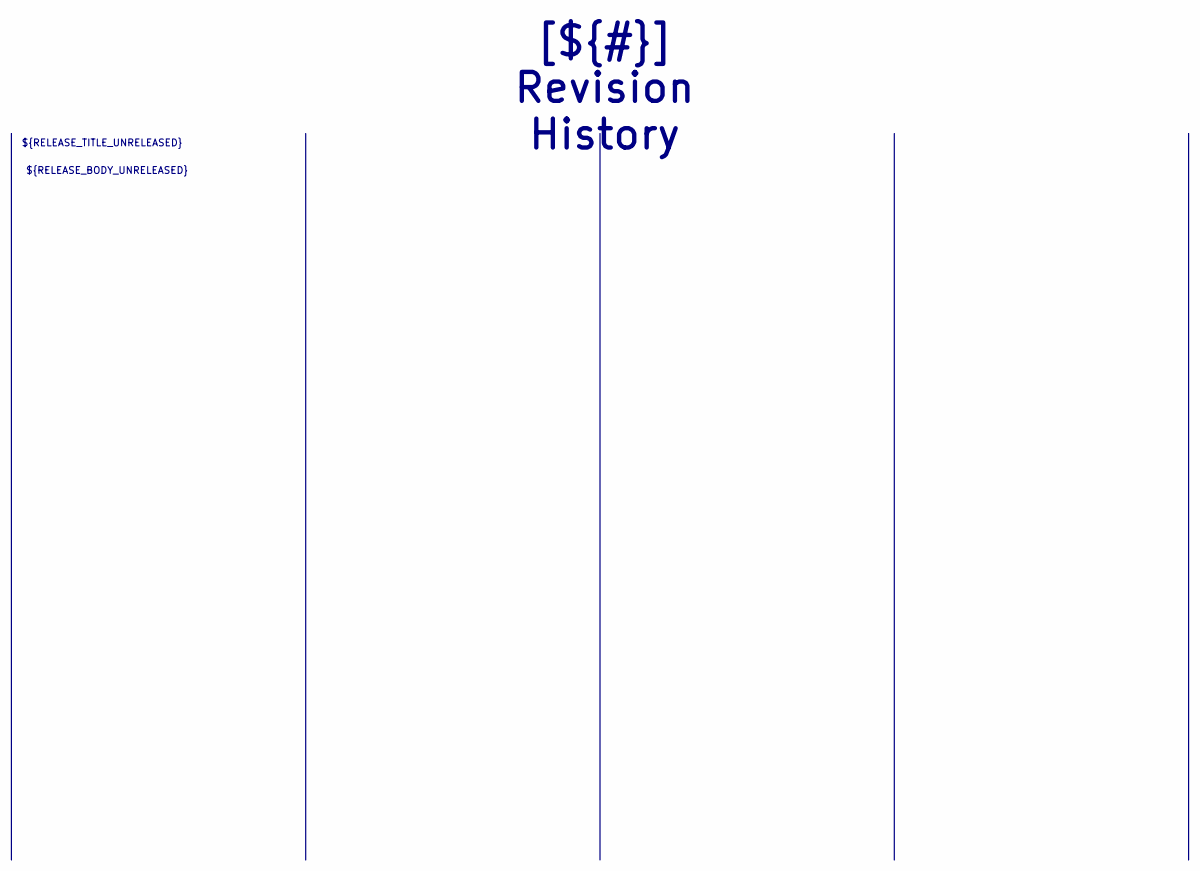
[picture p63: schematic Revision History.kicad_sch]

Notes on the sheet:
[${#}] ${TITLE}
${RELEASE_BODY_UNRELEASED}
${RELEASE_TITLE_UNRELEASED}

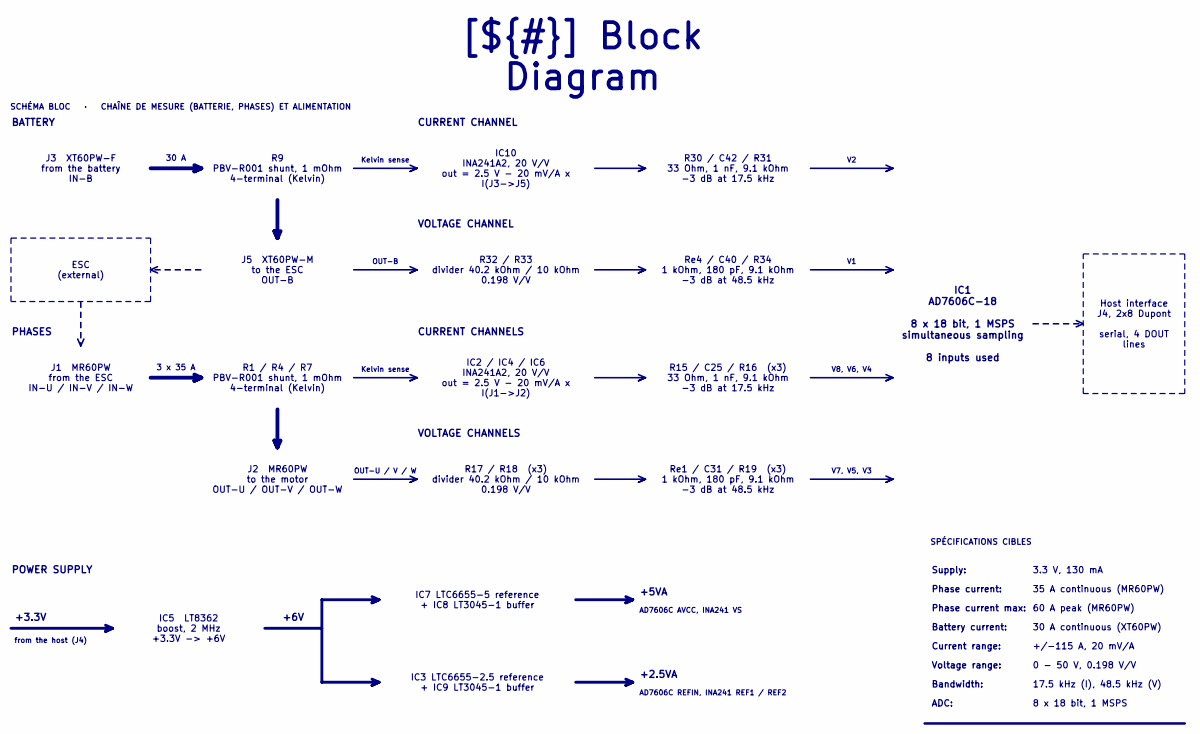
[picture p64: schematic Block Diagram.kicad_sch]

Notes on the sheet:
Supply:
+2.5VA
+5VA
Kelvin sense
VOLTAGE CHANNEL
CURRENT CHANNELS
CURRENT CHANNEL
Phase current max:
30 A continuous (XT60PW)
Voltage range:
8 x 18 bit, 1 MSPS
Current range:
35 A continuous (MR60PW)
3.3 V, 130 mA
17.5 kHz (I), 48.5 kHz (V)
Battery current:
+3.3V
ADC:
Bandwidth:
Phase current:
+6V
VOLTAGE CHANNELS
PHASES
V7, V5, V3
3 x 35 A
V8, V6, V4
BATTERY
AD7606C REFIN, INA241 REF1 / REF2
+/-115 A, 20 mV/A
OUT-U / V / W
30 A
POWER SUPPLY
0 - 50 V, 0.198 V/V
AD7606C AVCC, INA241 VS
OUT-B
from the host (J4)
60 A peak (MR60PW)
R32 / R33 divider 40.2 kOhm / 10 kOhm 0.198 V/V
R9 PBV-R001 shunt, 1 mOhm 4-terminal (Kelvin)
Re1 / C31 / R19 (x3) 1 kOhm, 180 pF, 9.1 kOhm -3 dB at 48.5 kHz
Re4 / C40 / R34 1 kOhm, 180 pF, 9.1 kOhm -3 dB at 48.5 kHz
IC5 LT8362 boost, 2 MHz +3.3V -> +6V
IC7 LTC6655-5 reference + IC8 LT3045-1 buffer
IC3 LTC6655-2.5 reference + IC9 LT3045-1 buffer
[${#}] ${TITLE}
IC2 / IC4 / IC6 INA241A2, 20 V/V out = 2.5 V - 20 mV/A x I(J1->J2)
J5 XT60PW-M to the ESC OUT-B
Host interface J4, 2x8 Dupont serial, 4 DOUT lines
R17 / R18 (x3) divider 40.2 kOhm / 10 kOhm 0.198 V/V
IC10 INA241A2, 20 V/V out = 2.5 V - 20 mV/A x I(J3->J5)
J2 MR60PW to the motor OUT-U / OUT-V / OUT-W
R15 / C25 / R16 (x3) 33 Ohm, 1 nF, 9.1 kOhm -3 dB at 17.5 kHz
SCHÉMA BLOC · CHAÎNE DE MESURE (BATTERIE, PHASES) ET ALIMENTATION
R30 / C42 / R31 33 Ohm, 1 nF, 9.1 kOhm -3 dB at 17.5 kHz
IC1 AD7606C-18 8 x 18 bit, 1 MSPS simultaneous sampling 8 inputs used
J1 MR60PW from the ESC IN-U / IN-V / IN-W
J3 XT60PW-F from the battery IN-B
R1 / R4 / R7 PBV-R001 shunt, 1 mOhm 4-terminal (Kelvin)
SPÉCIFICATIONS CIBLES
ESC (external)

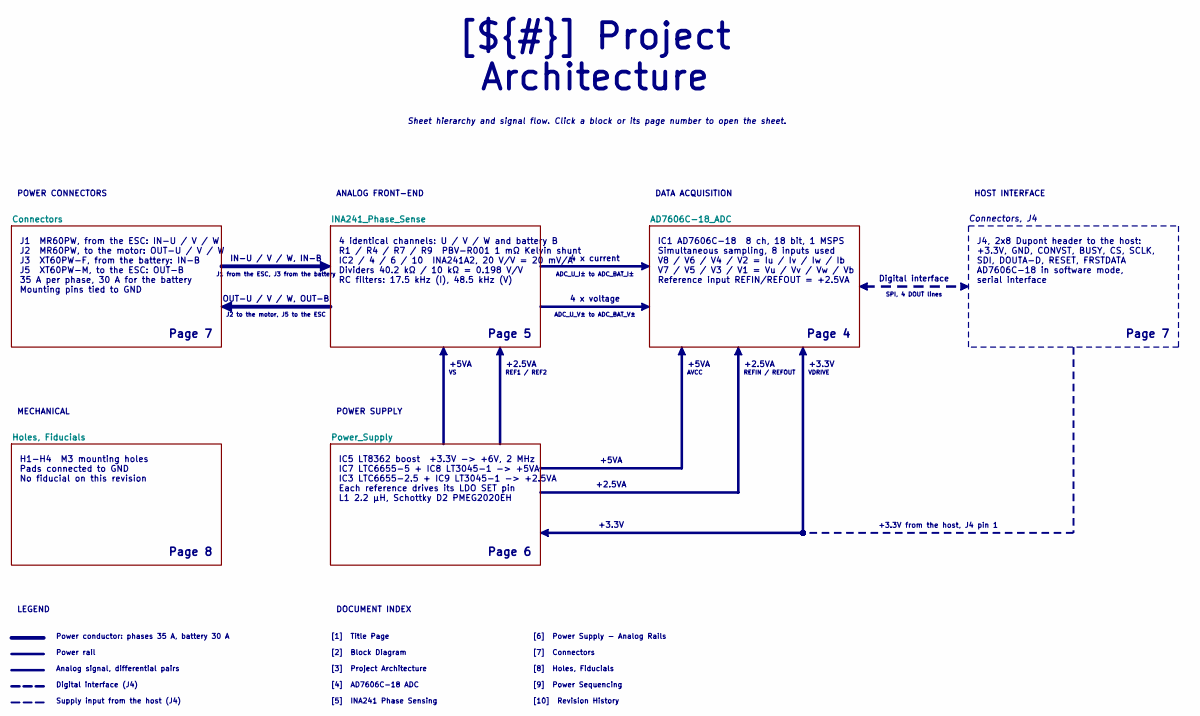
[picture p65: schematic Project Architecture.kicad_sch]

Notes on the sheet:
+3.3V
IC5 LT8362 boost +3.3V -> +6V, 2 MHz IC7 LTC6655-5 + IC8 LT3045-1 -> +5VA IC3 LTC6655-2.5 + IC9 LT3045-1 -> +2.5VA Each reference drives its LDO SET pin L1 2.2 µH, Schottky D2 PMEG2020EH
SPI, 4 DOUT lines
4 x current
ADC_U_V± to ADC_BAT_V±
AVCC
ADC_U_I± to ADC_BAT_I±
+5VA
Digital interface
[10] Revision History
[3] Project Architecture
Sheet hierarchy and signal flow. Click a block or its page number to open the sheet.
+3.3V from the host, J4 pin 1
Page 8
+2.5VA
Analog signal, differential pairs
[2] Block Diagram
[4] AD7606C-18 ADC
Supply input from the host (J4)
Page 4
Page 7
[1] Title Page
J1 from the ESC, J3 from the battery
[8] Holes, Fiducials
H1-H4 M3 mounting holes Pads connected to GND No fiducial on this revision
Digital interface (J4)
Connectors, J4
Power rail
Power conductor: phases 35 A, battery 30 A
Page 5
[9] Power Sequencing
IC1 AD7606C-18 8 ch, 18 bit, 1 MSPS Simultaneous sampling, 8 inputs used V8 / V6 / V4 / V2 = Iu / Iv / Iw / Ib V7 / V5 / V3 / V1 = Vu / Vv / Vw / Vb Reference input REFIN/REFOUT = +2.5VA
J2 to the motor, J5 to the ESC
4 x voltage
[7] Connectors
REFIN / REFOUT
Page 6
IN-U / V / W, IN-B
VDRIVE
[6] Power Supply - Analog Rails
J1 MR60PW, from the ESC: IN-U / V / W J2 MR60PW, to the motor: OUT-U / V / W J3 XT60PW-F, from the battery: IN-B J5 XT60PW-M, to the ESC: OUT-B 35 A per phase, 30 A for the battery Mounting pins tied to GND
REF1 / REF2
OUT-U / V / W, OUT-B
[5] INA241 Phase Sensing
4 identical channels: U / V / W and battery B R1 / R4 / R7 / R9 PBV-R001 1 mΩ Kelvin shunt IC2 / 4 / 6 / 10 INA241A2, 20 V/V = 20 mV/A Dividers 40.2 kΩ / 10 kΩ = 0.198 V/V RC filters: 17.5 kHz (I), 48.5 kHz (V)
J4, 2x8 Dupont header to the host: +3.3V, GND, CONVST, BUSY, CS, SCLK, SDI, DOUTA-D, RESET, FRSTDATA AD7606C-18 in software mode, serial interface
DATA ACQUISITION
LEGEND
MECHANICAL
ANALOG FRONT-END
POWER SUPPLY
POWER CONNECTORS
DOCUMENT INDEX
HOST INTERFACE
[${#}] ${TITLE}

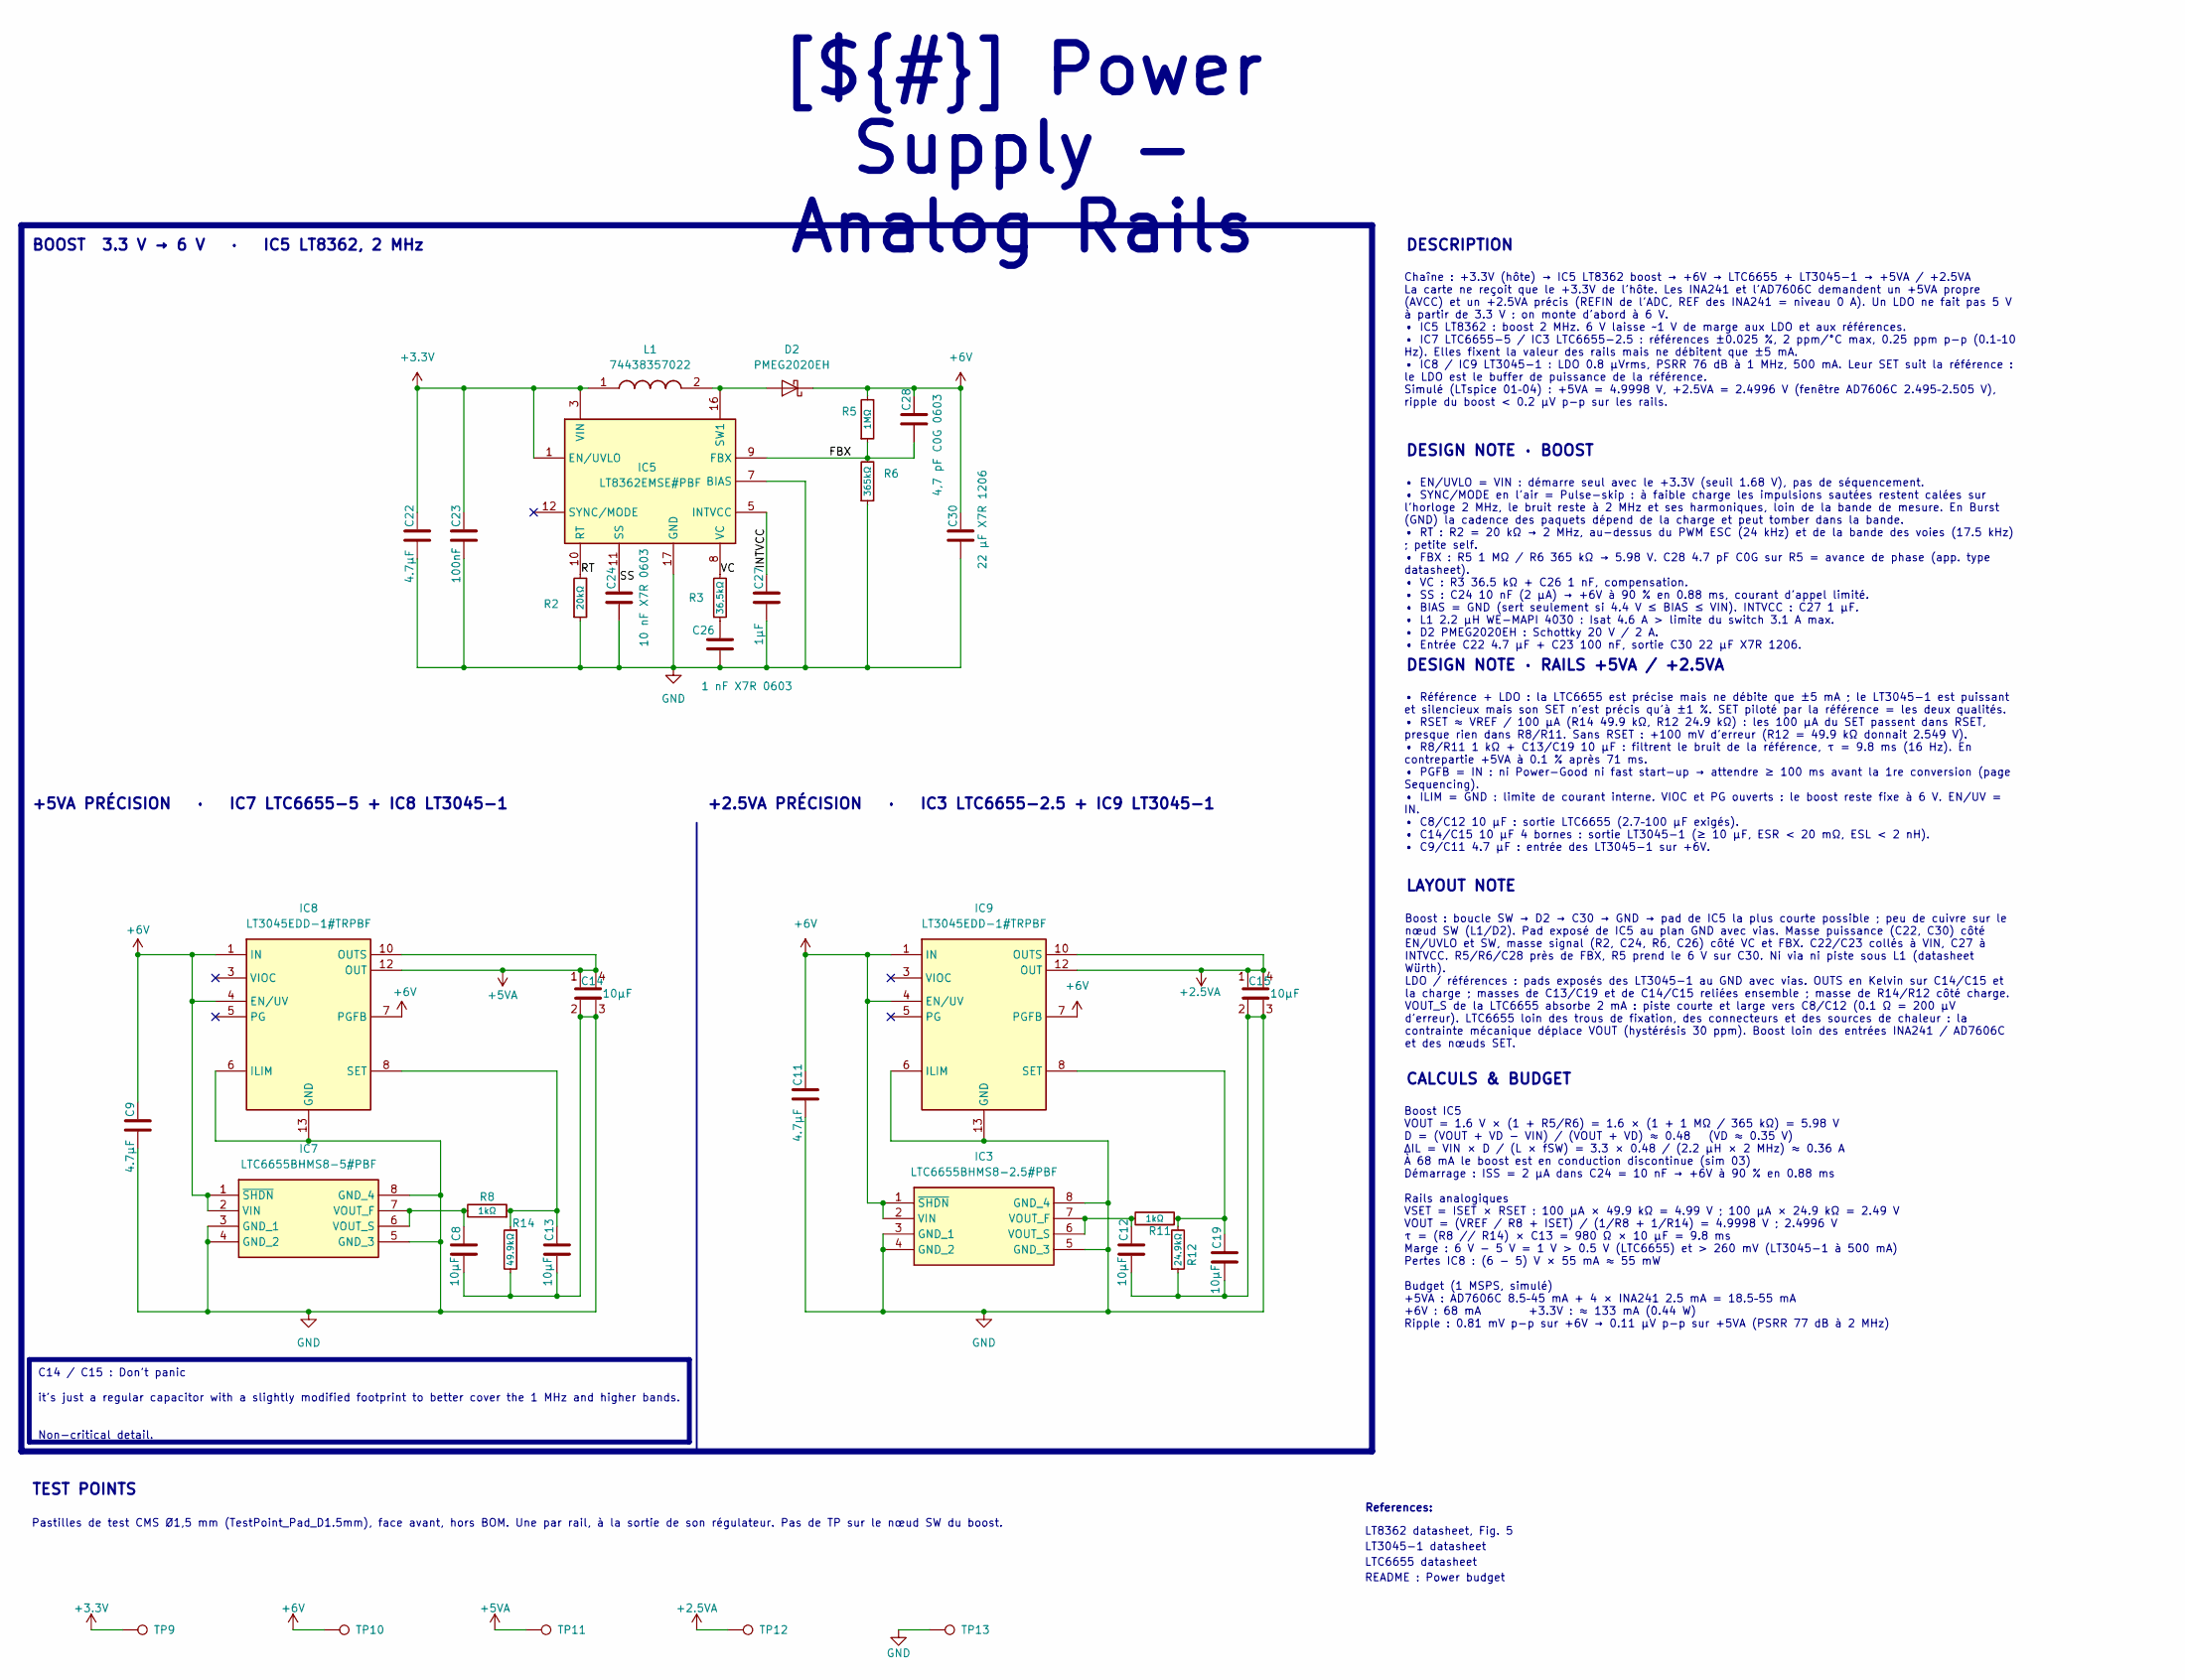
[picture p66: schematic Power Supply - Analog Rails.kicad_sch]

Parts:
C8, C12: 10µF; C_0603_1608Metric
C9, C11, C22: 4.7µF; C_0603_1608Metric
C13, C14, C15, C19: 10µF; C_0805_2012Metric
C23: 100nF; C_0603_1608Metric
C24: 10 nF X7R 0603; C_0603_1608Metric
C26: 1 nF X7R 0603; C_0603_1608Metric
C27: 1µF; C_0603_1608Metric
C28: 4,7 pF C0G 0603; C_0603_1608Metric
C30: 22 µF X7R 1206; C_1206_3216Metric_Pad1.33x1.80mm_HandSolder
D2: PMEG2020EH; D_SOD-123F
IC3: LTC6655BHMS8-2.5#PBF; SOP65P490X110-8N; Manufacturer_Part_Number LTC6655BHMS8-2.5#PBF
IC5: LT8362EMSE#PBF; LT8362EMSEPBF; Manufacturer_Part_Number LT8362EMSE#PBF; Mouser Part Number 584-LT8362EMSEPBF
IC7: LTC6655BHMS8-5#PBF; SOP65P490X110-8N; Manufacturer_Part_Number LTC6655BHMS8-5#PBF; Mouser Part Number 584-C6655BHMS8-5PBF
IC8, IC9: LT3045EDD-1#TRPBF; SON45P300X300X80-13N-D; Manufacturer_Part_Number LT3045EDD-1#TRPBF; Mouser Part Number 584-LT3045EDD-1TRPBF
L1: 74438357022; L_Wuerth_MAPI-4030; Manufacturer_Part_Number 74438357022; Mouser Part Number 710-74438357022
R2: 20kΩ; R_0603_1608Metric
R3: 36,5kΩ; R_0603_1608Metric
R5: 1MΩ; R_0603_1608Metric
R6: 365kΩ; R_0603_1608Metric
R8, R11: 1kΩ; R_0603_1608Metric
R12: 24.9kΩ; R_0603_1608Metric
R14: 49.9kΩ; R_0603_1608Metric
TP9, TP10, TP11, TP12, TP13: TestPoint; TestPoint_Pad_D1.5mm

Connections:
+2.5VA: C15.1, C15.4, IC9.10 (OUTS), IC9.11 (OUT_2), IC9.12 (OUT), TP12.1 (1_1); also elsewhere on the board
+3.3V: C22.1, C23.1, IC5.1 (EN/UVLO), IC5.3 (VIN), L1.1, TP9.1 (1_1); also elsewhere on the board
+5VA: C14.1, C14.4, IC8.10 (OUTS), IC8.11 (OUT_2), IC8.12 (OUT), TP11.1 (1_1); also elsewhere on the board
+6V: C9.1, C11.1, C28.1, C30.1, D2.1 (K), IC3.1 (~SHDN), IC3.2 (VIN), IC7.1 (~SHDN), IC7.2 (VIN), IC8.1 (IN), IC8.2 (IN_2), IC8.4 (EN/UV), IC8.7 (PGFB), IC9.1 (IN), IC9.2 (IN_2), IC9.4 (EN/UV), IC9.7 (PGFB), R5.1, TP10.1 (1_1); also elsewhere on the board
/Project Architecture/Power_Supply/FBX: C28.2, IC5.9 (FBX), R5.2, R6.1
/Project Architecture/Power_Supply/INTVCC: C27.1, IC5.5 (INTVCC)
/Project Architecture/Power_Supply/RT: IC5.10 (RT), R2.1
/Project Architecture/Power_Supply/VC: IC5.8 (VC), R3.1
GND: C8.2, C9.2, C11.2, C12.2, C13.2, C14.2, C14.3, C15.2, C15.3, C19.2, C22.2, C23.2, C24.2, C26.1, C27.2, C30.2, IC3.3 (GND_1), IC3.4 (GND_2), IC3.5 (GND_3), IC3.8 (GND_4), IC5.7 (BIAS), IC5.17 (GND), IC7.3 (GND_1), IC7.4 (GND_2), IC7.5 (GND_3), IC7.8 (GND_4), IC8.6 (ILIM), IC8.9 (GND_1), IC8.13 (GND), IC9.6 (ILIM), IC9.9 (GND_1), IC9.13 (GND), R2.2, R6.2, R12.2, R14.1, TP13.1; also elsewhere on the board
unnamed: C26.2, R3.2
unnamed: D2.2 (A), IC5.14 (SW2), IC5.16 (SW1), L1.2
unnamed: C12.1, IC3.6 (VOUT_S), IC3.7 (VOUT_F), R11.1
unnamed: C24.1, IC5.11 (SS)
unnamed: C8.1, IC7.6 (VOUT_S), IC7.7 (VOUT_F), R8.1
unnamed: C13.1, IC8.8 (SET), R8.2, R14.2
unnamed: C19.1, IC9.8 (SET), R11.2, R12.1

Notes on the sheet:
README : Power budget
LT3045-1 datasheet
References:
LT8362 datasheet, Fig. 5
LTC6655 datasheet
• Référence + LDO : la LTC6655 est précise mais ne débite que ±5 mA ; le LT3045-1 est puissant et silencieux mais son SET n'est précis qu'à ±1 %. SET piloté par la référence = les deux qualités. • RSET ≈ VREF / 100 µA (R14 49.9 kΩ, R12 24.9 kΩ) : les 100 µA du SET passent dans RSET, presque rien da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
Boost IC5 VOUT = 1.6 V × (1 + R5/R6) = 1.6 × (1 + 1 MΩ / 365 kΩ) = 5.98 V D = (VOUT + VD − VIN) / (VOUT + VD) ≈ 0.48 (VD ≈ 0.35 V) ΔIL = VIN × D / (L × fSW) = 3.3 × 0.48 / (2.2 µH × 2 MHz) ≈ 0.36 A À 68 mA le boost est en conduction discontinue (sim 03) Démarrage : ISS = 2 µA dans C24 = 10 nF → +6V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
[${#}] ${TITLE}
Boost : boucle SW → D2 → C30 → GND → pad de IC5 la plus courte possible ; peu de cuivre sur le nœud SW (L1/D2). Pad exposé de IC5 au plan GND avec vias. Masse puissance (C22, C30) côté EN/UVLO et SW, masse signal (R2, C24, R6, C26) côté VC et FBX. C22/C23 collés à VIN, C27 à INTVCC. R5/R6/C28 près 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
C14 / C15 : Don't panic it's just a regular capacitor with a slightly modified footprint to better cover the 1 MHz and higher bands. Non-critical detail.
DESIGN NOTE · BOOST
BOOST 3.3 V → 6 V · IC5 LT8362, 2 MHz
+2.5VA PRÉCISION · IC3 LTC6655-2.5 + IC9 LT3045-1
LAYOUT NOTE
TEST POINTS
CALCULS & BUDGET
DESCRIPTION
Pastilles de test CMS Ø1,5 mm (TestPoint_Pad_D1.5mm), face avant, hors BOM. Une par rail, à la sortie de son régulateur. Pas de TP sur le nœud SW du boost.
• EN/UVLO = VIN : démarre seul avec le +3.3V (seuil 1.68 V), pas de séquencement. • SYNC/MODE en l'air = Pulse-skip : à faible charge les impulsions sautées restent calées sur l'horloge 2 MHz, le bruit reste à 2 MHz et ses harmoniques, loin de la bande de mesure. En Burst (GND) la cadence des paque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
Chaîne : +3.3V (hôte) → IC5 LT8362 boost → +6V → LTC6655 + LT3045-1 → +5VA / +2.5VA La carte ne reçoit que le +3.3V de l'hôte. Les INA241 et l'AD7606C demandent un +5VA propre (AVCC) et un +2.5VA précis (REFIN de l'ADC, REF des INA241 = niveau 0 A). Un LDO ne fait pas 5 V à partir de 3.3 V : on mon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
+5VA PRÉCISION · IC7 LTC6655-5 + IC8 LT3045-1
DESIGN NOTE · RAILS +5VA / +2.5VA

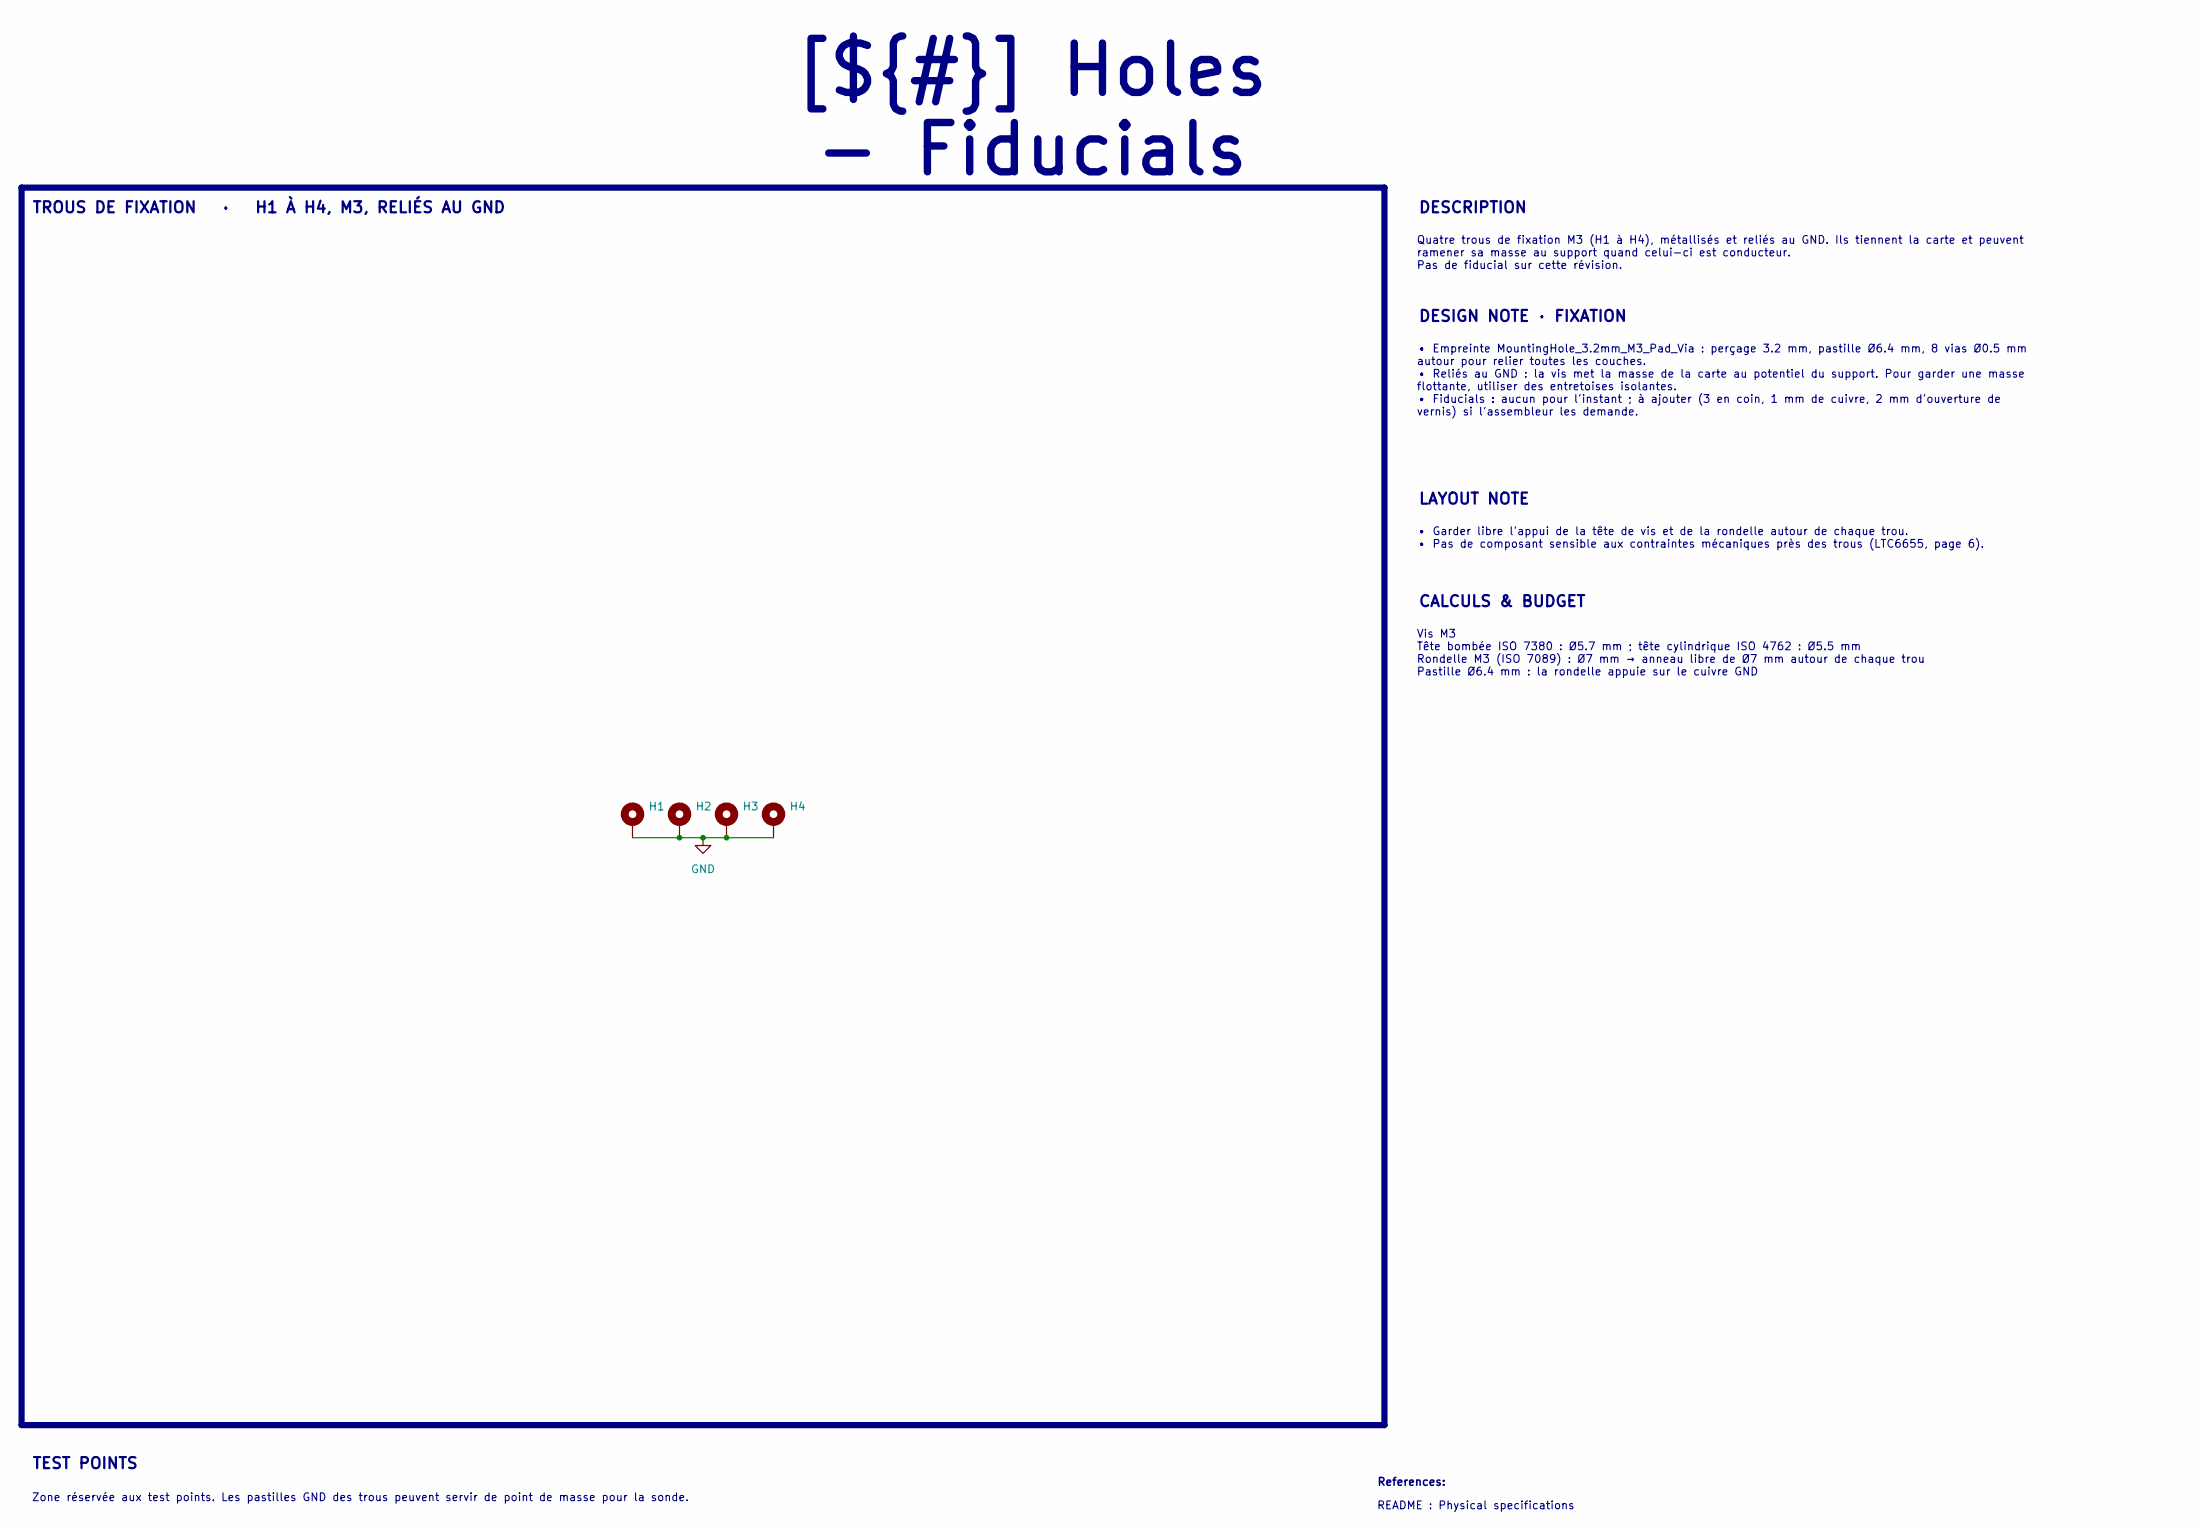
[picture p67: schematic Holes - Fiducials.kicad_sch]

Parts:
H1, H2, H3, H4: MountingHole_Pad; MountingHole_3.2mm_M3_Pad_Via

Connections:
GND: H1.1 (1_1), H2.1 (1_1), H3.1 (1_1), H4.1 (1_1); also elsewhere on the board

Notes on the sheet:
References:
README : Physical specifications
TEST POINTS
CALCULS & BUDGET
Quatre trous de fixation M3 (H1 à H4), métallisés et reliés au GND. Ils tiennent la carte et peuvent ramener sa masse au support quand celui-ci est conducteur. Pas de fiducial sur cette révision.
DESCRIPTION
TROUS DE FIXATION · H1 À H4, M3, RELIÉS AU GND
[${#}] ${TITLE}
LAYOUT NOTE
DESIGN NOTE · FIXATION
Vis M3 Tête bombée ISO 7380 : Ø5.7 mm ; tête cylindrique ISO 4762 : Ø5.5 mm Rondelle M3 (ISO 7089) : Ø7 mm → anneau libre de Ø7 mm autour de chaque trou Pastille Ø6.4 mm : la rondelle appuie sur le cuivre GND
• Empreinte MountingHole_3.2mm_M3_Pad_Via : perçage 3.2 mm, pastille Ø6.4 mm, 8 vias Ø0.5 mm autour pour relier toutes les couches. • Reliés au GND : la vis met la masse de la carte au potentiel du support. Pour garder une masse flottante, utiliser des entretoises isolantes. • Fiducials : aucun pou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
Zone réservée aux test points. Les pastilles GND des trous peuvent servir de point de masse pour la sonde.
• Garder libre l'appui de la tête de vis et de la rondelle autour de chaque trou. • Pas de composant sensible aux contraintes mécaniques près des trous (LTC6655, page 6).
