foukouda/OPEN_PHASE/OPEN_PHASE.kicad_pcb

## KiCad design OPEN_PHASE.kicad_pcb (continued)

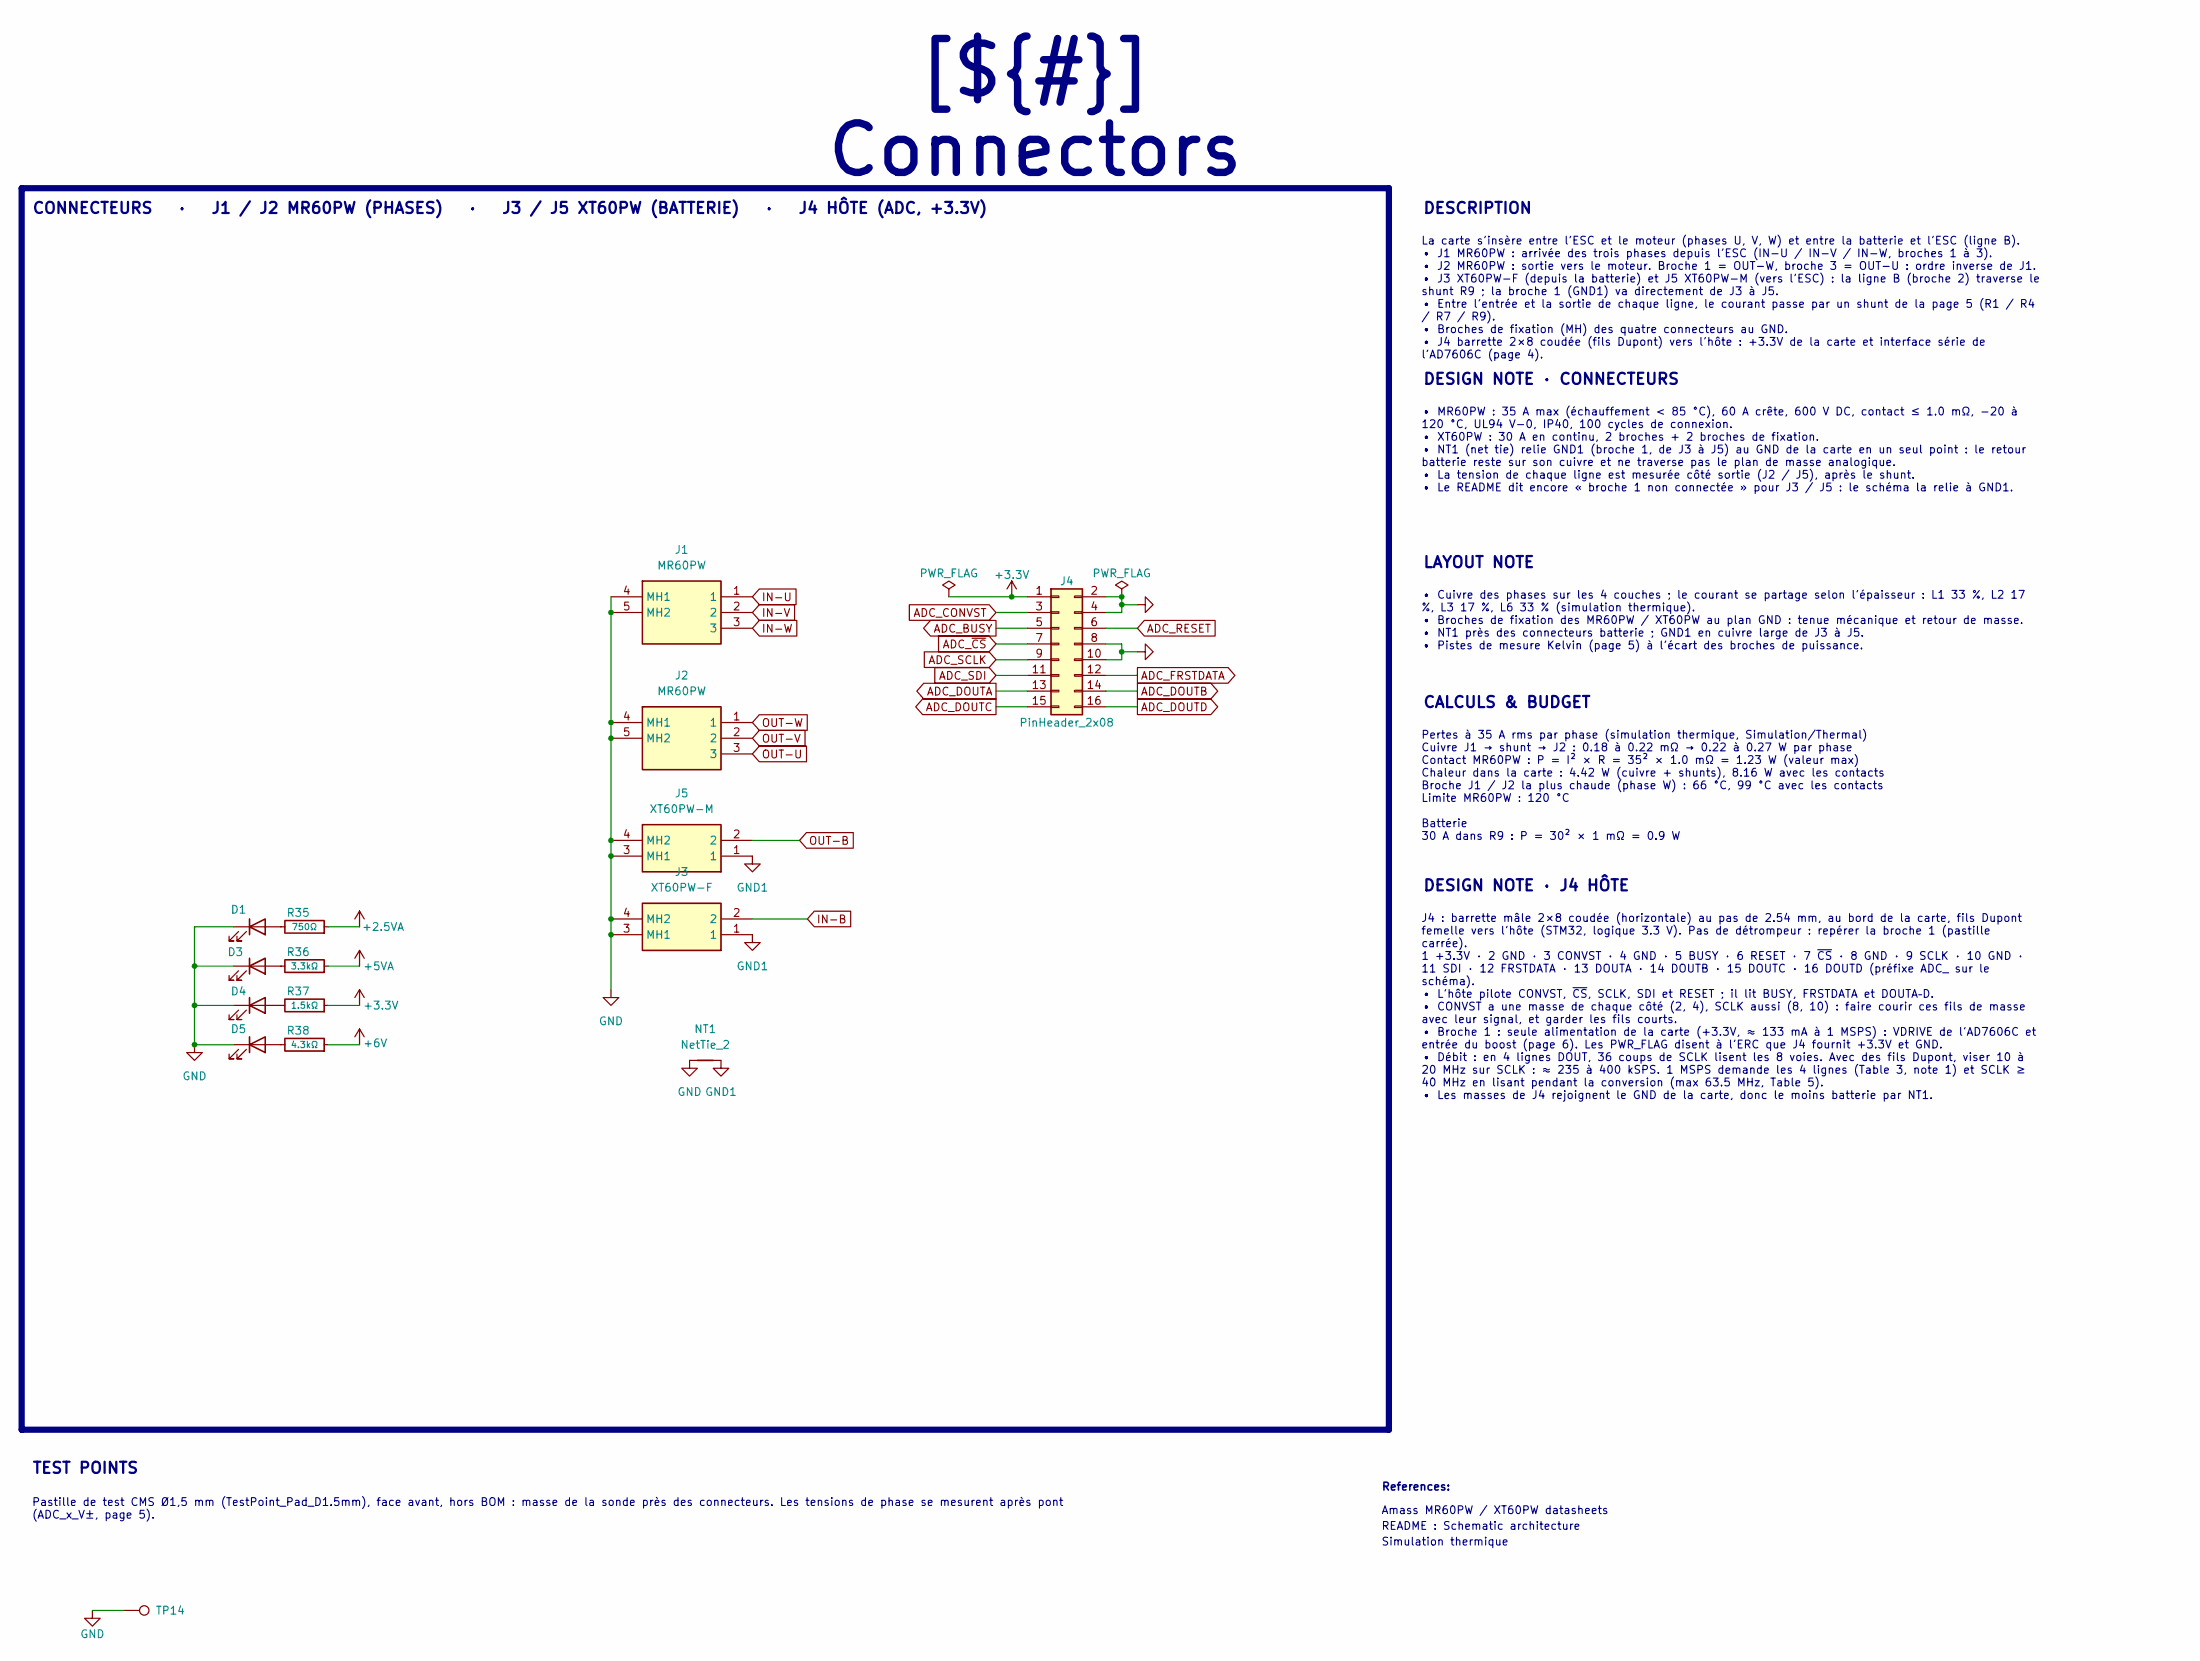
[picture p68: schematic Connectors.kicad_sch]

Parts:
D1, D3, D4, D5: LED; LED_0603_1608Metric
J1, J2: MR60PW; Manufacturer_Part_Number MR60PW
J3: XT60PW-F; AMASS_XT60PW-F_1x02_P7.20mm_Horizontal; Manufacturer_Part_Number XT60PW-F
J4: PinHeader_2x08; PinHeader_2x08_P2.54mm_Horizontal
J5: XT60PW-M; XT60PWM; Manufacturer_Part_Number XT60PW-M
NT1: NetTie_2; NetTie-2_SMD_Pad0.5mm
R35: 750Ω; R_0603_1608Metric
R36: 3.3kΩ; R_0603_1608Metric
R37: 1.5kΩ; R_0603_1608Metric
R38: 4.3kΩ; R_0603_1608Metric
TP14: TestPoint; TestPoint_Pad_D1.5mm

Connections:
+2.5VA: R35.2; also elsewhere on the board
+3.3V: J4.1, R37.2; also elsewhere on the board
+5VA: R36.2; also elsewhere on the board
+6V: R38.2; also elsewhere on the board
ADC_BUSY: J4.5; also elsewhere on the board
ADC_CONVST: J4.3; also elsewhere on the board
ADC_DOUTA: J4.13; also elsewhere on the board
ADC_DOUTB: J4.14; also elsewhere on the board
ADC_DOUTC: J4.15; also elsewhere on the board
ADC_DOUTD: J4.16; also elsewhere on the board
ADC_FRSTDATA: J4.12; also elsewhere on the board
ADC_RESET: J4.6; also elsewhere on the board
ADC_SCLK: J4.9; also elsewhere on the board
ADC_SDI: J4.11; also elsewhere on the board
ADC_~CS: J4.7; also elsewhere on the board
GND: D1.1 (K), D3.1 (K), D4.1 (K), D5.1 (K), J1.4 (MH1), J1.5 (MH2), J2.4 (MH1), J2.5 (MH2), J3.3 (MH1), J3.4 (MH2), J4.2, J4.4, J4.8, J4.10, J5.3 (MH1), J5.4 (MH2), NT1.1, TP14.1; also elsewhere on the board
GND1: J3.1, J5.1, NT1.2
IN-B: J3.2; also elsewhere on the board
IN-U: J1.1; also elsewhere on the board
IN-V: J1.2; also elsewhere on the board
IN-W: J1.3; also elsewhere on the board
unnamed: D1.2 (A), R35.1
unnamed: D3.2 (A), R36.1
unnamed: D4.2 (A), R37.1
unnamed: D5.2 (A), R38.1
OUT-B: J5.2; also elsewhere on the board
OUT-U: J2.3; also elsewhere on the board
OUT-V: J2.2; also elsewhere on the board
OUT-W: J2.1; also elsewhere on the board

Notes on the sheet:
Amass MR60PW / XT60PW datasheets
References:
README : Schematic architecture
Simulation thermique
Pastille de test CMS Ø1,5 mm (TestPoint_Pad_D1.5mm), face avant, hors BOM : masse de la sonde près des connecteurs. Les tensions de phase se mesurent après pont (ADC_x_V±, page 5).
CALCULS & BUDGET
LAYOUT NOTE
DESCRIPTION
J4 : barrette mâle 2×8 coudée (horizontale) au pas de 2.54 mm, au bord de la carte, fils Dupont femelle vers l'hôte (STM32, logique 3.3 V). Pas de détrompeur : repérer la broche 1 (pastille carrée). 1 +3.3V · 2 GND · 3 CONVST · 4 GND · 5 BUSY · 6 RESET · 7 ~{CS} · 8 GND · 9 SCLK · 10 GND · 11 SDI ·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
TEST POINTS
[${#}] ${TITLE}
DESIGN NOTE · J4 HÔTE
• Cuivre des phases sur les 4 couches ; le courant se partage selon l'épaisseur : L1 33 %, L2 17 %, L3 17 %, L6 33 % (simulation thermique). • Broches de fixation des MR60PW / XT60PW au plan GND : tenue mécanique et retour de masse. • NT1 près des connecteurs batterie ; GND1 en cuivre large de J3 à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
Pertes à 35 A rms par phase (simulation thermique, Simulation/Thermal) Cuivre J1 → shunt → J2 : 0.18 à 0.22 mΩ → 0.22 à 0.27 W par phase Contact MR60PW : P = I² × R = 35² × 1.0 mΩ = 1.23 W (valeur max) Chaleur dans la carte : 4.42 W (cuivre + shunts), 8.16 W avec les contacts Broche J1 / J2 la plus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
La carte s'insère entre l'ESC et le moteur (phases U, V, W) et entre la batterie et l'ESC (ligne B). • J1 MR60PW : arrivée des trois phases depuis l'ESC (IN-U / IN-V / IN-W, broches 1 à 3). • J2 MR60PW : sortie vers le moteur. Broche 1 = OUT-W, broche 3 = OUT-U : ordre inverse de J1. • J3 XT60PW-F 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
DESIGN NOTE · CONNECTEURS
CONNECTEURS · J1 / J2 MR60PW (PHASES) · J3 / J5 XT60PW (BATTERIE) · J4 HÔTE (ADC, +3.3V)
• MR60PW : 35 A max (échauffement < 85 °C), 60 A crête, 600 V DC, contact ≤ 1.0 mΩ, −20 à 120 °C, UL94 V-0, IP40, 100 cycles de connexion. • XT60PW : 30 A en continu, 2 broches + 2 broches de fixation. • NT1 (net tie) relie GND1 (broche 1, de J3 à J5) au GND de la carte en un seul point : le retour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

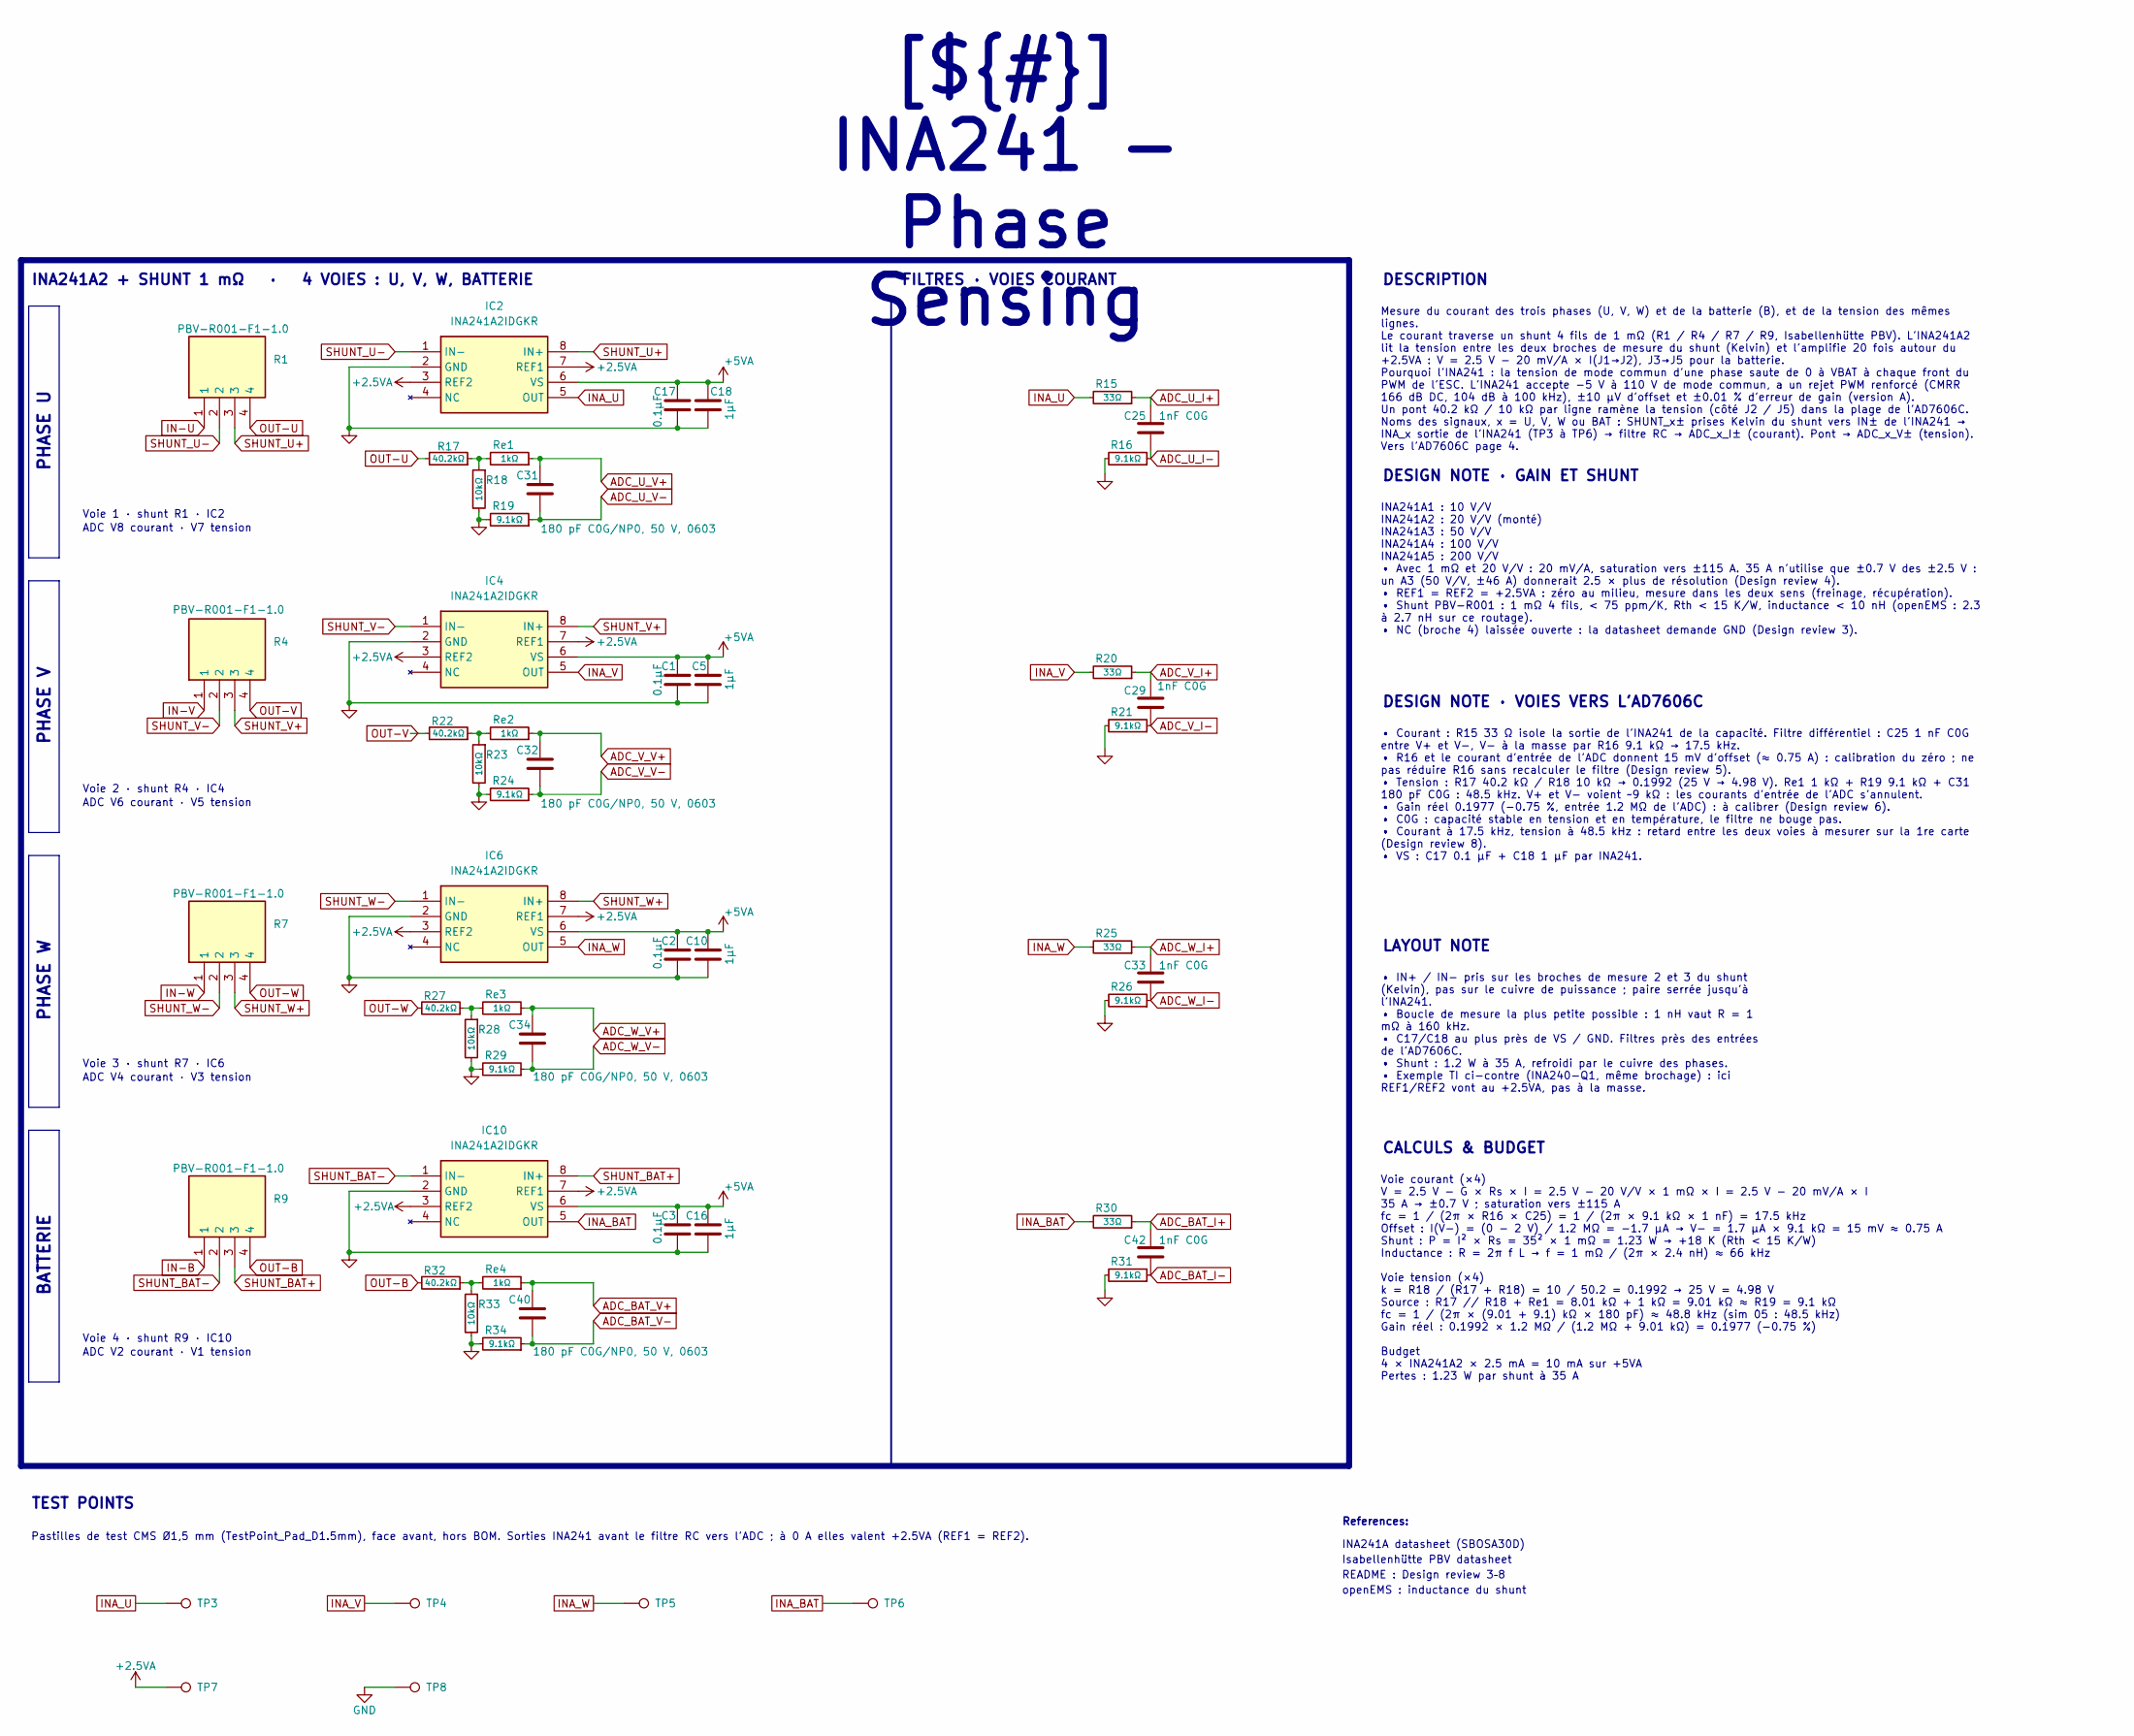
[picture p69: schematic INA241 - Phase Sensing.kicad_sch]

Parts:
C1, C2, C3, C17: 0.1µF; C_0603_1608Metric
C5, C10, C16, C18: 1µF; C_0603_1608Metric
C25, C29, C33, C42: 1nF C0G; C_0603_1608Metric
C31, C32, C34, C40: 180 pF C0G/NP0, 50 V, 0603; C_0603_1608Metric
IC2, IC4, IC6, IC10: INA241A2IDGKR; SOP65P490X110-8N; Manufacturer_Part_Number INA241A2IDGKR; Mouser Part Number 595-INA241A2IDGKR
R1, R4, R7, R9: PBV-R001-F1-1.0; PBVR001F110; Manufacturer_Part_Number PBV-R001-F1-1.0
R15, R20, R25, R30: 33Ω; R_0603_1608Metric
R16, R19, R21, R24, R26, R29, R31, R34: 9.1kΩ; R_0603_1608Metric
R17, R22, R27, R32: 40.2kΩ; R_0805_2012Metric
R18, R23, R28, R33: 10kΩ; R_0805_2012Metric
Re1, Re2, Re3, Re4: 1kΩ; R_0603_1608Metric
TP3, TP4, TP5, TP6, TP7, TP8: TestPoint; TestPoint_Pad_D1.5mm

Connections:
+2.5VA: IC2.3 (REF2), IC2.7 (REF1), IC4.3 (REF2), IC4.7 (REF1), IC6.3 (REF2), IC6.7 (REF1), IC10.3 (REF2), IC10.7 (REF1), TP7.1; also elsewhere on the board
+5VA: C1.1, C2.1, C3.1, C5.1, C10.1, C16.1, C17.1, C18.1, IC2.6 (VS), IC4.6 (VS), IC6.6 (VS), IC10.6 (VS); also elsewhere on the board
ADC_BAT_I+: C42.1, R30.2; also elsewhere on the board
ADC_BAT_I-: C42.2, R31.2; also elsewhere on the board
ADC_BAT_V+: C40.1, Re4.2; also elsewhere on the board
ADC_BAT_V-: C40.2, R34.2; also elsewhere on the board
ADC_U_I+: C25.1, R15.2; also elsewhere on the board
ADC_U_I-: C25.2, R16.2; also elsewhere on the board
ADC_U_V+: C31.1, Re1.2; also elsewhere on the board
ADC_U_V-: C31.2, R19.2; also elsewhere on the board
ADC_V_I+: C29.1, R20.2; also elsewhere on the board
ADC_V_I-: C29.2, R21.2; also elsewhere on the board
ADC_V_V+: C32.1, Re2.2; also elsewhere on the board
ADC_V_V-: C32.2, R24.2; also elsewhere on the board
ADC_W_I+: C33.1, R25.2; also elsewhere on the board
ADC_W_I-: C33.2, R26.2; also elsewhere on the board
ADC_W_V+: C34.1, Re3.2; also elsewhere on the board
ADC_W_V-: C34.2, R29.2; also elsewhere on the board
GND: C1.2, C2.2, C3.2, C5.2, C10.2, C16.2, C17.2, C18.2, IC2.2 (GND), IC4.2 (GND), IC6.2 (GND), IC10.2 (GND), R16.1, R18.1, R19.1, R21.1, R23.1, R24.1, R26.1, R28.1, R29.1, R31.1, R33.1, R34.1, TP8.1; also elsewhere on the board
IN-B: R9.1; also elsewhere on the board
IN-U: R1.1; also elsewhere on the board
IN-V: R4.1; also elsewhere on the board
IN-W: R7.1; also elsewhere on the board
INA_BAT: IC10.5 (OUT), R30.1, TP6.1 (1_1)
INA_U: IC2.5 (OUT), R15.1, TP3.1 (1_1)
INA_V: IC4.5 (OUT), R20.1, TP4.1 (1_1)
INA_W: IC6.5 (OUT), R25.1, TP5.1 (1_1)
unnamed: R17.2, R18.2, Re1.1
unnamed: R22.2, R23.2, Re2.1
unnamed: R27.2, R28.2, Re3.1
unnamed: R32.2, R33.2, Re4.1
OUT-B: R9.4, R32.1; also elsewhere on the board
OUT-U: R1.4, R17.1; also elsewhere on the board
OUT-V: R4.4, R22.1; also elsewhere on the board
OUT-W: R7.4, R27.1; also elsewhere on the board
SHUNT_BAT+: IC10.8 (IN+), R9.3
SHUNT_BAT-: IC10.1 (IN-), R9.2
SHUNT_U+: IC2.8 (IN+), R1.3
SHUNT_U-: IC2.1 (IN-), R1.2
SHUNT_V+: IC4.8 (IN+), R4.3
SHUNT_V-: IC4.1 (IN-), R4.2
SHUNT_W+: IC6.8 (IN+), R7.3
SHUNT_W-: IC6.1 (IN-), R7.2

Notes on the sheet:
ADC V6 courant · V5 tension
BATTERIE
Voie 3 · shunt R7 · IC6
README : Design review 3–8
Voie 4 · shunt R9 · IC10
References:
Voie 1 · shunt R1 · IC2
PHASE W
Voie 2 · shunt R4 · IC4
ADC V8 courant · V7 tension
ADC V4 courant · V3 tension
PHASE V
INA241A datasheet (SBOSA30D)
openEMS : inductance du shunt
PHASE U
Isabellenhütte PBV datasheet
ADC V2 courant · V1 tension
CALCULS & BUDGET
Mesure du courant des trois phases (U, V, W) et de la batterie (B), et de la tension des mêmes lignes. Le courant traverse un shunt 4 fils de 1 mΩ (R1 / R4 / R7 / R9, Isabellenhütte PBV). L'INA241A2 lit la tension entre les deux broches de mesure du shunt (Kelvin) et l'amplifie 20 fois autour du +2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
• IN+ / IN− pris sur les broches de mesure 2 et 3 du shunt (Kelvin), pas sur le cuivre de puissance ; paire serrée jusqu'à l'INA241. • Boucle de mesure la plus petite possible : 1 nH vaut R = 1 mΩ à 160 kHz. • C17/C18 au plus près de VS / GND. Filtres près des entrées de l'AD7606C. • Shunt : 1.2 W 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
FILTRES · VOIES COURANT
TEST POINTS
Pastilles de test CMS Ø1,5 mm (TestPoint_Pad_D1.5mm), face avant, hors BOM. Sorties INA241 avant le filtre RC vers l'ADC ; à 0 A elles valent +2.5VA (REF1 = REF2).
DESCRIPTION
DESIGN NOTE · VOIES VERS L'AD7606C
INA241A2 + SHUNT 1 mΩ · 4 VOIES : U, V, W, BATTERIE
• Courant : R15 33 Ω isole la sortie de l'INA241 de la capacité. Filtre différentiel : C25 1 nF C0G entre V+ et V−, V− à la masse par R16 9.1 kΩ → 17.5 kHz. • R16 et le courant d'entrée de l'ADC donnent 15 mV d'offset (≈ 0.75 A) : calibration du zéro ; ne pas réduire R16 sans recalculer le filtre (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
LAYOUT NOTE
INA241A1 : 10 V/V INA241A2 : 20 V/V (monté) INA241A3 : 50 V/V INA241A4 : 100 V/V INA241A5 : 200 V/V • Avec 1 mΩ et 20 V/V : 20 mV/A, saturation vers ±115 A. 35 A n'utilise que ±0.7 V des ±2.5 V : un A3 (50 V/V, ±46 A) donnerait 2.5 × plus de résolution (Design review 4). • REF1 = REF2 = +2.5VA : zé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
Voie courant (×4) V = 2.5 V − G × Rs × I = 2.5 V − 20 V/V × 1 mΩ × I = 2.5 V − 20 mV/A × I 35 A → ±0.7 V ; saturation vers ±115 A fc = 1 / (2π × R16 × C25) = 1 / (2π × 9.1 kΩ × 1 nF) = 17.5 kHz Offset : I(V−) = (0 − 2 V) / 1.2 MΩ = −1.7 µA → V− = 1.7 µA × 9.1 kΩ = 15 mV ≈ 0.75 A Shunt : P = I² × Rs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
[${#}] ${TITLE}
DESIGN NOTE · GAIN ET SHUNT

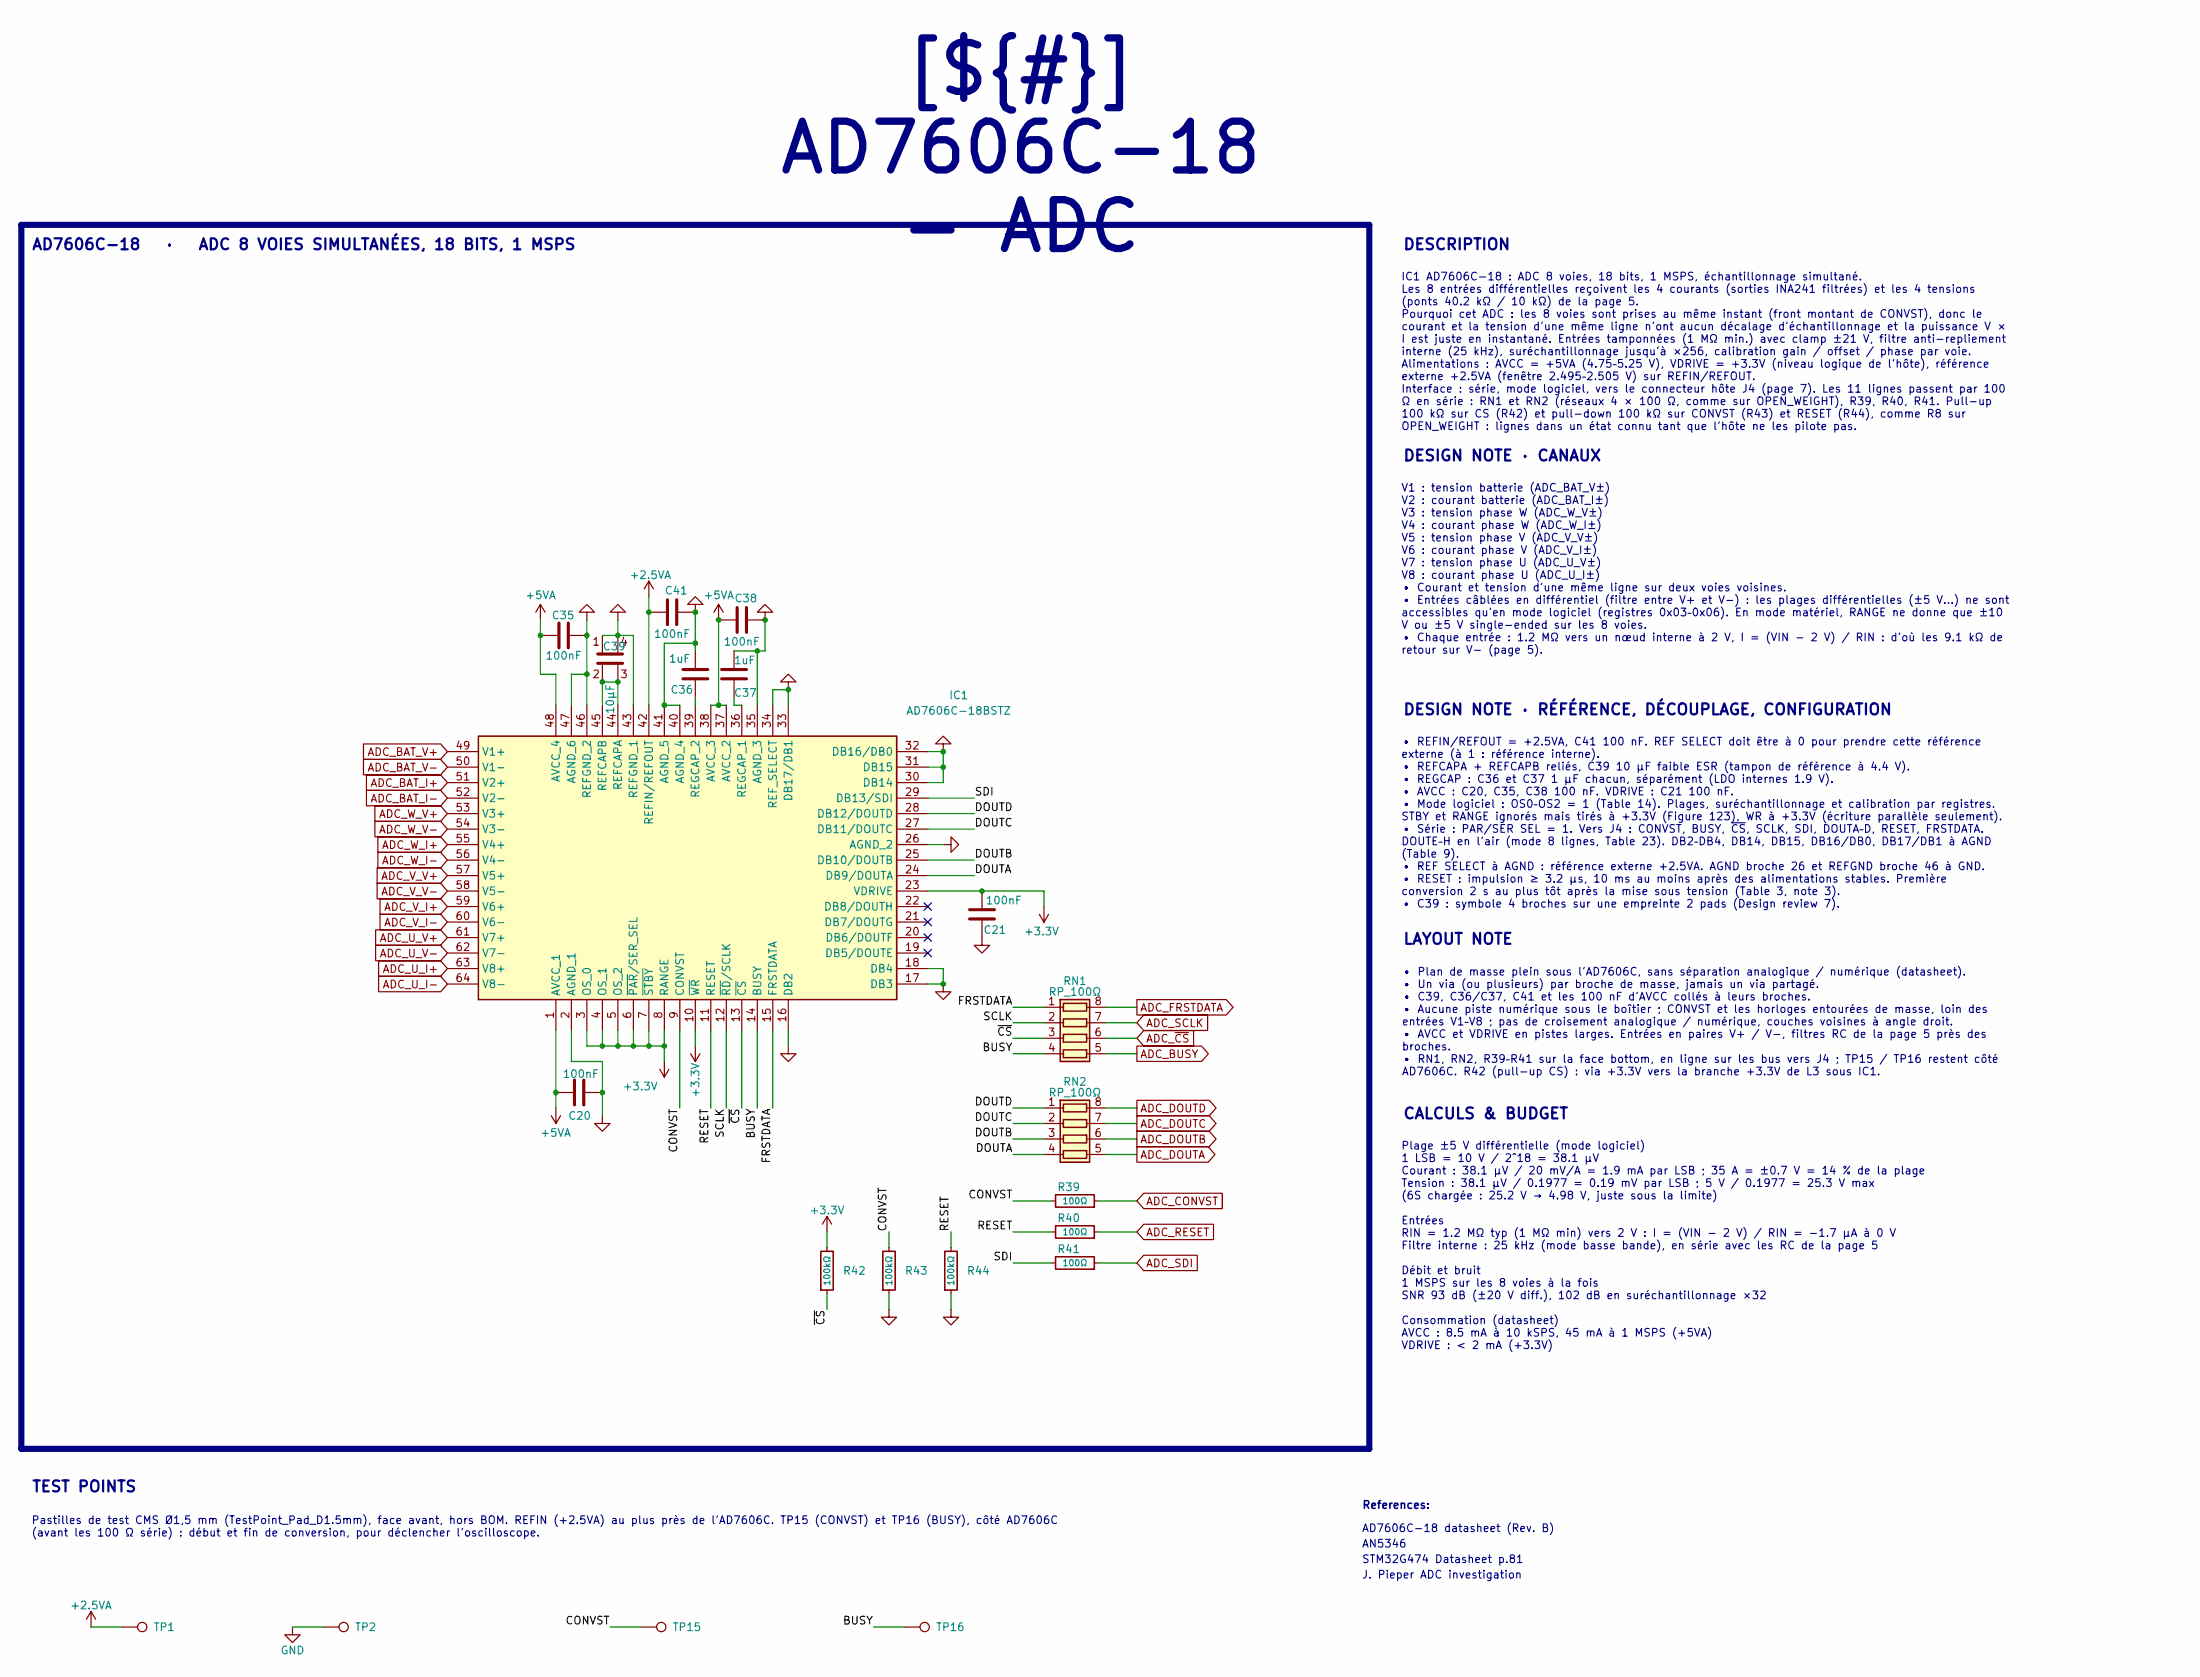
[picture p70: schematic AD7606C-18 - ADC.kicad_sch]

Parts:
C20, C21, C35, C38, C41: 100nF; C_0603_1608Metric
C36, C37: 1uF; C_0603_1608Metric
C39: 10µF; C_0805_2012Metric
IC1: AD7606C-18BSTZ; QFP50P1200X1200X160-64N; Manufacturer_Part_Number AD7606C-18BSTZ; Mouser Part Number 584-AD7606C-18BSTZ
R39, R40, R41: 100Ω; R_0603_1608Metric
R42, R43, R44: 100kΩ; R_0603_1608Metric
RN1, RN2: RP_100Ω; R_Array_Concave_4x0603
TP1, TP2, TP15, TP16: TestPoint; TestPoint_Pad_D1.5mm

Connections:
+2.5VA: C41.2, IC1.42 (REFIN/REFOUT), TP1.1; also elsewhere on the board
+3.3V: C21.2, IC1.3 (OS_0), IC1.4 (OS_1), IC1.5 (OS_2), IC1.6 (~PAR/SER_SEL), IC1.7 (~STBY), IC1.8 (RANGE), IC1.10 (~WR), IC1.23 (VDRIVE), R42.1; also elsewhere on the board
+5VA: C20.1, C35.2, C38.2, IC1.1 (AVCC_1), IC1.37 (AVCC_2), IC1.38 (AVCC_3), IC1.48 (AVCC_4); also elsewhere on the board
/Project Architecture/AD7606C-18_ADC/BUSY: IC1.14 (BUSY), RN1.4 (R4.1), TP16.1 (1_1)
/Project Architecture/AD7606C-18_ADC/CONVST: IC1.9 (CONVST), R39.1, R43.1, TP15.1 (1_1)
/Project Architecture/AD7606C-18_ADC/DOUTA: IC1.24 (DB9/DOUTA), RN2.4 (R4.1)
/Project Architecture/AD7606C-18_ADC/DOUTB: IC1.25 (DB10/DOUTB), RN2.3 (R3.1)
/Project Architecture/AD7606C-18_ADC/DOUTC: IC1.27 (DB11/DOUTC), RN2.2 (R2.1)
/Project Architecture/AD7606C-18_ADC/DOUTD: IC1.28 (DB12/DOUTD), RN2.1 (R1.1)
/Project Architecture/AD7606C-18_ADC/FRSTDATA: IC1.15 (FRSTDATA), RN1.1 (R1.1)
/Project Architecture/AD7606C-18_ADC/RESET: IC1.11 (RESET), R40.1, R44.1
/Project Architecture/AD7606C-18_ADC/SCLK: IC1.12 (~RD/SCLK), RN1.2 (R2.1)
/Project Architecture/AD7606C-18_ADC/SDI: IC1.29 (DB13/SDI), R41.1
/Project Architecture/AD7606C-18_ADC/~CS: IC1.13 (~CS), R42.2, RN1.3 (R3.1)
ADC_BAT_I+: IC1.51 (V2+); also elsewhere on the board
ADC_BAT_I-: IC1.52 (V2-); also elsewhere on the board
ADC_BAT_V+: IC1.49 (V1+); also elsewhere on the board
ADC_BAT_V-: IC1.50 (V1-); also elsewhere on the board
ADC_BUSY: RN1.5 (R4.2); also elsewhere on the board
ADC_CONVST: R39.2; also elsewhere on the board
ADC_DOUTA: RN2.5 (R4.2); also elsewhere on the board
ADC_DOUTB: RN2.6 (R3.2); also elsewhere on the board
ADC_DOUTC: RN2.7 (R2.2); also elsewhere on the board
ADC_DOUTD: RN2.8 (R1.2); also elsewhere on the board
ADC_FRSTDATA: RN1.8 (R1.2); also elsewhere on the board
ADC_RESET: R40.2; also elsewhere on the board
ADC_SCLK: RN1.7 (R2.2); also elsewhere on the board
ADC_SDI: R41.2; also elsewhere on the board
ADC_U_I+: IC1.63 (V8+); also elsewhere on the board
ADC_U_I-: IC1.64 (V8-); also elsewhere on the board
ADC_U_V+: IC1.61 (V7+); also elsewhere on the board
ADC_U_V-: IC1.62 (V7-); also elsewhere on the board
ADC_V_I+: IC1.59 (V6+); also elsewhere on the board
ADC_V_I-: IC1.60 (V6-); also elsewhere on the board
ADC_V_V+: IC1.57 (V5+); also elsewhere on the board
ADC_V_V-: IC1.58 (V5-); also elsewhere on the board
ADC_W_I+: IC1.55 (V4+); also elsewhere on the board
ADC_W_I-: IC1.56 (V4-); also elsewhere on the board
ADC_W_V+: IC1.53 (V3+); also elsewhere on the board
ADC_W_V-: IC1.54 (V3-); also elsewhere on the board
ADC_~CS: RN1.6 (R3.2); also elsewhere on the board
GND: C20.2, C21.1, C35.1, C36.2, C37.2, C38.1, C39.1, C39.4, C41.1, IC1.2 (AGND_1), IC1.16 (DB2), IC1.17 (DB3), IC1.18 (DB4), IC1.26 (AGND_2), IC1.30 (DB14), IC1.31 (DB15), IC1.32 (DB16/DB0), IC1.33 (DB17/DB1), IC1.34 (REF_SELECT), IC1.35 (AGND_3), IC1.40 (AGND_4), IC1.41 (AGND_5), IC1.43 (REFGND_1), IC1.46 (REFGND_2), IC1.47 (AGND_6), R43.2, R44.2, TP2.1; also elsewhere on the board
unnamed: C39.2, C39.3, IC1.44 (REFCAPA), IC1.45 (REFCAPB)
unnamed: C37.1, IC1.36 (REGCAP_1)
unnamed: C36.1, IC1.39 (REGCAP_2)

Notes on the sheet:
References:
J. Pieper ADC investigation
STM32G474 Datasheet p.81
AN5346
AD7606C-18 datasheet (Rev. B)
DESCRIPTION
Pastilles de test CMS Ø1,5 mm (TestPoint_Pad_D1.5mm), face avant, hors BOM. REFIN (+2.5VA) au plus près de l'AD7606C. TP15 (CONVST) et TP16 (BUSY), côté AD7606C (avant les 100 Ω série) : début et fin de conversion, pour déclencher l'oscilloscope.
V1 : tension batterie (ADC_BAT_V±) V2 : courant batterie (ADC_BAT_I±) V3 : tension phase W (ADC_W_V±) V4 : courant phase W (ADC_W_I±) V5 : tension phase V (ADC_V_V±) V6 : courant phase V (ADC_V_I±) V7 : tension phase U (ADC_U_V±) V8 : courant phase U (ADC_U_I±) • Courant et tension d'une même ligne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
Plage ±5 V différentielle (mode logiciel) 1 LSB = 10 V / 2^18 = 38.1 µV Courant : 38.1 µV / 20 mV/A = 1.9 mA par LSB ; 35 A = ±0.7 V = 14 % de la plage Tension : 38.1 µV / 0.1977 = 0.19 mV par LSB ; 5 V / 0.1977 = 25.3 V max (6S chargée : 25.2 V → 4.98 V, juste sous la limite) Entrées RIN = 1.2 MΩ 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
CALCULS & BUDGET
• Plan de masse plein sous l'AD7606C, sans séparation analogique / numérique (datasheet). • Un via (ou plusieurs) par broche de masse, jamais un via partagé. • C39, C36/C37, C41 et les 100 nF d'AVCC collés à leurs broches. • Aucune piste numérique sous le boîtier ; CONVST et les horloges entourées 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
DESIGN NOTE · CANAUX
LAYOUT NOTE
[${#}] ${TITLE}
DESIGN NOTE · RÉFÉRENCE, DÉCOUPLAGE, CONFIGURATION
TEST POINTS
• REFIN/REFOUT = +2.5VA, C41 100 nF. REF SELECT doit être à 0 pour prendre cette référence externe (à 1 : référence interne). • REFCAPA + REFCAPB reliés, C39 10 µF faible ESR (tampon de référence à 4.4 V). • REGCAP : C36 et C37 1 µF chacun, séparément (LDO internes 1.9 V). • AVCC : C20, C35, C38 10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
IC1 AD7606C-18 : ADC 8 voies, 18 bits, 1 MSPS, échantillonnage simultané. Les 8 entrées différentielles reçoivent les 4 courants (sorties INA241 filtrées) et les 4 tensions (ponts 40.2 kΩ / 10 kΩ) de la page 5. Pourquoi cet ADC : les 8 voies sont prises au même instant (front montant de CONVST), do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
AD7606C-18 · ADC 8 VOIES SIMULTANÉES, 18 BITS, 1 MSPS

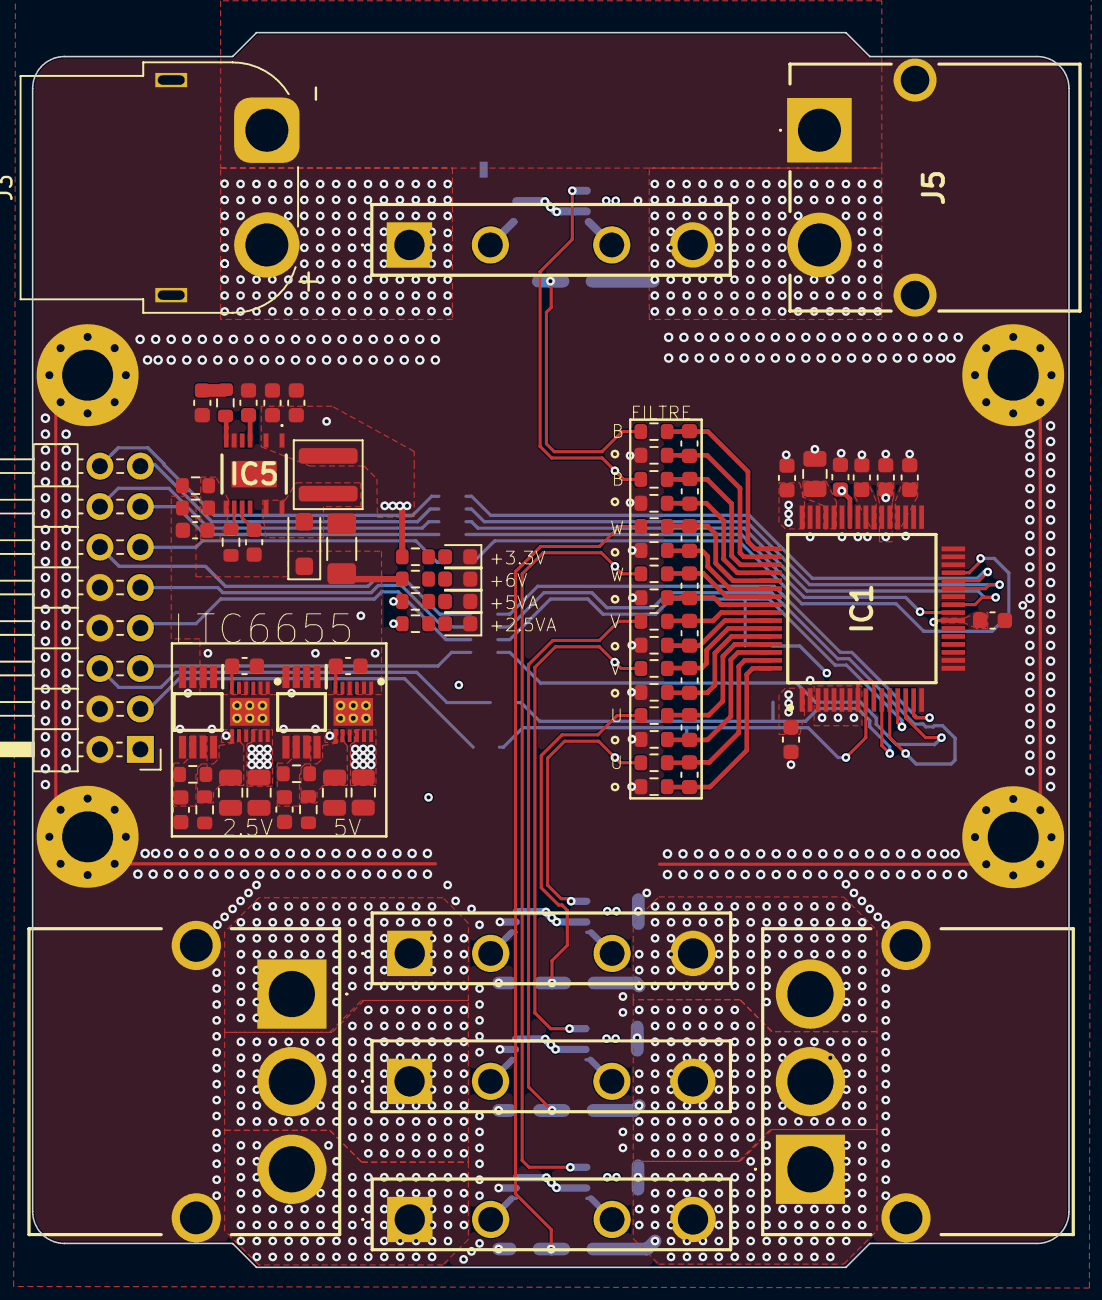
[picture p71: board OPEN_PHASE.kicad_pcb from above]

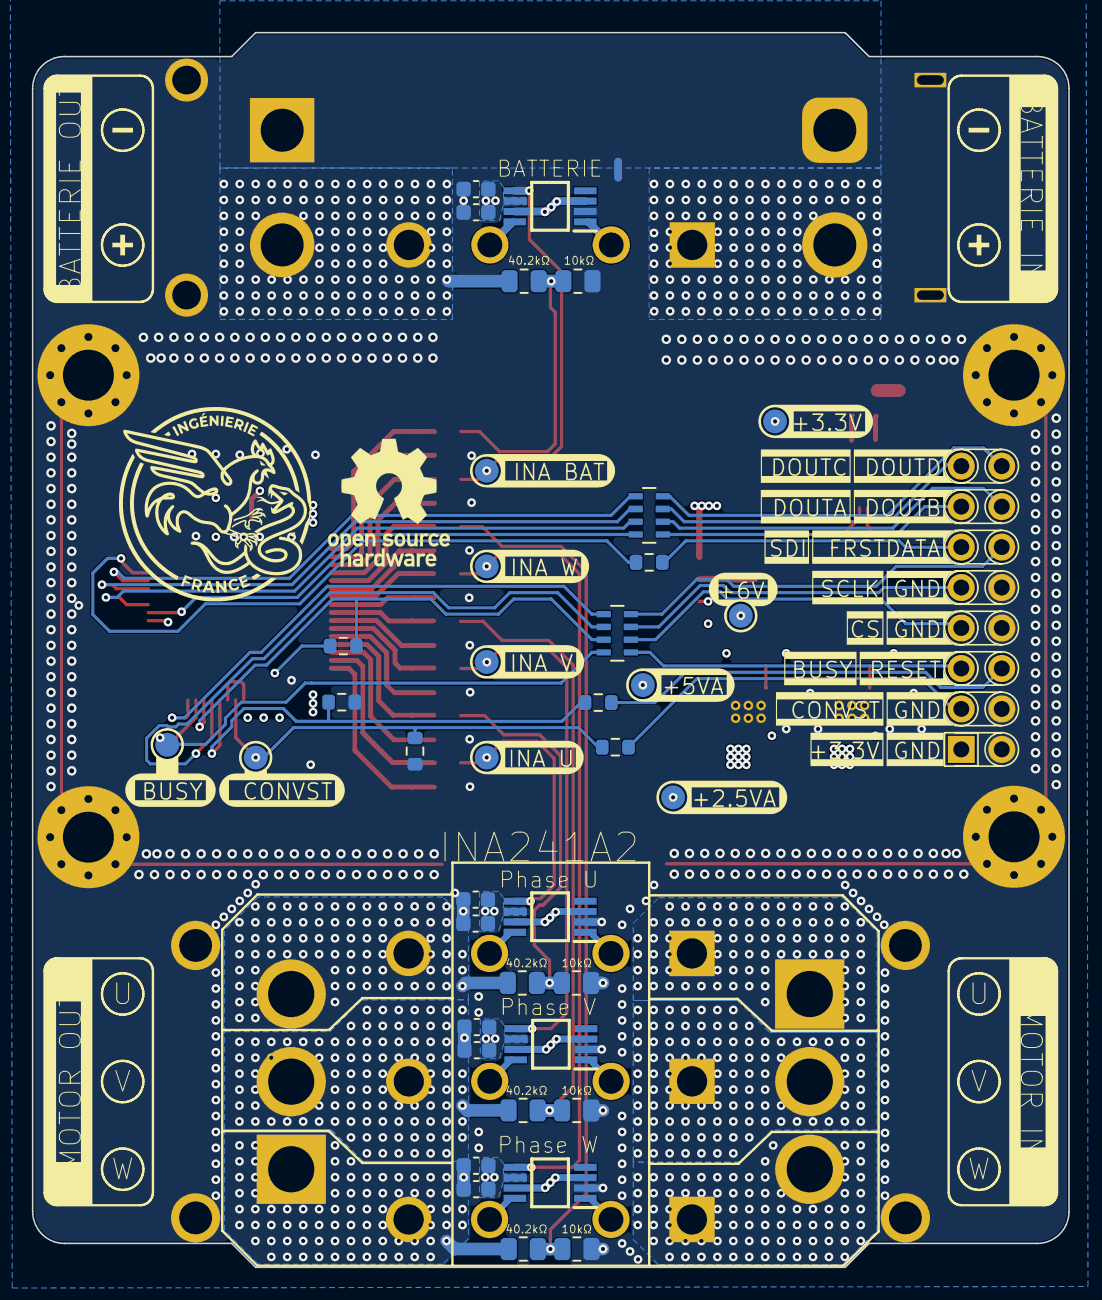
[picture p72: board OPEN_PHASE.kicad_pcb from below]

Board: 4 copper layers, 65.0 x 77.5 mm, 124 parts (40 on the bottom side), 86 nets.

Other parts of the board:
LOGO2: OSHW-Logo_7.5x8mm_SilkScreen
