foukouda/OPEN_PHASE/Simulation/LTspice/generate_asc.py

# Generates the OPEN_PHASE LTspice schematics (.asc) as properly wired circuits.
# WARNING: running it overwrites the .asc files in this folder (hand edits made
# in LTspice are lost). Reuse the Sch class / PINS table for other projects.
import os

OUT = os.path.dirname(os.path.abspath(__file__))

PINS = {  # R0 pin coordinates
    "res": {"A": (16, 16), "B": (16, 96)},
    "cap": {"A": (16, 0), "B": (16, 64)},
    "ind": {"A": (16, 16), "B": (16, 96)},
    "voltage": {"+": (0, 16), "-": (0, 96)},
    "bv": {"+": (0, 16), "-": (0, 96)},
    "current": {"+": (0, 0), "-": (0, 80)},
    "bi": {"+": (0, 0), "-": (0, 80)},
    "schottky": {"A": (16, 0), "K": (16, 64)},
    "LT8362": {"EN": (-160, -144), "MODE": (-160, -48), "RT": (-160, 48), "SS": (-160, 144),
               "VIN": (-80, -208), "SW": (80, -208), "INTVCC": (160, -144), "FBX": (160, -48),
               "VC": (160, 48), "BIAS": (160, 144), "GND": (0, 208)},
    "LT3045-1": {"IN": (-240, -144), "EN": (-240, -64), "VIOC": (-240, 16), "PG": (-240, 96),
                 "SET": (-128, 160), "GND": (0, 160), "ILIM": (96, 160), "PGFB": (224, 160),
                 "OUT": (304, 0), "OUTS": (304, 80)},
    "LTC6655-5": {"IN": (-144, -32), "SHDN": (-144, 32), "GND": (0, 64),
                  "OUT_F": (144, -32), "P6": (144, 32)},
    "LTC6655-2.5": {"IN": (-144, -32), "SHDN": (-144, 32), "GND": (0, 64),
                    "OUT_F": (144, -32), "P6": (144, 32)},
    "INA241A2_behav": {"IN+": (-128, -48), "IN-": (-128, 48), "REF1": (-64, 96), "REF2": (64, 96),
                       "VS": (0, -96), "GND": (0, 96), "OUT": (128, 0)},
}


def tf(rot, p):
    x, y = p
    return {"R0": (x, y), "R90": (-y, x), "R180": (-x, -y), "R270": (y, -x),
            "M0": (-x, y), "M180": (x, -y)}[rot]


WIN = {  # attribute windows for rotated two-pin parts (symbol frame)
    ("res", "R270"): ["WINDOW 0 32 56 VTop 2", "WINDOW 3 0 56 VBottom 2"],
    ("ind", "R270"): ["WINDOW 0 32 56 VTop 2", "WINDOW 3 4 56 VBottom 2"],
    ("schottky", "R270"): ["WINDOW 0 32 32 VTop 2", "WINDOW 3 0 32 VBottom 2"],
}


class Sch:
    def __init__(self, w, h):
        self.head = ["Version 4", f"SHEET 1 {w} {h}"]
        self.w, self.f, self.s, self.t = [], [], [], []
        self.dx = self.dy = 0

    def at(self, x, y):
        """Origin of the block drawn next: every coordinate given afterwards is shifted by (x, y)."""
        self.dx, self.dy = x, y

    def part(self, sym, pin, at, name, value=None, rot="R0", spiceline=None, value2=None,
             windows=None):
        """Place `sym` so that its pin `pin` lands on `at`; return all pin positions."""
        px, py = tf(rot, PINS[sym][pin])
        ox, oy = at[0] - px, at[1] - py
        s = [f"SYMBOL {sym} {ox + self.dx} {oy + self.dy} {rot}"]
        s += windows if windows is not None else WIN.get((sym, rot), [])
        s.append(f"SYMATTR InstName {name}")
        if value is not None:
            s.append(f"SYMATTR Value {value}")
        if value2:
            s.append(f"SYMATTR Value2 {value2}")
        if spiceline:
            s.append(f"SYMATTR SpiceLine {spiceline}")
        self.s += s
        return {k: (ox + tf(rot, v)[0], oy + tf(rot, v)[1]) for k, v in PINS[sym].items()}

    def wire(self, *pts):
        for a, b in zip(pts[:-1], pts[1:]):
            self.w.append(f"WIRE {a[0] + self.dx} {a[1] + self.dy} {b[0] + self.dx} {b[1] + self.dy}")

    def bus(self, y, xs):
        """Horizontal rail split at every tap so each tap is a real junction."""
        xs = sorted(set(xs))
        for a, b in zip(xs[:-1], xs[1:]):
            self.wire((a, y), (b, y))

    def gnd(self, p, drop=0):
        if drop:
            self.wire(p, (p[0], p[1] + drop))
            p = (p[0], p[1] + drop)
        self.f.append(f"FLAG {p[0] + self.dx} {p[1] + self.dy} 0")

    def label(self, p, name):
        self.f.append(f"FLAG {p[0] + self.dx} {p[1] + self.dy} {name}")

    def text(self, x, y, txt, size=2, directive=False):
        self.t.append(f"TEXT {x + self.dx} {y + self.dy} Left {size} "
                      f"{'!' if directive else ';'}{txt.replace(chr(10), chr(92) + 'n')}")

    def shunt_cap(self, x, y, name, value, spiceline=None):
        c = self.part("cap", "A", (x, y), name, value, spiceline=spiceline)
        self.gnd(c["B"])

    def save(self, fname):
        with open(os.path.join(OUT, fname), "w", encoding="utf-8", newline="\n") as fh:
            fh.write("\n".join(self.head + self.w + self.f + self.s + self.t) + "\n")


MODELS = (
    ".model PMEG2020AEA D(Is=5.409u Rs=.05676 N=1.02 Cjo=.1908n M=.4863 Eg=.69 Xti=2 BV=22 IBV=50u "
    "Vj=.3408 Iave=2 Vpk=20 mfg=NXP type=Schottky)"
)

# AD7606C AVCC current at 1 MSPS
ASBUILT = ".param Iavcc=45m"


# ------------------------------------------------------------------ blocks
def boost(s, v1="PWL(0 0 100u 3.3)"):
    """LT8362 +3.3V -> +6V (sheet ALIMENTATION). +3.3V rail at y = 0, +6V rail from x = 1200."""
    Y = 0
    v = s.part("voltage", "+", (0, Y), "V1", v1, spiceline="Rser=20m",
               windows=["WINDOW 0 -104 48 Left 2", "WINDOW 3 -200 80 Left 1", "WINDOW 39 -200 104 Left 1"])
    s.gnd(v["-"])
    s.text(-200, 176, "Host +3.3V\n(no connector on the board yet)", 1)
    s.label((96, Y), "+3.3V")
    for x, n, val, sl in ((176, "C22", "4.7u", "Rser=5m"), (304, "C23", "0.1u", "Rser=20m"),
                          (432, "C21", "0.1u", "Rser=20m")):
        s.shunt_cap(x, Y, n, val, sl)
    i = s.part("current", "+", (560, Y), "I_VDRIVE", "1.8m")
    s.gnd(i["-"])
    s.text(416, 112, "C21 + I_VDRIVE =\nAD7606C VDRIVE (1 MSPS)", 1)
    # LT8362: VIN and SW pins come out of the top of the symbol
    ic = s.part("LT8362", "VIN", (912, 160), "IC5")
    s.wire(ic["VIN"], (912, Y))
    s.wire(ic["EN"], (752, 224), (752, Y))
    s.bus(Y, [0, 96, 176, 304, 432, 560, 752, 912, 944])
    l1 = s.part("ind", "A", (944, Y), "L1", "2.2u", rot="R270", spiceline="Rser=22m")
    s.text(912, -120, "WE-MAPI 4030 74438357022", 1)
    s.wire(l1["B"], (1072, Y), (1136, Y))
    s.wire(ic["SW"], (1072, Y))
    s.label((1072, Y), "SW")
    d2 = s.part("schottky", "A", (1136, Y), "D2", "PMEG2020AEA", rot="R270")
    s.text(1112, -120, "PMEG2020EH", 1)
    s.text(600, 304, "SYNC/MODE open\n= pulse-skipping", 1)
    # RT, SS
    s.wire(ic["RT"], (704, 416))
    r2 = s.part("res", "A", (704, 416), "R2", "20k")
    s.gnd(r2["B"])
    s.wire(ic["SS"], (768, 512))
    c24 = s.part("cap", "A", (768, 512), "C24", "10n")
    s.gnd(c24["B"])
    s.label((768, 512), "SS")
    # INTVCC, VC compensation, BIAS
    s.wire(ic["INTVCC"], (1232, 224))
    c27 = s.part("cap", "A", (1232, 224), "C27", "1u")
    s.gnd(c27["B"])
    s.label((1232, 224), "INTVCC")
    s.wire(ic["VC"], (1232, 416))
    r3 = s.part("res", "A", (1232, 416), "R3", "36.5k")
    s.wire(r3["B"], (1232, 528))
    c26 = s.part("cap", "A", (1232, 528), "C26", "1n")
    s.gnd(c26["B"])
    s.label((1232, 416), "VC")
    s.label((1232, 528), "CC")
    s.wire(ic["BIAS"], (1184, 512), (1184, 544))
    s.gnd((1184, 544))
    s.gnd(ic["GND"], 32)
    # feedback divider + feed-forward capacitor
    r5 = s.part("res", "A", (1360, Y), "R5", "1Meg")
    r6 = s.part("res", "A", (1360, 176), "R6", "365k")
    s.wire(r5["B"], (1360, 128), r6["A"])
    s.gnd(r6["B"])
    s.wire(ic["FBX"], (1296, 320), (1296, 128), (1360, 128))
    s.label((1296, 128), "FBX")
    c28 = s.part("cap", "A", (1456, Y), "C28", "4.7p")
    s.wire(c28["B"], (1456, 128), (1360, 128))
    rail6 = [d2["K"][0], 1360, 1456]
    for x, n, val, sl in ((1584, "C30", "22u", "Rser=3m"), (1712, "C9", "4.7u", "Rser=5m"),
                          (1840, "C11", "4.7u", "Rser=5m")):
        s.shunt_cap(x, Y, n, val, sl)
        rail6.append(x)
    s.text(0, -240, "LT8362 BOOST  +3.3V -> +6V, 2 MHz   (schematic sheet ALIMENTATION)", 3)
    return rail6


def six_volt_source(s, value, value2=None, note="+6V (settled boost output)"):
    v = s.part("voltage", "+", (1840, 0), "V_6V", value, spiceline="Rser=10m", value2=value2,
               windows=["WINDOW 0 -104 48 Left 2", "WINDOW 3 -280 80 Left 1", "WINDOW 39 -280 104 Left 1",
                        "WINDOW 123 -280 128 Left 1"])
    s.gnd(v["-"])
    s.text(1560, 176, note, 1)
    return [1840]


def ref_ldo(s, y0, ref_sym, ref_name, ldo_name, r_ser, r_set, c_ref, c_set, lab_ref, lab_set):
    """LTC6655 reference driving the SET pin of an LT3045-1 through 1 k. +6V rail at y = y0.

    Returns the x positions of the +6V taps and of the start of the output rail (y = y0 + 144)."""
    yr = y0 + 448
    ref = s.part(ref_sym, "IN", (2128, yr), ref_name,
                 windows=["WINDOW 0 -144 -88 Left 2", "WINDOW 3 -64 -88 Left 2"])
    s.wire(ref["IN"], (2080, yr), (2080, y0))
    s.wire(ref["SHDN"], (2080, yr + 64), (2080, yr))
    s.gnd(ref["GND"], 32)
    # LTC6655: pin 6 is VOUT_S, Kelvin-tied to VOUT_F
    s.wire(ref["P6"], (2512, yr + 64), (2512, yr))
    s.bus(yr, [ref["OUT_F"][0], 2512, 2560, 2608, 2688])
    s.label((2560, yr), lab_ref)
    s.shunt_cap(2608, yr, c_ref, "10u", "Rser=5m")
    rs = s.part("res", "A", (2688, yr), r_ser[0], r_ser[1], rot="R270")
    rset = s.part("res", "A", (2848, yr), r_set[0], r_set[1])
    s.gnd(rset["B"])
    s.shunt_cap(2976, yr, c_set, "10u", "Rser=5m")
    s.bus(yr, [rs["B"][0], 2848, 2976, 3040, 3104])
    s.label((3040, yr), lab_set)
    ldo = s.part("LT3045-1", "IN", (2992, y0), ldo_name)
    s.wire(ldo["EN"], (2944, y0 + 80), (2944, y0))
    s.wire(ldo["SET"], (3104, yr))
    s.gnd(ldo["GND"], 32)
    s.gnd(ldo["ILIM"], 32)
    s.wire(ldo["PGFB"], (3456, y0 + 368))
    s.label((3456, y0 + 368), "+6V")
    s.text(3488, y0 + 344, "PGFB = IN : fast start-up and PG disabled\nVIOC, PG open", 1)
    s.wire(ldo["OUTS"], (3584, y0 + 224), (3584, y0 + 144))
    return [2080, 2944, 2992], [ldo["OUT"][0], 3584]


def analog_rails(s, rail6):
    """Both precision rails (sheet ALIMENTATION) and their loads."""
    # --- +5VA : IC7 LTC6655-5 -> R8 -> SET of IC8
    taps, rail5 = ref_ldo(s, 0, "LTC6655-5", "IC7", "IC8", ("R8", "1k"), ("R14", "49.9k"), "C8", "C13",
                          "REF5", "SET5")
    s.bus(0, rail6 + [1968, 2016] + taps)
    s.label((1968, 0), "+6V")
    Y5 = 144
    s.label((3648, Y5), "+5VA")
    s.shunt_cap(3744, Y5, "C14", "10u", "Rser=5m")
    s.shunt_cap(3872, Y5, "C1", "0.1u", "m=7 Rser=20m")
    s.shunt_cap(4000, Y5, "C5", "1u", "m=4 Rser=10m")
    i = s.part("current", "+", (4128, Y5), "I_AVCC", "{Iavcc}")
    s.gnd(i["-"])
    i = s.part("current", "+", (4288, Y5), "I_INA", "10m")
    s.gnd(i["-"])
    s.bus(Y5, rail5 + [3648, 3744, 3872, 4000, 4128, 4288])
    s.text(3840, 256, "C1 (x7) = C1 C2 C3 C17 C20 C35 C38\nC5 (x4) = C5 C10 C16 C18", 1)
    s.text(4096, 256, "I_AVCC = AD7606C AVCC (1 MSPS)\nI_INA = 4 x INA241 IQ\n(3 phases + DC bus)", 1)
    s.text(2080, -240, "+5VA : LTC6655-5 (IC7) reference buffered by LT3045-1 (IC8)", 3)
    # --- +2.5VA : IC3 LTC6655-2.5 -> R11 -> SET of IC9
    YB = 880
    taps, rail25 = ref_ldo(s, YB, "LTC6655-2.5", "IC3", "IC9", ("R11", "1k"), ("R12", "24.9k"), "C12",
                           "C19", "REF2V5", "SET2V5")
    s.wire((2016, 0), (2016, YB))
    s.bus(YB, [2016] + taps)
    Y25 = YB + 144
    s.label((3648, Y25), "+2.5VA")
    s.shunt_cap(3744, Y25, "C15", "10u", "Rser=5m")
    s.shunt_cap(3872, Y25, "C41", "0.1u", "Rser=20m")
    i = s.part("current", "+", (4000, Y25), "I_REF", "100u")
    s.gnd(i["-"])
    s.bus(Y25, rail25 + [3648, 3744, 3872, 4000])
    s.text(3840, Y25 + 112, "C41 = AD7606C REFIN/REFOUT\nI_REF = INA241 REF pins + REFIN (estimate)", 1)
    s.text(2080, YB - 112, "+2.5VA : LTC6655-2.5 (IC3) reference buffered by LT3045-1 (IC9)", 3)


def header(s, title, sub):
    s.text(0, -448, title, 4)
    s.text(0, -376, sub, 2)


SHEET = (4700, 1900)
DX, DY = 0, 760   # directives: free area under the boost stage

# ============================================================ 01 start-up
s = Sch(*SHEET)
header(s, "OPEN_PHASE - 01 - Power chain start-up : +3.3V -> LT8362 -> +6V -> LT3045-1 -> +5VA / +2.5VA",
       "Switching simulation (2 MHz) of the boost soft-start, as built. Full settling of the analog rails: see 02_Analog_Rails_Startup.asc")
analog_rails(s, boost(s))
s.text(DX, DY, ".tran 0 12m 0 20n", 2, True)
s.text(DX, DY + 40, ASBUILT, 2, True)
s.text(DX, DY + 80, ".save V(+3.3V) V(+6V) V(+5VA) V(+2.5VA) V(SS) V(VC) V(SET5) V(SET2V5) V(REF5) V(REF2V5) I(L1) I(V1)", 2, True)
s.text(DX, DY + 120, ".meas tran V6_at_12ms AVG V(+6V) FROM 11m TO 12m\n.meas tran V6_max MAX V(+6V)\n"
                     ".meas tran T6_90 WHEN V(+6V)=5.37 RISE=1\n.meas tran IL_peak MAX I(L1)\n"
                     ".meas tran I3V3_inrush MIN I(V1)", 2, True)
s.text(DX, DY + 360, MODELS, 1, True)
s.save("01_Power_Chain_Startup.asc")

# ============================================================ 02 analog rails
s = Sch(*SHEET)
header(s, "OPEN_PHASE - 02 - Analog rails start-up and accuracy : +5VA and +2.5VA",
       "The boost is replaced by its settled output (1 ms ramp, see 01), so the rails can be followed until they are settled.")
r6 = six_volt_source(s, "PWL(0 0 1m 5.96)", note="+6V from the boost\n(1 ms ramp)")
analog_rails(s, r6)
s.text(DX, DY, ".tran 0 150m 0 20u", 2, True)
s.text(DX, DY + 40, ASBUILT, 2, True)
s.text(DX, DY + 120, ".meas tran V5VA AVG V(+5VA) FROM 140m TO 150m\n.meas tran V2V5A AVG V(+2.5VA) FROM 140m TO 150m\n"
                     ".meas tran VREF5 AVG V(REF5) FROM 140m TO 150m\n.meas tran VREF2V5 AVG V(REF2V5) FROM 140m TO 150m\n"
                     ".meas tran I_R8 AVG I(R8) FROM 140m TO 150m\n.meas tran I_R11 AVG I(R11) FROM 140m TO 150m\n"
                     ".meas tran T5_99 WHEN V(+5VA)=4.95 RISE=1\n.meas tran T5_999 WHEN V(+5VA)=4.995 RISE=1\n"
                     ".meas tran I_6V AVG I(V_6V) FROM 140m TO 150m", 2, True)
s.save("02_Analog_Rails_Startup.asc")

# ============================================================ 03 boost ripple
# The encrypted LDO / reference models cannot be started from a preset operating point and need
# ~70 ms to settle, so the steady-state ripple is simulated on the boost alone, loaded by the
# input current of the analog rails (I_6V of simulation 02). What is left on +5VA / +2.5VA is
# obtained from the PSRR of simulation 04.
s = Sch(2700, 1500)
header(s, "OPEN_PHASE - 03 - Steady-state ripple of the LT8362 boost on +6V",
       "Boost alone, loaded by the input current of both analog rails (AD7606C at 1 MSPS, see I_6V in 02). Measured over 5..6 ms.")
r6 = boost(s)
i = s.part("current", "+", (2096, 0), "I_6V", "PWL(0 0 2m 0 2.1m {I6})",
           windows=["WINDOW 0 24 16 Left 2", "WINDOW 3 24 44 Left 1"])
s.gnd(i["-"])
s.bus(0, r6 + [1968, 2096])
s.label((1968, 0), "+6V")
s.text(2120, 96, "I_6V = input current of both LT3045-1\nand both LTC6655 (simulation 02)", 1)
s.text(DX, DY, ".tran 0 6m 0 5n", 2, True)
s.text(DX, DY + 40, ".param I6=67.9m\n.options plotwinsize=0", 2, True)
s.text(DX, DY + 120, ".save V(+3.3V) V(+6V) V(SW) I(L1) I(V1) V(VC)", 2, True)
s.text(DX, DY + 160, ".meas tran V6_avg AVG V(+6V) FROM 5m TO 6m\n.meas tran V6_pp PP V(+6V) FROM 5m TO 6m\n"
                     ".meas tran I3V3 AVG I(V1) FROM 5m TO 6m\n.meas tran IL_pk MAX I(L1) FROM 5m TO 6m\n"
                     ".meas tran V3V3_pp PP V(+3.3V) FROM 5m TO 6m", 2, True)
s.text(DX, DY + 400, MODELS, 1, True)
s.save("03_Boost_Ripple.asc")

# ============================================================ 04 PSRR
s = Sch(*SHEET)
header(s, "OPEN_PHASE - 04 - PSRR of the analog rails : transfer from +6V ripple to +5VA and +2.5VA",
       "PSRR(dB) = -20*log10|V(rail)/V(+6V)|. Includes the path through the LTC6655 references and the SET filters. 2 MHz = LT8362 switching frequency.")
r6 = six_volt_source(s, "5.96", value2="AC 1", note="+6V with\n1 V AC ripple")
analog_rails(s, r6)
s.text(DX, DY, ".ac dec 50 10 10Meg", 2, True)
s.text(DX, DY + 40, ASBUILT, 2, True)
s.text(DX, DY + 260, ".meas ac PSRR5_1k FIND mag(V(+5VA)) AT 1k\n.meas ac PSRR5_100k FIND mag(V(+5VA)) AT 100k\n"
                     ".meas ac PSRR5_2M FIND mag(V(+5VA)) AT 2Meg\n.meas ac PSRR2V5_1k FIND mag(V(+2.5VA)) AT 1k\n"
                     ".meas ac PSRR2V5_100k FIND mag(V(+2.5VA)) AT 100k\n.meas ac PSRR2V5_2M FIND mag(V(+2.5VA)) AT 2Meg", 2, True)
s.save("04_Analog_Rails_PSRR.asc")


# ============================================================ 05 / 06 measurement channels
def adc_input(s, x, yp, yn, tag, name_p, name_n, rin=("1.2Meg", "1.2Meg")):
    """AD7606C-18 analog input pair: RIN to an internal 2 V node, CIN to AGND (datasheet)."""
    rp = s.part("res", "A", (x, yp), f"RIN_{tag}P", rin[0], rot="R270")
    rn = s.part("res", "A", (x, yn), f"RIN_{tag}N", rin[1], rot="R270")
    xb = rp["B"][0] + 64
    s.wire(rp["B"], (xb, yp), (xb, yn))
    s.wire(rn["B"], (xb, yn))
    vb = s.part("voltage", "+", (xb, yn), f"VB_{tag}", "2",
                windows=["WINDOW 0 24 56 Left 2", "WINDOW 3 24 84 Left 2"])
    s.gnd(vb["-"])
    s.shunt_cap(x - 144, yp, f"CIN_{tag}P", "5p")
    s.shunt_cap(x - 240, yn, f"CIN_{tag}N", "5p")
    s.label((x - 336, yp), name_p)
    s.label((x - 336, yn), name_n)
    s.text(x - 160, yp - 104, f"AD7606C-18 {name_p[:-1]}+ / {name_p[:-1]}- input pins\n"
                              "(RIN 1.2 Meg to an internal 2 V node, CIN 5 pF)", 1)
    return x - 336, x - 240, x - 144


# One measurement channel pair = shunt + INA241A2 + filter -> one ADC input, divider + filter -> another one.
# The battery channel B (DC bus, battery to ESC) has the same parts and values as the phase channels.
# The four channels are numbered alike: n = 33R, n+1 = 9.1k (current filter), n+2 / n+3 = divider,
# n+4 = 9.1k (voltage filter), with n = 15 (U), 20 (V), 25 (W), 30 (B), and Re1 ... Re4.
PHASE_U = {"what": "phase U", "in": "IN-U", "out": "OUT-U", "sng": "SNG-A1N", "tags": ("I", "V"),
           "rsh": "R1", "lsh": "L_SH", "ic": "IC2", "rs": "R15", "cf": "C25", "rg": "R16", "adc_i": "V8",
           "rt": "R17", "rb": "R18", "re": "Re1", "cv": "C31", "rgv": "R19", "adc_v": "V7"}
DC_BUS = {"what": "battery B", "in": "IN-B", "out": "OUT-B", "sng": "SNG-A4N", "tags": ("IB", "VB"),
          "rsh": "R9", "lsh": "L_SHB", "ic": "IC10", "rs": "R30", "cf": "C42", "rg": "R31", "adc_i": "V2",
          "rt": "R32", "rb": "R33", "re": "Re4", "cv": "C40", "rgv": "R34", "adc_v": "V1"}


def channels(s, vph, vph_ac, im, im_ac, pwm=False, motor=None, mc=False, lsh=None, ch=PHASE_U, bus=None,
             supplies=True):
    """One channel pair, by default phase U: shunt R1 + INA241A2 (IC2) -> V8, and divider R17/R18 -> V7
    (sheets INA241 and AD7606C).

    pwm:   the phase source is a behavioural source (PWM expression `vph`).
    motor: {"L", "R", "E"} replaces the ideal current source by a motor phase (L, R, back-EMF source).
    mc:    every value is drawn inside its tolerance (Monte Carlo, see the .param lines of simulation 08).
    lsh:   inductance of the shunt, in series with R1 between the two Kelvin taps.
    ch:    names of the parts and nets of the channel pair (PHASE_U or DC_BUS).
    bus:   {"V", "R", "L", "C", "Cline", "I"} draws the DC bus instead of a phase: battery with its
           resistance and lead inductance before the shunt, ESC input capacitor and ESC current after it.
    """
    def tol(nominal, param):
        return "{%s}" % param if mc else nominal

    # --- conductor: source -> shunt -> load (phase: J1 -> J2, DC bus: battery -> ESC)
    if bus:
        v = s.part("voltage", "+", (-336, 0), "V_BAT", bus["V"],
                   windows=["WINDOW 0 -112 40 Left 2", "WINDOW 3 -112 68 Left 2"])
        s.gnd(v["-"])
        rb = s.part("res", "A", (-272, 0), "R_BAT", bus["R"], rot="R270")
        lb = s.part("ind", "A", (-144, 0), "L_BAT", bus["L"], rot="R270", spiceline="Rser=0")
        s.wire(v["+"], rb["A"])
        s.wire(rb["B"], lb["A"])
        s.wire(lb["B"], (0, 0))
        s.text(-448, 152, "Battery and its leads\n(resistance and inductance: assumed)", 1)
    else:
        if pwm:
            v = s.part("bv", "+", (0, 0), "B_PH", vph,
                       windows=["WINDOW 0 -112 40 Left 2", "WINDOW 3 -560 88 Left 1"])
        else:
            v = s.part("voltage", "+", (0, 0), "V_PH", vph, value2=vph_ac,
                       windows=["WINDOW 0 -112 40 Left 2", "WINDOW 3 -232 88 Left 1", "WINDOW 123 -232 112 Left 1"])
        s.gnd(v["-"])
        s.text(-232, 152, "ESC phase U\n(J1 pin 1)", 1)
    r1 = s.part("res", "A", (160, 0), ch["rsh"], tol("1m", ch["rsh"] + "v"), rot="R270")
    s.bus(0, [0, 96, 160])
    tap = r1["B"][0]                                   # Kelvin tap of IN+, load side of the shunt
    if lsh:
        tap = s.part("ind", "A", (tap, 0), ch["lsh"], lsh, rot="R270", spiceline="Rser=0")["B"][0]
    if bus:
        s.shunt_cap(864, 0, "C_DC", bus["C"], bus["Cline"])
        i = s.part("bi", "+", (1056, 0), "B_ESC", bus["I"],
                   windows=["WINDOW 0 24 16 Left 2", "WINDOW 3 -160 -136 Left 1"])
        s.gnd(i["-"])
        s.bus(0, [tap, 720, 864, 1056])
        s.text(784, -88, "ESC: input capacitor (assumed) and DC side of the three half-bridges", 1)
    elif motor:
        lm = s.part("ind", "A", (784, 0), "L_M", motor["L"], rot="R270", spiceline="Rser=0")
        rm = s.part("res", "A", (912, 0), "R_M", motor["R"], rot="R270")
        vb = s.part("voltage", "+", (1056, 0), "V_BEMF", motor["E"],
                    windows=["WINDOW 0 24 16 Left 2", "WINDOW 3 24 104 Left 1"])
        s.gnd(vb["-"])
        s.bus(0, [tap, 720, 784])
        s.wire(lm["B"], rm["A"])
        s.wire(rm["B"], vb["+"])
        s.text(784, -88, "Motor phase U (J2 pin 3): inductance, resistance, back-EMF around Vbat / 2", 1)
    else:
        i = s.part("current", "+", (304, 0), "I_M", im, value2=im_ac,
                   windows=["WINDOW 0 24 16 Left 2", "WINDOW 3 24 44 Left 1", "WINDOW 123 24 68 Left 1"])
        s.gnd(i["-"])
        s.text(336, -88, "I_M = motor phase current (J2 pin 3)", 1)
        s.bus(0, [tap, 304, 720])
    s.label((96, 0), ch["in"])
    s.label((720, 0), ch["out"])
    s.text(144, -88, f"PBV-R001 shunt, {ch['lsh']} = its inductance (datasheet: < 10 nH)" if lsh else "PBV-R001 shunt", 1)
    # --- INA241A2, Kelvin connection
    u = s.part("INA241A2_behav", "IN+", (384, 256), ch["ic"],
               spiceline="G={mc(20,tolG)} Vos={flat(15u)}" if mc else None)
    s.wire((tap, 0), (tap, 256), u["IN+"])
    s.wire((160, 0), (160, 352), u["IN-"])
    s.wire(u["VS"], (512, 160))
    s.label((512, 160), "+5VA")
    s.gnd(u["GND"], 16)
    s.wire(u["REF1"], (448, 464), (576, 464), u["REF2"])
    s.wire((576, 464), (640, 464))
    s.label((640, 464), "+2.5VA")
    # --- current channel filter (phase U: R15 / C25 / R16 -> V8+ / V8-)
    YP, YN = 304, 432
    s.wire(u["OUT"], (688, YP))
    s.label((688, YP), ch["sng"])
    r13 = s.part("res", "A", (736, YP), ch["rs"], tol("33", ch["rs"] + "v"), rot="R270")
    s.wire((688, YP), r13["A"])
    c25 = s.part("cap", "A", (912, YP), ch["cf"], "1n")
    s.wire(c25["B"], (912, YN))
    r15 = s.part("res", "A", (784, YN), ch["rg"], tol("9.1k", ch["rg"] + "v"))
    s.gnd(r15["B"])
    xl, xcn, xcp = adc_input(s, 1392, YP, YN, ch["tags"][0], ch["adc_i"] + "+", ch["adc_i"] + "-",
                             (tol("1.2Meg", "RiP"), tol("1.2Meg", "RiN")))
    s.bus(YP, [r13["B"][0], 912, xl, xcp, 1392])
    s.bus(YN, [784, 912, xl, xcn, 1392])
    s.text(0, -216, "CURRENT CHANNEL  ({what} : {rsh}, {ic}, {rs}, {cf}, {rg} -> AD7606C {adc_i})".format(**ch), 3)
    # --- voltage channel (phase U: R17 / R18 / Re1 / C31 / R19 -> V7+ / V7-)
    YP, YN = 800, 928
    s.label((96, YP), ch["out"])
    r27 = s.part("res", "A", (160, YP), ch["rt"], tol("40.2k", ch["rt"] + "v"), rot="R270")
    s.wire((96, YP), r27["A"])
    r28 = s.part("res", "A", (336, YP), ch["rb"], tol("10k", ch["rb"] + "v"))
    s.gnd(r28["B"])
    re2 = s.part("res", "A", (432, YP), ch["re"], tol("1k", ch["re"] + "v"), rot="R270")
    s.bus(YP, [r27["B"][0], 336, 432])
    c31 = s.part("cap", "A", (912, YP), ch["cv"], "180p")
    s.wire(c31["B"], (912, YN))
    r19 = s.part("res", "A", (784, YN), ch["rgv"], tol("9.1k", ch["rgv"] + "v"))
    s.gnd(r19["B"])
    xl, xcn, xcp = adc_input(s, 1392, YP, YN, ch["tags"][1], ch["adc_v"] + "+", ch["adc_v"] + "-",
                             (tol("1.2Meg", "RvP"), tol("1.2Meg", "RvN")))
    s.bus(YP, [re2["B"][0], 912, xl, xcp, 1392])
    s.bus(YN, [784, 912, xl, xcn, 1392])
    s.text(0, 664, "VOLTAGE CHANNEL  ({what} : {rt}, {rb}, {re}, {cv}, {rgv} -> AD7606C {adc_v})".format(**ch), 3)
    # --- supplies
    if not supplies:
        return
    for x, n, val, lab in ((-320, "V_5VA", "5", "+5VA"), (-176, "V_2V5A", "{V25}" if mc else "2.5", "+2.5VA")):
        v = s.part("voltage", "+", (x, 432), n, val,
                   windows=["WINDOW 0 -40 120 Left 2", "WINDOW 3 -40 148 Left 2"])
        s.wire(v["+"], (x, 400))
        s.label((x, 400), lab)
        s.gnd(v["-"])
    s.text(-400, 616, "Ideal analog rails\n(see 02 for the real ones)", 1)


s = Sch(2100, 1500)
header(s, "OPEN_PHASE - 05 - Measurement channels : frequency response (shunt / divider -> AD7606C pins)",
       "k = 1 : AC on the phase current (current channel, V/A).  k = 0 : AC on the phase voltage (voltage channel, V/V).")
channels(s, "12", "AC {1-k}", "0", "AC {k}")
s.text(-400, 1120, ".ac dec 100 10 10Meg\n.step param k list 0 1", 2, True)
s.text(-400, 1200, ".meas ac G_I FIND mag(V(V8+,V8-)) AT 10\n.meas ac F3dB_I WHEN mag(V(V8+,V8-))=G_I/sqrt(2)\n"
                   ".meas ac G_I_24k FIND mag(V(V8+,V8-)) AT 24k\n.meas ac G_I_2M FIND mag(V(V8+,V8-)) AT 2Meg", 2, True)
s.text(640, 1200, ".meas ac G_V FIND mag(V(V7+,V7-)) AT 10\n.meas ac F3dB_V WHEN mag(V(V7+,V7-))=G_V/sqrt(2)\n"
                  ".meas ac G_V_24k FIND mag(V(V7+,V7-)) AT 24k\n.meas ac G_V_2M FIND mag(V(V7+,V7-)) AT 2Meg", 2, True)
s.save("05_Measurement_Channels_AC.asc")

s = Sch(2100, 1500)
header(s, "OPEN_PHASE - 06 - Measurement channels : DC transfer and step response",
       "Phase voltage steps 0 -> 25.2 V (6S battery) at 100 us, phase current steps 0 -> 35 A (MR60 rating, J1 -> J2) at 300 us.")
channels(s, "PWL(0 0 100u 0 100.1u 25.2)", None, "PWL(0 0 300u 0 300.1u 35)", None)
s.text(-400, 1120, ".tran 0 600u 0 20n", 2, True)
s.text(-400, 1160, ".meas tran VI_zero AVG V(V8+,V8-) FROM 50u TO 90u\n.meas tran VI_35A AVG V(V8+,V8-) FROM 550u TO 600u\n"
                   ".meas tran V8N_bias AVG V(V8-) FROM 550u TO 600u\n.meas tran T_I_1pct WHEN V(V8+,V8-)=VI_zero+0.99*(VI_35A-VI_zero) FALL=1", 2, True)
s.text(720, 1160, ".meas tran VV_zero AVG V(V7+,V7-) FROM 50u TO 90u\n.meas tran VV_25V AVG V(V7+,V7-) FROM 250u TO 290u\n"
                  ".meas tran VOUTU AVG V(OUT-U) FROM 250u TO 290u\n.meas tran T_V_1pct WHEN V(V7+,V7-)=VV_zero+0.99*(VV_25V-VV_zero) RISE=1", 2, True)
s.save("06_Measurement_Channels_Step.asc")

# ============================================================ 07 / 08 measurement quality
# 07: what the ADC pins see for a realistic ESC waveform. The phase voltage (PWM) and the motor
# current (R-L + back-EMF, so it carries the real PWM ripple) are the reference; run_simulations.py
# compares them with the readings and writes measurement_quality.md.
# The battery channel (battery -> R9 -> ESC) is loaded by the three half-bridges together: phases V
# and W are the same single-phase equivalent as phase U, 120 and 240 degrees later, and B_ESC draws
# from the bus the power that the three of them deliver.
def other_phases(s):
    """Phases V and W, power path only: PWM source, motor phase (with its shunt), back-EMF."""
    for k, (ph, deg) in enumerate((("V", 120), ("W", 240))):
        y = 240 * k
        v = s.part("bv", "+", (0, y), f"B_PH{ph}", "V={Vbat}*limit(0,1,0.5+{kedge}*(V(MOD%s)-V(CAR)))" % ph,
                   windows=["WINDOW 0 -112 40 Left 2", "WINDOW 3 -560 88 Left 1"])
        s.gnd(v["-"])
        lm = s.part("ind", "A", (160, y), f"L_M{ph}", "{Lm+Lsh}", rot="R270", spiceline="Rser=0")
        rm = s.part("res", "A", (288, y), f"R_M{ph}", "{Rm+1m}", rot="R270")
        vb = s.part("voltage", "+", (432, y), f"V_BEMF{ph}", "SINE({Vbat/2} {Eb} {fe} 0 0 -%d)" % deg,
                    windows=["WINDOW 0 24 16 Left 2", "WINDOW 3 24 104 Left 1"])
        s.gnd(vb["-"])
        s.bus(y, [0, 96, 160])
        s.wire(lm["B"], rm["A"])
        s.wire(rm["B"], vb["+"])
        s.label((96, y), f"IN-{ph}")
        m = s.part("voltage", "+", (896, y + 32), f"V_MOD{ph}", "SINE(0.5 {m/2} {fe} 0 0 {phi-%d})" % deg,
                   windows=["WINDOW 0 24 56 Left 2", "WINDOW 3 24 84 Left 1"])
        s.wire(m["+"], (896, y))
        s.label((896, y), f"MOD{ph}")
        s.gnd(m["-"])
    s.text(-560, -176, "PHASES V AND W  (power path only, to load the DC bus)", 3)
    s.text(-560, -112, "Same PWM and same motor phase as U, 120 and 240 degrees later.\n"
                       "L_MV, L_MW and R_MV, R_MW include the shunts R4 and R7.", 1)


s = Sch(4700, 1900)
header(s, "OPEN_PHASE - 07 - Measurement quality : ESC waveforms through the phase U and battery channels",
       "The phase voltage, the motor current, the DC bus voltage and the battery current are the reference. "
       "run_simulations.py compares them with what the AD7606C pins see.")
channels(s, "V={Vbat}*limit(0,1,0.5+{kedge}*(V(MOD)-V(CAR)))", None, None, None, pwm=True,
         motor={"L": "{Lm}", "R": "{Rm}", "E": "SINE({Vbat/2} {Eb} {fe})"}, lsh="{Lsh}")
s.at(2800, 0)
channels(s, None, None, None, None, lsh="{Lsh}", ch=DC_BUS, supplies=False,
         bus={"V": "{Vbat}", "R": "{Rb}", "L": "{Lb}", "C": "{Cdc}", "Cline": "Rser={Resr} IC={Vbat}",
              "I": "I=(V(IN-U)*I(L_M)+V(IN-V)*I(L_MV)+V(IN-W)*I(L_MW))/max(V(OUT-B),1)"})
s.text(784, 120, "B_ESC: the DC bus supplies the power that the three half-bridges deliver to the phases", 1)
s.at(3100, 1320)
other_phases(s)
s.at(0, 0)
for x, n, val, lab, wy in ((-320, "V_MOD", "SINE(0.5 {m/2} {fe} 0 0 {phi})", "MOD", 148),
                           (-176, "V_CAR", "PULSE(0 1 0 {0.5/fpwm} {0.5/fpwm} 0 {1/fpwm})", "CAR", 176)):
    v = s.part("voltage", "+", (x, 832), n, val,
               windows=["WINDOW 0 -40 120 Left 2", f"WINDOW 3 -40 {wy} Left 1"])
    s.wire(v["+"], (x, 800))
    s.label((x, 800), lab)
    s.gnd(v["-"])
s.text(-400, 1040, "PWM modulator: sine reference (MOD) against a triangle carrier (CAR)", 1)
s.text(-400, 1120, ".tran 0 8m 0 50n uic\n.options plotwinsize=0\n.step param Lsh list 1p 5n 10n", 2, True)
s.text(-400, 1250, ".param Vbat=25.2 fpwm=24k fe=1k m=0.774 phi=22.7 kedge=200\n.param Lm=30u Rm=50m Eb=8\n"
                   ".param Rb=20m Lb=300n Cdc=470u Resr=30m", 2, True)
s.text(-400, 1390, "6S battery, 24 kHz PWM, 1 kHz electrical frequency. Three runs: shunts without inductance, 5 nH, 10 nH.\n"
                   "20 A peak in phase with the back-EMF: 90 W in each phase, PWM ripple of about 8 A pp.\n"
                   "DC bus: battery and leads 20 mOhm / 300 nH, ESC input capacitor 470 uF / 30 mOhm.\n"
                   "These four values are assumed (no battery or ESC is specified in the project).", 2)
s.text(720, 1120, ".save V(IN-U) V(OUT-U) I(L_M) V(V8+) V(V8-) V(V7+) V(V7-)\n"
                  ".save V(OUT-B) I(L_BAT) V(V2+) V(V2-) V(V1+) V(V1-)", 2, True)
s.save("07_Measurement_Quality_Waveforms.asc")

# 08: spread of the DC readings when every tolerance is drawn again (before any calibration).
s = Sch(2100, 1500)
header(s, "OPEN_PHASE - 08 - Measurement quality : Monte Carlo on the tolerances (phase U, DC readings)",
       "Each run draws every tolerance again. The readings at 0 / 35 A and 0 / 25.2 V give the spread of offset and gain before calibration.")
channels(s, "0", None, "0", None, mc=True)
s.text(-400, 1120, ".dc I_M 0 35 35 V_PH 0 25.2 25.2\n.step param run 1 1000 1", 2, True)
s.text(-400, 1200, ".param tolSh=0.005 tolR=0.01 tolG=100u tolRin=0.167\n"
                   ".param R1v={mc(1m,tolSh)} R15v={mc(33,tolR)} R16v={mc(9.1k,tolR)}\n"
                   ".param R17v={mc(40.2k,tolR)} R18v={mc(10k,tolR)} Re1v={mc(1k,tolR)} R19v={mc(9.1k,tolR)}\n"
                   ".param RiP={mc(1.2Meg,tolRin)} RiN={mc(1.2Meg,tolRin)} RvP={mc(1.2Meg,tolRin)} RvN={mc(1.2Meg,tolRin)}\n"
                   ".param R11v={mc(1k,tolR)} R12v={mc(24.9k,tolR)} Iset={mc(100u,0.02)}\n"
                   ".param V25={(2.5*(1+flat(250u))/R11v+Iset)/(1/R11v+1/R12v)+flat(2m)}", 2, True)
s.text(-400, 1450, "tolSh: PBV shunt 0.5 %.  tolR: resistors, 1 % assumed.  IC2: gain 20 V/V +/-0.01 %, offset +/-15 uV (INA241A2 datasheet maximum).\n"
                   "RiP, RiN, RvP, RvN: AD7606C input resistances, 1.0 ... 1.4 Meg.  V25: +2.5VA from the LTC6655B (0.025 %), the SET network\n"
                   "(ISET 100 uA +/-2 %, R11, R12) and the LT3045-1 offset (+/-2 mV).", 1)
s.text(720, 1120, ".save V(IN-U) V(OUT-U) V(V8+) V(V8-) V(V7+) V(V7-) V(+2.5VA)", 2, True)
s.save("08_Measurement_Quality_Tolerances.asc")
print("ok")
