foukouda/OPEN_PHASE/Simulation/LTspice/plotstyle.py

"""Figure style shared by run_simulations.py and measurement_quality.py."""
import os

import matplotlib

matplotlib.use("Agg")
import matplotlib.pyplot as plt  # noqa: E402

HERE = os.path.dirname(os.path.abspath(__file__))
FIG_DIR = os.path.normpath(os.path.join(HERE, "..", "..", "Images", "Simulation"))

# reference palette (light), fixed categorical order
C1, C2, C3, C4 = "#2a78d6", "#eb6834", "#1baf7a", "#eda100"
SURFACE, INK, INK2, GRID = "#fcfcfb", "#0b0b0b", "#52514e", "#e4e3df"

plt.rcParams.update({
    "figure.facecolor": SURFACE, "axes.facecolor": SURFACE, "savefig.facecolor": SURFACE,
    "axes.edgecolor": INK2, "axes.labelcolor": INK, "xtick.color": INK2, "ytick.color": INK2,
    "text.color": INK, "axes.grid": True, "grid.color": GRID, "grid.linewidth": 0.8,
    "axes.spines.top": False, "axes.spines.right": False, "lines.linewidth": 2,
    "font.size": 10, "axes.titlesize": 11, "axes.titleweight": "bold", "legend.frameon": False,
})


def save(fig, fname):
    os.makedirs(FIG_DIR, exist_ok=True)
    fig.savefig(os.path.join(FIG_DIR, fname), dpi=130, bbox_inches="tight")
    plt.close(fig)
    print(f"  figure: Images/Simulation/{fname}")
