foukouda/OPEN_PHASE/Simulation/LTspice/ltraw.py

"""Minimal reader for LTspice binary .raw files (transient and AC, stepped or not)."""
import numpy as np


def read_raw(path):
    with open(path, "rb") as f:
        data = f.read()
    # header is UTF-16LE (LTspice >= 17), terminated by "Binary:\n"
    marker = "Binary:\n".encode("utf-16-le")
    idx = data.find(marker)
    if idx < 0:
        raise ValueError(f"{path}: not a binary LTspice raw file")
    header = data[:idx].decode("utf-16-le")
    body = data[idx + len(marker):]

    names, npts, flags, in_vars = [], 0, "", False
    for line in header.splitlines():
        if line.startswith("No. Points:"):
            npts = int(line.split(":")[1])
        elif line.startswith("Flags:"):
            flags = line.split(":", 1)[1].lower()
        elif line.startswith("Variables:"):
            in_vars = True
        elif in_vars and line.startswith("\t"):
            names.append(line.split("\t")[2])
    nvar = len(names)

    if "complex" in flags:
        arr = np.frombuffer(body, dtype=np.complex128, count=npts * nvar).reshape(npts, nvar)
        out = {n: arr[:, i] for i, n in enumerate(names)}
        out[names[0]] = arr[:, 0].real
    elif "double" in flags:
        arr = np.frombuffer(body, dtype=np.float64, count=npts * nvar).reshape(npts, nvar)
        out = {n: arr[:, i] for i, n in enumerate(names)}
    else:
        # time/frequency as float64, other vectors as float32
        rec = np.dtype([("t", "<f8")] + [(f"v{i}", "<f4") for i in range(1, nvar)])
        arr = np.frombuffer(body, dtype=rec, count=npts)
        out = {names[0]: np.abs(arr["t"])}
        for i in range(1, nvar):
            out[names[i]] = arr[f"v{i}"].astype(np.float64)
    return {k.lower(): v for k, v in out.items()}


def split_steps(d):
    """Split a .step'ed data set into one dict per step (the abscissa restarts)."""
    x = next(iter(d.values()))
    cuts = [0] + [i + 1 for i in range(len(x) - 1) if x[i + 1] < x[i]] + [len(x)]
    return [{k: v[a:b] for k, v in d.items()} for a, b in zip(cuts[:-1], cuts[1:])]
