foukouda/OPEN_PHASE/(commit log)

2026-10-05 Save KiCad 10 design work
    Snapshot of the schematic and PCB work done since the initial template
    commit: AD7606C-18 ADC, 3x INA241A2 + PBV 1 mOhm shunts, MR60PW phase
    connectors, LT8362 boost and LT3045-1 / LTC6655 analog supplies, project
    libraries (lib/) and their sym/fp-lib-table.
    .gitignore now excludes local history, SpinRender working files, the
    stray .step export and Component Search Engine download leftovers.
2026-10-05 Set up KDT template metadata and KiCad 10 CI
    - kibot_main.yaml: COMPANY, LOGO and GIT_URL of the project (OPEN THRUST LAB,
    foukouda/PhaseSense-8586)
    - CI: KiCad 10 (KiBot v2_dk10 image), PRELIMINARY variant until ERC/DRC are
    clean; kibot_launch.sh accepts KiCad 10
    - get_changelog.py: accept "## [Unreleased]" without a date (Revision
    History page) and read CHANGELOG.md as UTF-8
    - .mcp.json: kicad-mcp-pro server configuration
2026-10-05 Rename to PhaseSense-8586, name sheets by function, self-contained library
    Project and sheets
    - INA240.* renamed PhaseSense-8586.* (the amplifier is an INA241 and the
    project name was already PhaseSense-8586 in kibot_main.yaml); symbol and
    sheet instances follow the new project name
    - "Section X - Title X" sheets renamed after their function: AD7606C-18 -
    ADC, INA241 - Phase Current and Voltage Sense, Connectors, Holes -
    Fiducials, Power Supply - Boost 6V and Analog Rails; hierarchical net
    names updated in the PCB (schematic parity unchanged)
    - real titles and dates in the title blocks; Project Architecture and gain
    notes now describe the fitted parts (AD7606C-18, INA241A2 = 20 V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
2026-10-05 Add LTspice simulations of the power chain and the measurement channels
    Simulation/LTspice:
    - 01 power-chain start-up (2 MHz switching), 02 analog rails start-up and
    accuracy (board as built + two corrections of the +2.5VA rail), 03 boost
    ripple, 04 PSRR of both rails, 05/06 current and voltage channels down
    to the AD7606C pins (frequency response, DC transfer, step response)
    - every value comes from the KiCad netlist with the same designators;
    official ADI models for LT8362, LT3045-1, LTC6655; behavioral model
    written from the datasheet for the INA241A2 (no TI LTspice model)
    - generate_asc.py builds the wired schematics, run_simulations.py runs
    LTspice in batch mode, draws Image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
2026-10-05 README/CHANGELOG: document the design from the netlist and the simulations
    - README template (kibot_resources/templates/readme.txt) and README.md
    rewritten for the real board: INA241A2 + AD7606C-18 (the description
    still mentioned INA240 + ADS8586S), channel assignment, power budget,
    sheet descriptions, start-up sequence, simulation results
    - STATUS and DESIGN REVIEW sections list what is not finished and the
    points found against the datasheets (LTC6655LN NR pin, R12 value,
    missing host interface, open AGND/NC pins, input bias offset)
    - CHANGELOG in Keep a Changelog format; [Unreleased] feeds the Revision
    History sheet
2026-10-05 Fill template pages: block diagram, power sequencing, cover notes, architecture
    - Block Diagram redrawn from the real design: phase path (MR60PW, shunts),
    current and voltage channels with their gains and bandwidths, AD7606C-18,
    power chain, target specifications
    - Power - Sequencing: start-up curves taken from the LTspice simulations
    (boost soft-start, analog rails) and rail table with sources, levels
    and timings
    - Cover page: real design notes instead of the template examples
    - Project Architecture: power-supply block documented, contiguous page
    numbers (Power Supply is page 6)
    - Revision History: one column fed by the [Unreleased] changelog section
    - sheet titles shortened so th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
2026-10-10 Fix the +2.5VA reference, add XT60PW-M connectors, predict measurement quality
    - IC3: LTC6655LN-2.5 replaced by the standard LTC6655-2.5, pin 6 is now
    VOUT_S tied to VOUT_F (the LN version has NR on that pin)
    - R12: 49.9k -> 24.9k on the SET pin of IC9, +2.5VA = 2.500 V instead of
    2.549 V; both points removed from the README design review
    - J5, J6: two Amass XT60PW-M added on the Connectors sheet and on the PCB,
    with symbol, footprint and 3D model in lib/. Their power pins are not
    wired yet
    - Simulations 07 (ESC PWM waveforms through both channels) and 08 (Monte
    Carlo on the tolerances), analysed by measurement_quality.py into
    measurement_quality.md; plot style shared in plotstyl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
2026-10-10 Rename the project to OPEN_PHASE
    PhaseSense-8586 was named after the first parts of the design (INA240 +
    ADS8586S), which are no longer on the board. OPEN_PHASE follows
    OPEN_WEIGHT, the other OPEN THRUST LAB board.
    - project files: OPEN_PHASE.kicad_pro / _sch / _pcb / _prl / _dru
    - libraries: lib/lib_sym/OPEN_PHASE.kicad_sym and
    lib/lib_fp/OPEN_PHASE.pretty, nickname OPEN_PHASE in both tables, in
    every lib_id and in every footprint of the PCB
    - project name of every symbol and sheet instance, so the reference
    designators are kept
    - PROJECT_NAME and GIT_URL in the project and in kibot_main.yaml, README
    and its template, CHANGELOG, LTspice headers and their generator
    - the README note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
2026-10-18 Smaller boost inductor, white board, openEMS and thermal simulations
    - L1: Wurth 744373965022 (13.5 x 12.5 mm) -> WE-MAPI 4030 74438357022
    (2.2 uH, 4.1 x 4.1 x 3.1 mm, Isat 4.6 A at -10 %, above the 3.1 A LT8362
    switch limit). Footprint and STEP from the KiCad library, copied to lib/.
    - Board: solder mask white (custom opaque #F4F4F0F5, the KiCad "White"
    preset renders pink over copper), silkscreen black. kibot_globals.yaml
    names the colours so the fabrication notes print WHITE / BLACK.
    - Simulation/openEMS: inductance of the PBV shunts seen by the INA241
    inputs on the routed copper (results.md, figures in Images/Simulation).
    - Simulation/Thermal: current density and temperature of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
2026-10-18 Restyle schematic sheets, new title block logo, WE-MAPI inductor in simulations
    - Schematic sheets: restyled frames, tables and text boxes
    - Title block: INGENIERIE FRANCE logo in KDT_Template_GIT.kicad_wks
    - LTspice: L1 modelled as WE-MAPI 4030 74438357022 (22 mOhm),
    simulations 01 and 03 rerun, README and results updated
2026-10-19 Wire the AD7606C-18 digital side to host header J4, add test points
    - AD7606C-18: software mode (OS0-2 high), serial (PAR/SER SEL high),
    REF SELECT low; CONVST, BUSY, RESET, CS, SCLK, SDI, FRSTDATA and
    DOUTA-D to J4 (2x8 pin header 2.54 mm, horizontal), +3.3V on J4 pin 1
    - AD7606C-18 AGND pin 26 and REFGND pin 46 on GND
    - Test points TP1-TP16: rails, INA241 outputs, CONVST, BUSY
    - Nets renamed SHUNT_*, INA_*, ADC_*; net colours in the project
    - LT3045-1 footprint: thermal vias numbered as exposed pad 13
    - PCB updated from the schematic; ADC_* digital nets not routed yet
    - README template / CHANGELOG: status, J4 pinout, design review 1 and 2
    fixed, new finding 9 (VDRIVE above AVCC + 0.3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
2026-10-23 Add rail indicator LEDs, test point tags and OSHW logo
    - Schematic: D1, D3-D5 rail indicator LEDs on +2.5VA, +5VA, +3.3V and
    +6V. Series resistors R35 750 R, R37 1.5k, R36 3.3k, R38 4.3k: about
    1 mA each with a Wurth 150060RS75000 (red, 1.78 V at 1 mA).
    - PCB F.SilkS: rail name beside each LED (Airborne 0.8 mm knockout).
    - PCB B.SilkS: J4-style tags on the 10 placed test points (pill that
    wraps the pad, net name in Arial Black knockout), OSHW logo LOGO2
    (board only) next to the bottom logo.
    - lib: OSHW-Logo_7.5x8mm_SilkScreen added to the project footprints.
    - Images: 3D spin animation in the blue / white colours.
    DRC and schematic parity counts are unchanged by the silkscreen work.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
2026-10-24 Switch to CERN-OHL-P v2, fix the README logo, redo the 3D animation
    - LICENSE: MIT (template) replaced by the CERN-OHL-P v2 text; README badge,
    specification row and LICENSE section (copyright, source location,
    KDT template credit) updated in the KiBot template and README.md
    - Logos/LOGO.png and HTML/images/logo.png: INGENIERIE FRANCE badge, same
    file as OPEN_WEIGHT, in place of the KDT template placeholder
    - Images/OPEN_PHASE.mp4 and -spin.gif re-rendered with kicad-cli from the
    current board (rail LEDs, J4 header, test point tags, OSHW logo), blue
    mask / white silk on a scratch copy only, same 12 s loop as before
2026-10-25 Add 100 Ohm series resistors on the J4 lines, bottom side
    RN1, RN2 (R_Array_Concave_4x0603, the 4 x 100 Ohm array of OPEN_WEIGHT)
    and R39-R41 (0603) sit inline on the existing B.Cu buses between IC1 and
    J4; only the bus sections around them were redrawn. Element order follows
    the routing: RN2 = DOUTD..DOUTA, R41 = SDI, RN1 = FRSTDATA, SCLK, CS,
    BUSY, R40 = RESET, R39 = CONVST. J4 pinout unchanged.
    Schematic: IC1 keeps its wires with local labels (IC side); the resistor
    block carries the ADC_* global labels (J4 side). TP15 / TP16 move to the
    IC side, where their pads are on the board.
    Fixes a short: the +5VA via of R36 (138.6, 60.2) sat on the ADC_~{CS}
    track; bus B now passes above it.
    DR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
2026-10-25 Add 100k pull-up on ADC CS and pull-downs on CONVST and RESET
    R42 (CS to +3.3V), R43 (CONVST to GND) and R44 (RESET to GND), 100k 0603
    on the AD7606C side, as R8 on OPEN_WEIGHT: the lines stay in a known state
    while the host does not drive them (MCU in reset, wire unplugged).
    Bottom side: R43 and R44 go straight into the B.Cu GND pour; R44 sits at
    the east end of the BUSY / RESET band so the band stays connected. R42
    reaches +3.3V through a new via at (165.8, 64.7) into the In2 +3.3V
    branch, under the IC1 corner (only that via's clearance changes on F.Cu
    and In1).
    DRC 203 = 203, unconnected 4 = 4, parity 16 = 16, ERC unchanged.
2026-10-25 Move the rail LED block down on the Connectors sheet
    D1, D3-D5, R35-R38 and their power symbols moved 44.45 mm down
    (layout only, netlist unchanged).
